morsoth/TFG-FIB/latex/anexo.tex

\appendix
\chapter{Anexo}
Aquí se recogen los documentos y evidencias complementarias que apoyan el contenido del informe.

\includepdf[pages=-,fitpaper=true]{pdfs/PCB Main - Schematic.pdf}

\includepdf[pages=-,fitpaper=true]{pdfs/PCB Main - Layout.pdf}

\includepdf[pages=-,fitpaper=true]{pdfs/Lanza 3D.pdf}
