morsoth/TFG-FIB/latex/references.tex

\begin{thebibliography}{99}

    \bibitem{fib} FIB.
    \textit{Facultad de Informática de Barcelona.} \\
    \url{https://www.fib.upc.edu/}

    \bibitem{upc} UPC.
    \textit{Portal de la Universitat Politécnica de Catalunya.} \\
    \url{https://www.upc.edu/}

    \bibitem{domo21} Domo21.
    \textit{} \\
    \url{https://www.sicma21.com/}
    
    \bibitem{kanban} Wikipedia Commons.
    \textit{Abstract Kanban Board.} \\
    \url{https://commons.wikimedia.org/wiki/File:Abstract_Kanban_Board.svg}

    \bibitem{github} GitHub.
    \textit{} \\
    \url{https://github.com/}

    \bibitem{trello} Trello.
    \textit{} \\
    \url{https://trello.com/}
    
    \bibitem{stm32wb55rg} STMicroelectronics.
    \textit{STM32WB55RG | Product.} \\
    \url{https://www.st.com/en/microcontrollers-microprocessors/stm32wb55rg.html}

    \bibitem{nucleo-wb55rg} STMicroelectronics.
    \textit{NUCLEO-WB55RG | Product.} \\
    \url{https://www.st.com/en/evaluation-tools/nucleo-wb55rg.html}
    
    \bibitem{lux-vs-wm2} EVOLUX.
    \textit{Lux vs W/m².} \\
    \url{https://evolux.cl/lux-vs-wm2}

    \bibitem{an2867} Application Note AN2867.
    \textit{Guidelines for oscillator design on STM8AF/AL/S and STM32 MCUs/MPUs.} \\
    \url{https://www.st.com/resource/en/application_note/an2867-guidelines-for-oscillator-design-on-stm8afals-and-stm32-mcusmpus-stmicroelectronics.pdf}

    \bibitem{an5042} Application Note AN5042.
    \textit{How to calibrate the HSE clock for RF applications on STM32 wireless MCUs.} \\
    \url{https://www.st.com/resource/en/application_note/an5042-how-to-calibrate-the-hse-clock-for-rf-applications-on-stm32-wireless-mcus-stmicroelectronics.pdf}
    
    \bibitem{an5129} Application Note AN5129.
    \textit{Guidelines for meander design using low-cost PCB antennae with 2.4 GHz radio for STM32WB/WB0 MCUs.} \\
    \url{https://www.st.com/resource/en/application_note/an5129-guidelines-for-meander-design-using-lowcost-pcb-antennae-with-24-ghz-radio-for-stm32wbwb0-mcus-stmicroelectron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}

    \bibitem{an6335} Application Note AN6335.
    \textit{MLPF-WB and MLPF-NRG PCB design guidelines and reference hardware.} \\
    \url{https://www.st.com/resource/en/application_note/an6335-mlpfwb-and-mlpfnrg-pcb-design-guidelines-and-reference-hardware-stmicroelectronics.pdf}
    
    \bibitem{an5165} Application Note AN5165.
    \textit{How to develop RF hardware using STM32WB microcontrollers.} \\
    \url{https://www.st.com/resource/en/application_note/an5165-how-to-develop-rf-hardware-using-stm32wb-microcontrollers-stmicroelectronics.pdf}

    \bibitem{spma056} Application Note SPMA056.
    \textit{System Design Guidelines for the TM4C129x Family of Tiva™ C Series Microcontrollers.} \\
    \url{https://www.ti.com/lit/an/spma056/spma056.pdf?ts=1767867045202}

    \bibitem{stm32_pinout} Arm Mbed.
    \textit{NUCLEO-WB55RG.} \\
    \url{https://os.mbed.com/platforms/ST-Nucleo-WB55RG/}
    
    \bibitem{impedance_calc} JLCPCB.
    \textit{Controlled Impedance Calculator.} \\
    \url{https://jlcpcb.com/pcb-impedance-calculator}
    
    \bibitem{jlcpcb_shop} JLCPCB.
    \textit{Assembly Parts Library.} \\
    \url{https://jlcpcb.com/parts/}

    \bibitem{ble_stack_github} GitHub.
    \textit{STMicroelectronics / STM32CubeWB.} \\
    \url{https://github.com/STMicroelectronics/STM32CubeWB/blob/master/Projects/STM32WB_Copro_Wireless_Binaries/STM32WB5x/stm32wb5x_BLE_Stack_full_fw.bin}
    
    \bibitem{stm32_sch} MB1355.
    \textit{NUCLEO-WB55RG schematic.} \\
    \url{https://www.st.com/resource/en/schematic_pack/mb1355-wb55rg-d01_schematic.pdf}

    \bibitem{stm32_datasheet} STM32WB55RG.
    \textit{Datasheet.} \\
    \url{https://www.st.com/resource/en/datasheet/stm32wb55cc.pdf}
    
    \bibitem{aem_datasheet} AEM10941.
    \textit{Datasheet.} \\
    \url{https://e-peas.com/documents/AEM10941/DS-AEM10941.pdf}

    \bibitem{ina_datasheet} INA3221.
    \textit{Datasheet.} \\
    \url{https://www.ti.com/lit/ds/symlink/ina3221.pdf}

    \bibitem{fram_datasheet} MB85RS256B.
    \textit{Datasheet.} \\
    \url{https://www.fujitsu.com/uk/Images/MB85RS256B.pdf}

    \bibitem{tsl_datasheet} TSL2591.
    \textit{Datasheet.} \\
    \url{https://cdn-shop.adafruit.com/datasheets/TSL25911_Datasheet_EN_v1.pdf}
    
    \bibitem{dfr_datasheet} DS18B20.
    \textit{Datasheet.} \\
    \url{https://www.analog.com/media/en/technical-documentation/data-sheets/ds18b20.pdf}
    
    \bibitem{sen_datasheet} SEN0308.
    \textit{Datasheet.} \\
    \url{https://www.farnell.com/datasheets/4376694.pdf}
    
\end{thebibliography}
