morsoth/TFG-FIB/latex/portada.tex

\begin{titlepage}
    \begin{center}
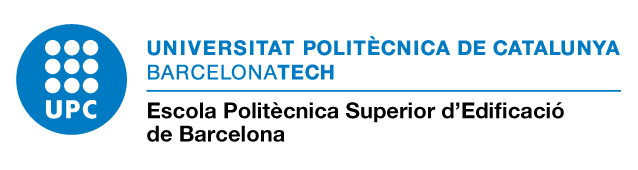
[picture p85: latex/imgs/logo_upc.png]
         
         \hspace{1cm}
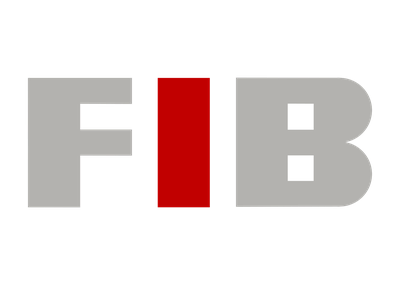
[picture p86: latex/imgs/logo_fib.png]
         
         
         \vspace{6cm}
        
         \large TFG - Memoria \numeroEntrega
        
         \vspace{0.4cm}
        
         \Large \textbf{\tituloTFG}
        
         \vspace{1cm}
        
         \large \autorTFG
        
         \vspace{0.4cm}
        
         \small \fechaEntrega
        
         \vfill
        
         \small Especialidad en Ingeniería de Computadores
        
         \vspace{1cm}
        
         \begin{tabular}{rl}
             \small \textbf{Director:}&\director
         \end{tabular}
    \end{center}
\end{titlepage}
