morsoth/TFG-FIB/multimedia/portada.pdf

id197984

# DISSENY, DESENVOLUPAMENT I PROGRAMACIÓ D'UNA LLANÇA METEOROLÓGICA

PAU ZARAGOZA GALLARDO

Director/a
ANTONIO BENITO MARTÍNEZ VELASCO (Departamento de Ingeniería de Sistemas, Automática e Informática Industrial)

Titulación
Grado en Ingeniería Informática (Ingeniería de Computadores)

Memoria del trabajo de fin de grado

Facultat d'Informàtica de Barcelona (FIB)

Universitat Politècnica de Catalunya (UPC) - BarcelonaTech

20/01/2026
