morsoth/TFG-FIB/latex/imgs/stm32_osc.png

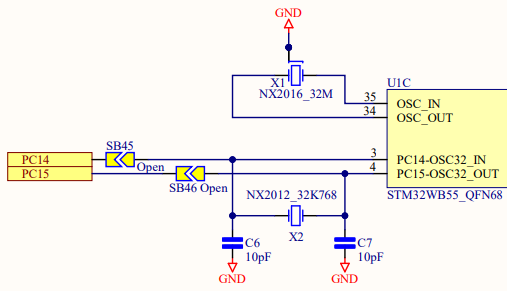
latex/imgs/stm32_osc.png
