morsoth/TFG-FIB/multimedia/photo/circuit_6.jpg

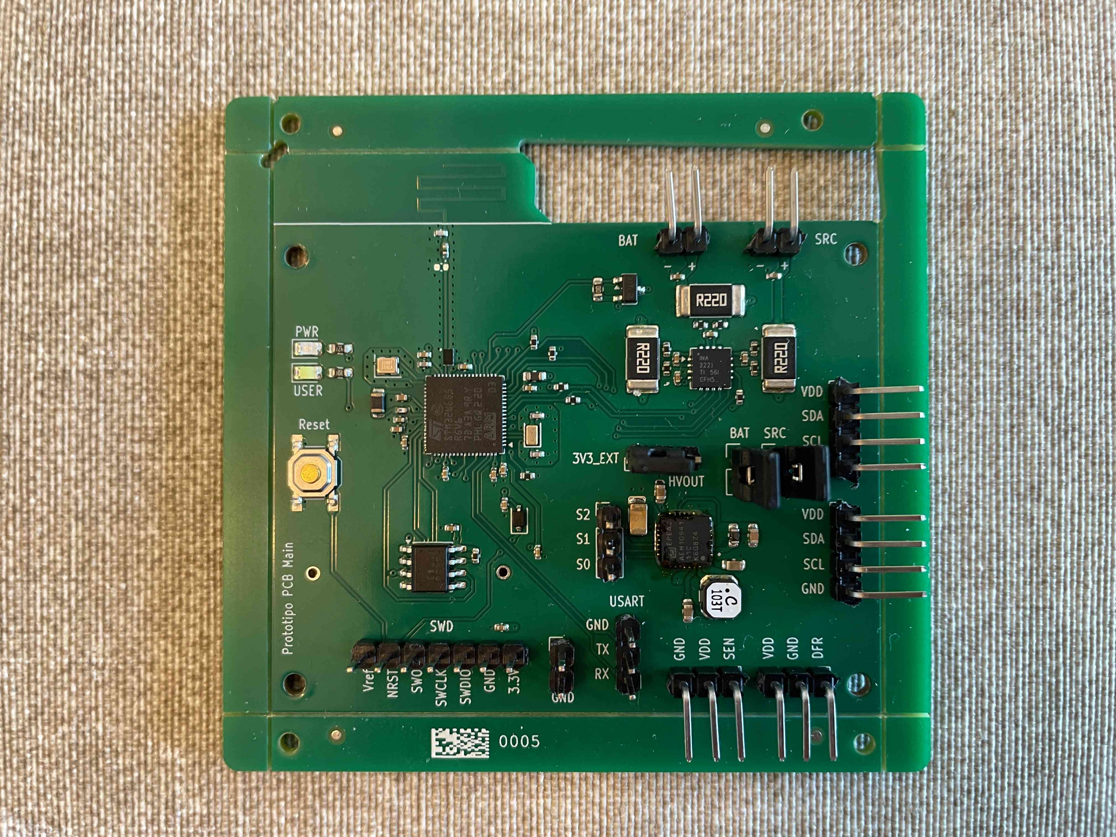
multimedia/photo/circuit_6.jpg
