morsoth/TFG-FIB/docs/Nucleo-WB55RG/Bill of Materials/MB1355-WB55RG-D01_BOM.xlsx

 |  |  |  | Bill of materials
 |  |  |  | Board reference: | MB1355
 |  |  |  | Variant: | WB55
 |  |  |  | PCB revision: | D
 |  |  |  | Assembly revision: | 01
 |  |  |  | Date: | 16-Nov-2020
Designator | Description | Value | Package | Manufacturer | Manufacturer_Part_Number | Fitted | Quantity
C1, C2, C34 | Capacitor, MLCC, 100pF, 50V, NPO, 5%, 0402, T=0,5mm | 100pF | C0402 | YAGEO | CC0402JRNPO9BN101 | Fitted | 3
C3, C12, C14, C16, C17, C18, C19, C20, C24, C25, C26, C27, C28, C31, C32, C33, C41, C42, C43, C46, C47, C48, C49, C50 | Capacitor_not polarized | 100nF | C0402 | YAGEO | 'CC0402KRX7R7BB104 | Fitted | 24
C6, C7 | Capacitor_not polarized | 10pF | C0402 | YAGEO | CC0402JRNPO9BN100 | Fitted | 2
C8 | Capacitor_not polarized | 100nF/25V | C0402 |  |  | Fitted | 1
C9, C10 | Condensateur_polarise | 10uF/25V | C1210 | TDK | C3225X7R1H106M250AC | Fitted | 2
C11 | Condensateur_polarise | 4.7uF/10V | C1210 | AVX | 12101Z475MAT2A | Fitted | 1
C13, C15, C21, C22 | Capacitor_not polarized | 1uF/X5R | C0603 | YAGEO | CC0603KRX5R7BB105 | Fitted | 4
C23, C29 | Capacitor_not polarized | 4.7uF | C0402 | MURATA | GRM155R60J475ME87 | Fitted | 2
C37 | Capacitor_not polarized | 1.2pF | C0402 | MURATA | GJM1555C1H1R2WB01D | Fitted | 1
C44, C45 | Capacitor_not polarized | 20pF | C0402 | YAGEO | CC0402JRNPO9BN200 | Fitted | 2
CN1, CN15 | USB-MICRO-B, 1050170001, SMT, MOLEX | 1050170001 | USBMICROB | MOLEX | 1050170001 | Fitted | 2
CN5 | Header F 1x10x2.54 TH V | HEADER_1X10 | Header F 1x10x2.54 TH V | SAMTEC | SSW-110-01-F-S SSW-110-01-L-S SSW-110-01-G-S | Fitted | 1
CN6, CN9 |  | HEADER_1X8_F | Header F 1x8x2.54 TH V | SAMTEC | SSW-108-01-F-S SSW-108-01-L-S SSW-108-01-G-S | Fitted | 2
CN7, CN10 |  | HEADER_2X19_M | Header M 2x19x2.54 TH M_top + M_bottom | SAMTEC | TSW-119-09-F-D TSW-119-09-L-D TSW-119-09-G-D | Fitted | 2
CN8 |  | HEADER_1X6 | Header F 1x6x2.54 TH V | SAMTEC | SSW-106-01-F-S SSW-106-01-L-S SSW-106-01-G-S | Fitted | 1
CN11, CN12, JP2, JP3, JP4, JP6 |  | HEADER_1X2 | Header M 1x2x2.54 TH V | SAMTEC | TSW-102-07-F-S TSW-102-07-L-S TSW-102-07-G-S | Fitted | 6
D1 | Schottky Diode | BAT54KFILM | SOD523 | ST | BAT54KFILM | Fitted | 1
D2 | Default Diode | BAT60JFILM | SOD-323 | ST | BAT60JFILM | Fitted | 1
JMP1, JMP2, JMP3, JMP4, JMP5, JMP6, JMP7, JMP8, JMP9, JMP10, JMP11, JMP12 | Jumper 2.54mm | SNT-100-BK-G | Jumper 2.54mm BLACK | SAMTEC | SNT-100-BK-G | Fitted | 12
JP1 |  | HEADER_2X4 | Header M 2x4x2.54 TH V | SAMTEC | TSW-104-07-F-D TSW-104-07-L-D TSW-104-07-G-D | Fitted | 1
JP5 |  | HEADER_2X8 | Header M 2x8x2.54 TH V | SAMTEC | TSW-108-07-F-D TSW-108-07-L-D TSW-108-07-G-D | Fitted | 1
L1 | Coil Wurtz 10uH ref: 74479777310A | 10uH | 2x1.25x1.2 mm | WURTH | 74479777310A | Fitted | 1
L2 | SMD Chip ferrite bead, 600R@100MHz +/-25%, 350mA, 500mohm DC, 0603, T=0.8mm | 600R@100MHz | 0603 | TAI-TECH | FCM1608KF-601T03 | Fitted | 1
L3 | Inductor, LQG15H, 3.6nH, +-0.3nH 0402 | 3.6nH | L0402 | MURATA | LQG15HS3N6S02 | Fitted | 1
L4 | Resistor, 0R, 0402 | 0R | 0402 | YAGEO | RC0402JR-070RL | Fitted | 1
L5 | inductor, 10nH +-2%, 100mA max,1.3 ohm DC max, Q min = 13,0402 | 10nH | L0402 | MURATA | LQP15MN10NG02 | Fitted | 1
LED1 | LED Blue, 0603 SMD, 3.3 V Forward Voltage | BLUE | LED 0603 | VISHAY | VLMB1300-GS08 | Fitted | 1
LED2 | LED Green, 0603 SMD, Fw Voltage = 2.8V - 3.6V | TRUE GREEN | LED 0603 | VISHAY | VLMTG1300-GS08 | Fitted | 1
LED3, LED4, LED5 | LED Red, 0603 SMD, 2V Forward Voltage | RED | LED 0603 | VISHAY | VLMS1300-GS08 | Fitted | 3
LED6 | LED Bicolor | LD_BICOLOR_CMS |  | AVAGO | HSMF-A201-A00J1 | Fitted | 1
Q1 | NPN Bipolar Transistor | NPN SOT23 | SOT23 | ON SEMI | BSR14 | Fitted | 1
R1, R19, R23, R24, R32 | Resistor,100K,0402,1%,1/16W | 100K | R0402 | YAGEO | RC0402FR-07100KL | Fitted | 5
R2, R3, R4 | Resistor,680R,0402,1%,1/16W | 680R | R0402 | YAGEO | RC0402FR-07680RL | Fitted | 3
R5 | Resistor, 0R, 0402 | 0R | R0402 | YAGEO | RC0402JR-070RL | Fitted | 1
R6, R11, R16, R18, R22 | Resistor,10K,0402,1%,1/16W | 10K | R0402 | YAGEO | RC0402FR-0710KL | Fitted | 5
R7, R8, R9, R10, R12, R33 | Resistor,1K,0402,1%,1/16W | 1K | R0402 | YAGEO | RC0402FR-071KL | Fitted | 6
R14 | Resistor,2K7,0402,1%,1/16W | 2K7 | R0402 | YAGEO | RC0402FR-072K7L | Fitted | 1
R15, R26, R28 | Resistor,4K7,0402,1%,1/16W | 4K7 | R0402 | YAGEO | RC0402FR-074K7L | Fitted | 3
R17, R25, R27, R29 | Resistor,100R,0402,1%,1/16W | 100R | R0402 | YAGEO | RC0402FR-07100RL | Fitted | 4
R20 | Resistor,36K,0402,1%,1/16W | 36K | R0402 | YAGEO | RC0402FR-0736KL | Fitted | 1
R21 | Resistor,1K5,0402,1%,1/16W | 1K5 | R0402 | YAGEO | RC0402FR-071K5L | Fitted | 1
R31 | Resistor,10R,0402,1%,1/16W | 10R | R0402 | YAGEO | RC0402FR-0710RL | Fitted | 1
SB1, SB5, SB8, SB9, SB11, SB12, SB14, SB15, SB17, SB26, SB32, SB33, SB35, SB36, SB38, SB39, SB41, SB47, SB50 | Resistor, 0R, 0402 | 0R | R0402 | YAGEO | RC0402JR-070RL | Fitted | 19
SC1, SC2, SC3, SC4 | shield clip Harwin S0951-46R to fix RF shielded cavity | S0951-46R |  | HARWIN | S0951-46R | Fitted | 4
SH1 | Shield | RF shield (17,2x17,2x3mm), Brass with Sn finishing, Sheet tickness : 0,2mm | RF shield (17,2x17,2x3mm) | "CUSTOM" | RF shield (17,2x17,2x3x0,2mm) See Description on PBS | Fitted | 1
STICKER_1 | Sticker for FCC_ID 16x5mm | FCC_ID_Sticker_16x5 | Sticker_FCC_ID 16x5mm |  | See Description on PBS | Fitted | 1
STICKER_2 | Sticker_BrdRef 21x5mm | Sticker_BrdRef_21x5 | Sticker_BrdRef_21x5mm |  | See Description on PBS | Fitted | 1
STICKER_3 | Sticker for CPN_FG 16x5mm | Sticker_CPN_FG 16x5 | Sticker_CPN_FG 16x5mm |  | See Description on PBS | Fitted | 1
SW1, SW2, SW3, SW4 | Push-button SMD | KMR231GLFS | SW-PB SMD KMR2 | C&K | KMR231GLFS | Fitted | 4
SW5 | SPDT RA SMT SLIDE SWITCH | SPDT RA SMT SLIDE SWITCH | MLL1200S | TE_Connectivity | MLL1200S | Fitted | 1
U1 | STM32WB55RGV6U | STM32WB55RGV6U | VFQFPN68_8x8x0.1_p0.4 | ST | STM32WB55RGV6U | Fitted | 1
U2 | IC REG LDO 5V 0.8A SOT223 | IC REG LDO 5V 0.8A SOT223 | SOT-223 | ST | LD1117S50TR | Fitted | 1
U3 | 3.3V voltage regulator 500mA | Low quiescent current and low noise voltage regulators | DFN6 3x3mm | ST | LD39050PU33R | Fitted | 1
U4 | Enhanced single channel power switches | 5V Power Switch, 0.85A, RDSon 130mOhm max, with active low enable pin | SOT23_5p | TI | TPS2041CDBVT | Fitted | 1
U5 | 3.3V low drop voltage regulator | Ultra low drop-low noise BiCMOS voltage, regulators low ESR capacitors compatible | LD3985M33R | ST | LD3985M33R | Fitted | 1
U6, U9 | Common mode filter with ESD protection for USB 2.0 interface | Common mode filter with ESD protection for USB 2.0 interface | ECMF02-2AMX6 | ST | ECMF02-2AMX6 | Fitted | 2
U7 | TXS0108E Bi-directional Level Shifter TSSOP20 | 8bits_bidirectionnal level shifter, Delay 312ns/1V8 | TXS0108EPWR | TEXAS INSTRUMENTS | TXS0108EPWR | Fitted | 1
U8 | Medium-density performance line ARM-based 32-bit MCU with 128KB Flash | Medium-density performance line ARM-based 32-bit MCU with 128KB Flash | STM32F103CBT6 | ST | STM32F103CBT6 | Fitted | 1
U10 | Buffer/Driver 1-CH Non-Inverting Open Drain CMOS Automotive 5-Pin TSSOP T/R | Buffer/Driver 1-CH Non-Inverting Open Drain CMOS Automotive 5-Pin TSSOP T/R | TSSOP5 | NEXPERIA | 74LVC1G07GW-Q100 | Fitted | 1
U11, U13 | High power transient voltage suppressor, 7V breakdown | High power transient voltage suppressor, 7V breakdown | D1610 | ST | ESDA7P60-1U1M | Fitted | 2
U12 | 2.4 GHz low pass filter matched to STM32WBx5Cx/Rx | 2.4 GHz low pass filter matched to STM32WBx5Cx/Rx | Bumpless CSP | ST | MLPF-WB55-01E3 | Fitted | 1
X1 | Crystal NDK 2.0x1.6mm 32 MHz | Crystal 32MHz, 8pF, +-10ppm, 60ohms max, SMD | NX2016SA | NDK | NX2016SA 32MHz EXS00A-CS06654 | Fitted | 1
X2 | Crystal NDK 2.0x1.2mm 32.768 KHz | Crystal 32.768kHz, 7pF, +-20ppm, 80Kohms max, SMD | NX2012SA | NDK | NX2012SA 32.768kHz EXS00A-MU00389 | Fitted | 1
X3 | Crystal 8MHz, 8pF, +-20ppm, 500ohms max, SMD | Crystal 8MHz, 8pF, +-20ppm, 500ohms max, SMD | NX3225GD | NDK | NX3225GD 8MHz EXS00A-CG04874 | Fitted | 1
HW1 | PCB MB1355D 4 Layers See Stacking description Solder Mask = White Silkscreen= Blue | MB1355D | N/A |  |  | Fitted | 1
C36, C39, C40 | Capacitor_not polarized |  | C0402 |  |  | Not Fitted | 3
CN3 | Header NF 1x5x2.54 TH | HEADER_1X5 | SIP 1x5x2.54 TH |  |  | Not Fitted | 1
CN4, CN14 | Header NF 1x2x2.54 TH | HEADER_1X2 | SIP 1x2x2.54 TH |  |  | Not Fitted | 2
CN13 |  | HEADER_1X6 | Header NF 1x6x2.54 TH |  |  | Not Fitted | 1
J2 |  | SMA | SMA_T_9.52_NF |  |  | Not Fitted | 1
R13 | Resistor | nc | R0402 |  |  | Not Fitted | 1
R30 | Resistor |  | 0402_RES |  |  | Not Fitted | 1
SB2, SB3, SB4, SB6, SB7, SB10, SB13, SB16, SB18, SB22, SB23, SB24, SB25, SB27, SB28, SB30, SB31, SB34, SB37, SB40, SB42, SB45, SB46, SB48, SB49, SB51 | Resistor, 0R, 0402 | 0R | R0402 | YAGEO | RC0402JR-070RL | Not Fitted | 26
SK_BT1 | Socket for CR2032 Battery | Battery Coin Cell holder, CR2032_20mm, Height 5.4mm | CR2032 holder | RENATA | SMTU2032-LF | Not Fitted | 0
