morsoth/TFG-FIB/docs/Nucleo-WB55RG/Board Manufacturing/MB1355D/MB1355.PcbDoc.htm

Reporting Options

# File in Previous Format

Date | : | 04/12/2025
Time | : | 10:30:36
Filename | : | C:\Users\pzaragoza\Documents\GitHub\TFG-FIB\docs\Nucleo-WB55RG\Board Manufacturing\MB1355D\MB1355.PcbDoc

Version | Warning

This file was generated by an earlier version of the software
