morsoth/TFG-FIB/pcb/Harvest Testing/Harvest Testing PCB Bottom.png

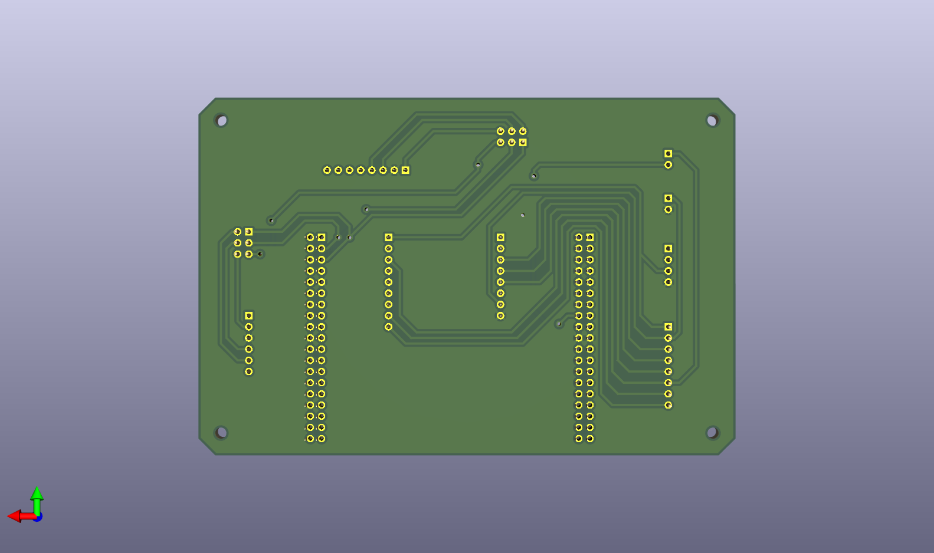
pcb/Harvest Testing/Harvest Testing PCB Bottom.png
