morsoth/TFG-FIB/pcb/Harvest Testing/Harvest Testing PCB Top.png

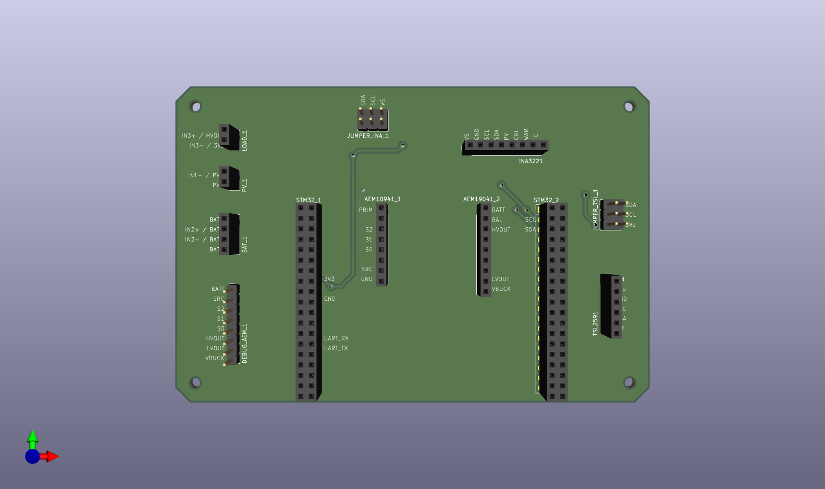
pcb/Harvest Testing/Harvest Testing PCB Top.png
