morsoth/TFG-FIB/latex/pdfs/PCB Main - Schematic.pdf

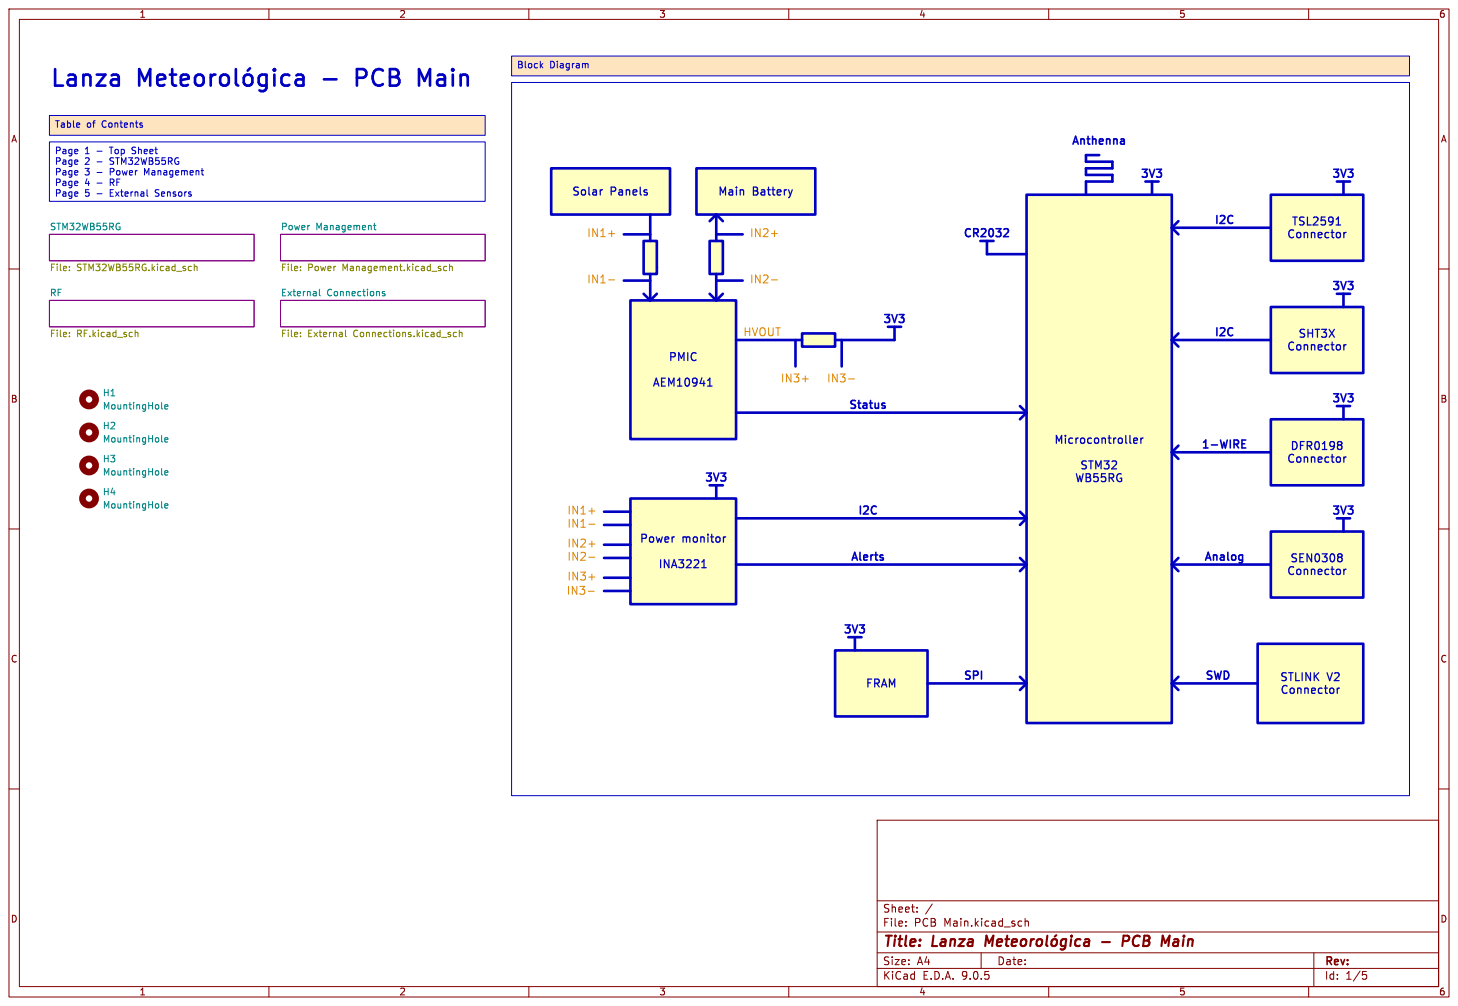
[picture p93: page 1]

Lanza þÿMeteorológica - PCB Main

Page 1 - Top Sheet Page 2 - STM32WB55RG

External Connections File: External Connections.kicad_sch Power Management File: Power Management.kicad_sch RF

File: STM32WB55RG.kicad_sch H1 MountingHole H2 MountingHole H3 MountingHole H4 MountingHole

Id: 1/5 Title: Lanza þÿMeteorológica - PCB Main

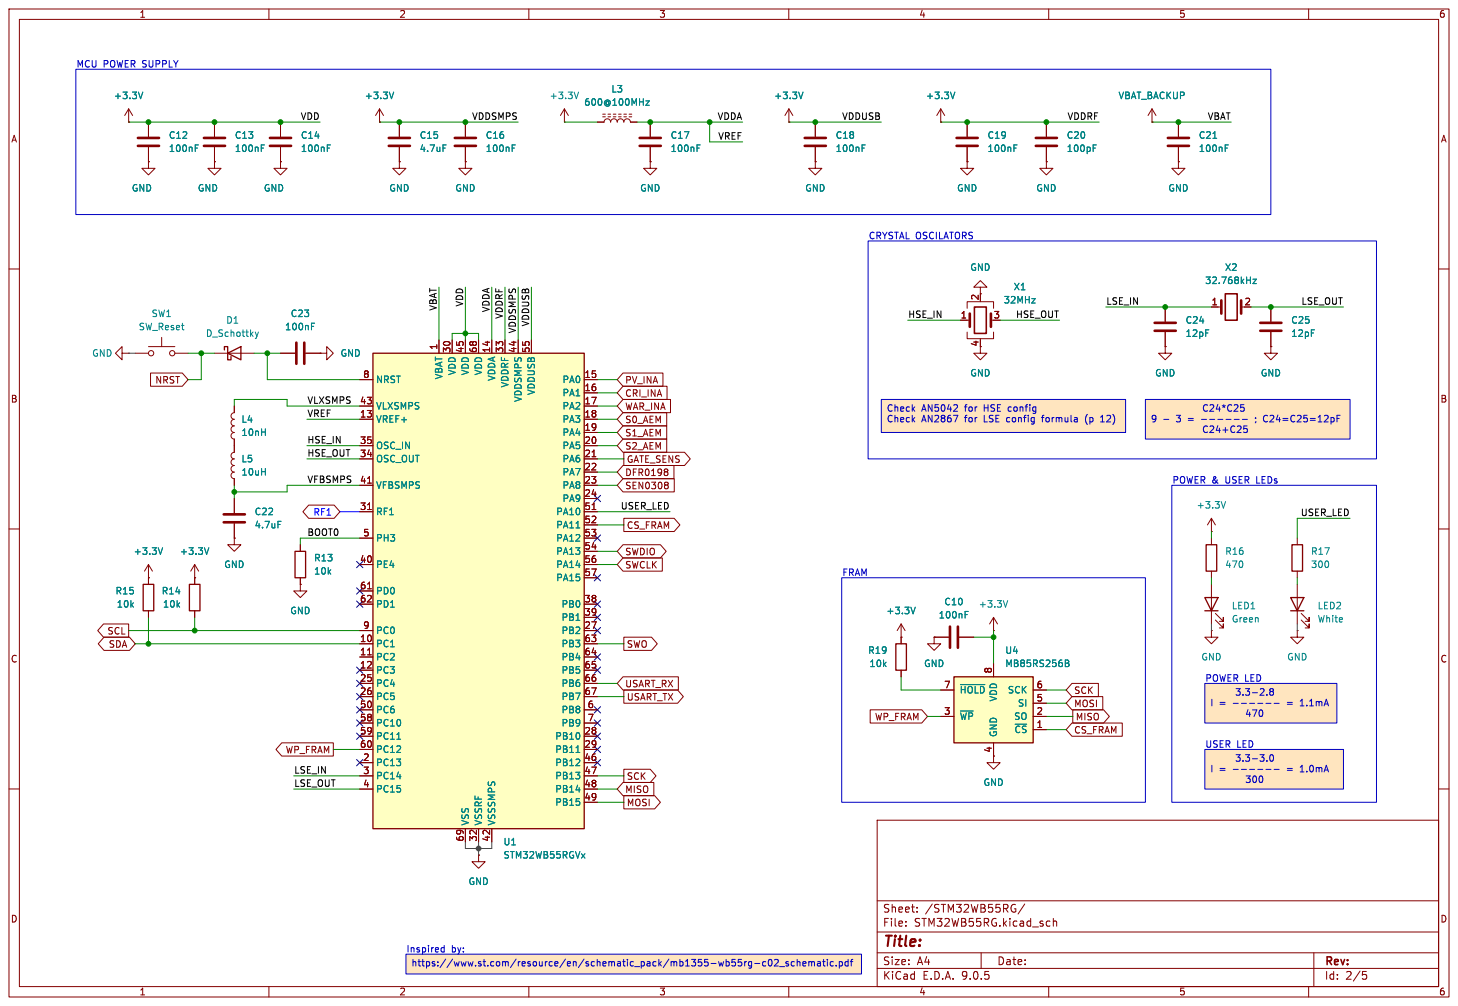
[picture p94: page 2]

POWER & USER LEDs POWER LED GND

1 VDD 30 VDD 45 VSS 69 VDD 68 VSSRF 32 VDDA 14 VSSSMPS 42 VDDRF 33 VDDSMPS 44 VDDUSB 55 PA0 15 PA1 16 PA2 17 PA3 18 PA4 19 PA5 20 PA6 21 PA7 22 PA8 23 PA9 24 PA10 51 PA11 52 PA12 53 PA13 54 PA14 56 PA15 57 PB0 38 PB1 39 PB2 27 PB3 63 PB4 64 PB5 65 PB6 66 PB7 67 PB8 6 PB9 7 PB10 28 PB11 29 PB12 46 PB13 47 PB14 48 PB15 49 U1STM32WB55RGVx

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

4 SCK 6 SI 5 SO 2 ~{CS}1 U4 MB85RS256B C10

4 SCK 6 SI 5 SO 2 ~{CS}1 C10

Id: 2/5 Title: File: STM32WB55RG.kicad_sch Sheet: /STM32WB55RG/ GND

Inspired by:
https://www.st.com/resource/en/schematic_pack/mb1355-wb55rg-c02_schematic.pdf

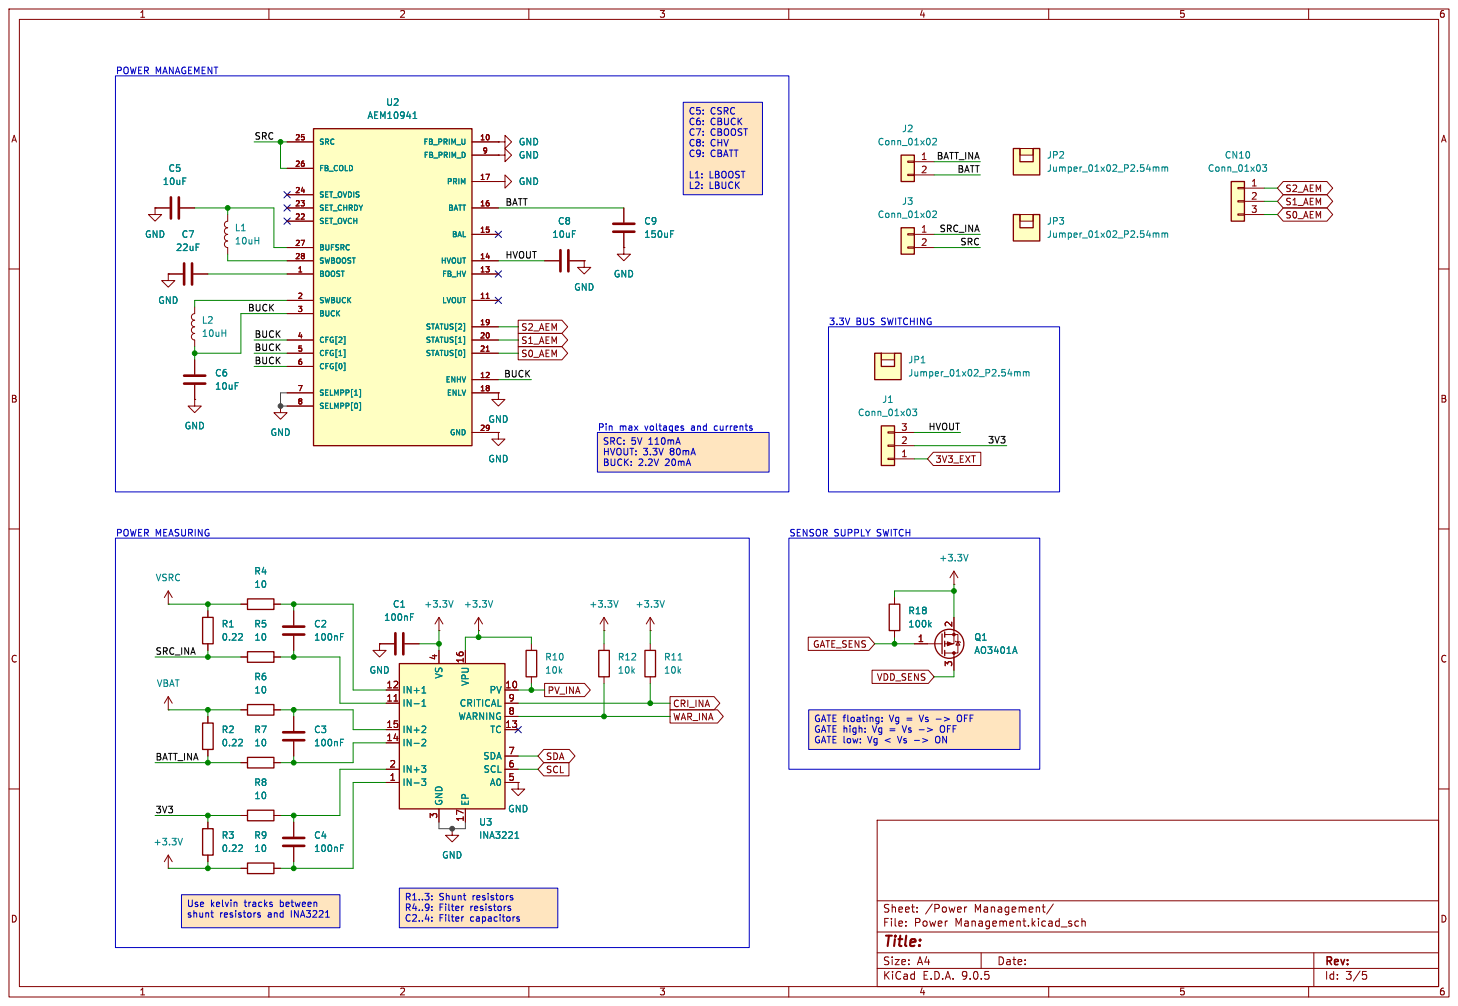
[picture p95: page 3]

BATT_INA C5: CSRC
C6: CBUCK C7: CBOOST C8: CHV C9: CBATT

BUCK: 2.2V 20mA R1..3: Shunt resistors R4..9: Filter resistors C2..4: Filter capacitors Use kelvin tracks between

3 VPU 16 EP 17 PV 10 CRITICAL 9 WARNING 8 TC 13 SDA 7 SCL 6 A0 5 U3

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

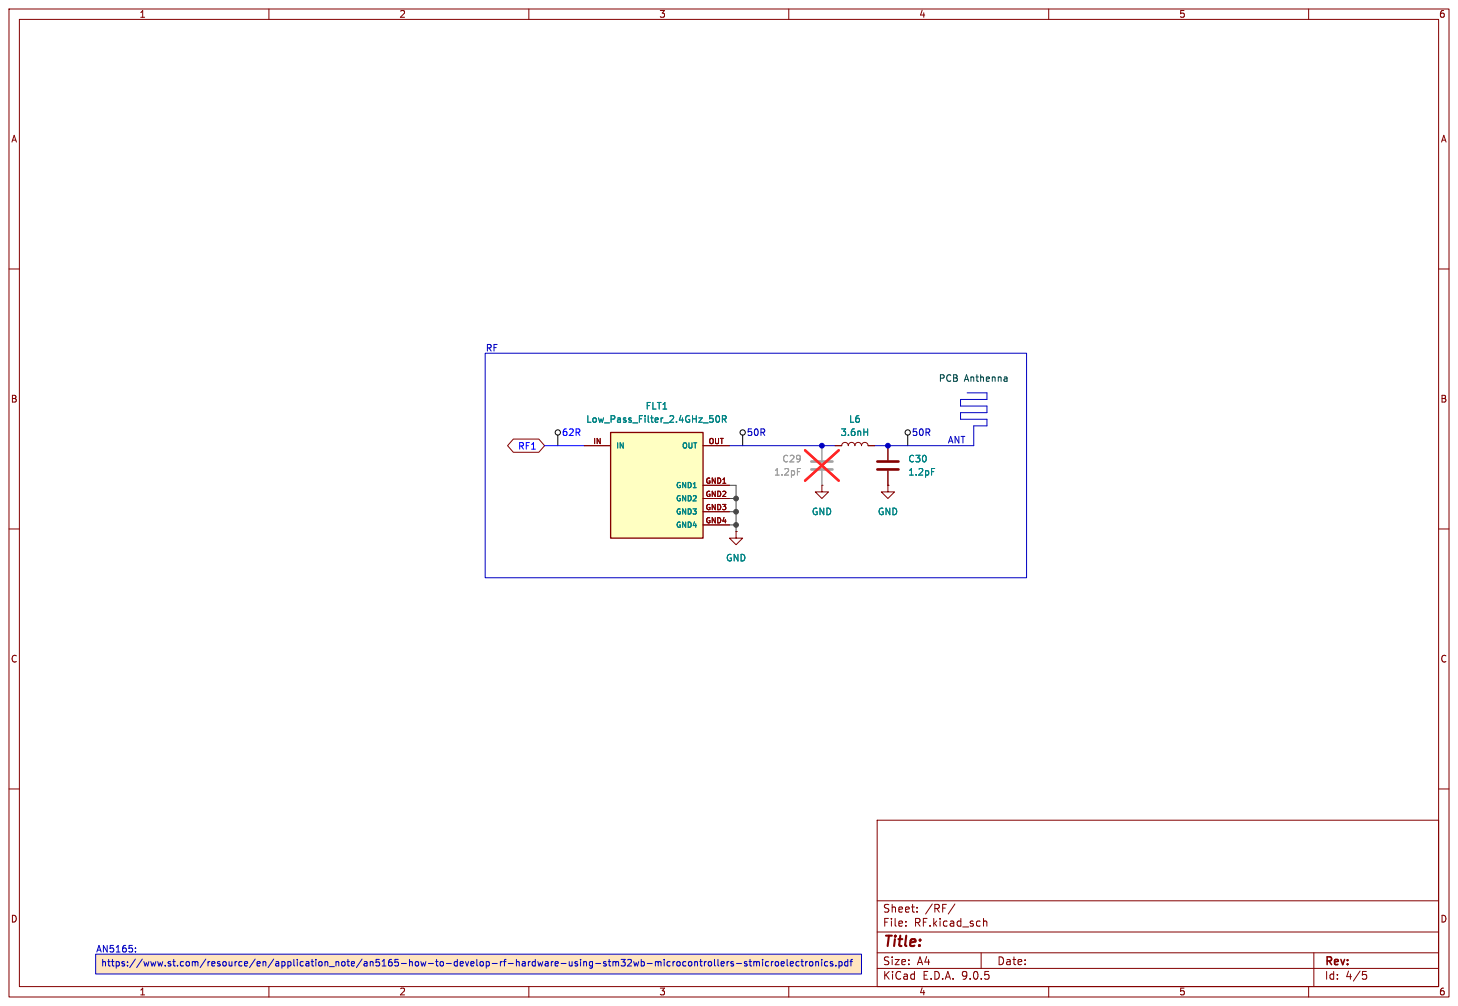
[picture p96: page 4]

Id: 4/5 Title: File: RF.kicad_sch Sheet: /RF/ C29

https://www.st.com/resource/en/application_note/an5165-how-to-develop-rf-hardware-using-stm32wb-microcontrollers-stmicroelectronics.pdf

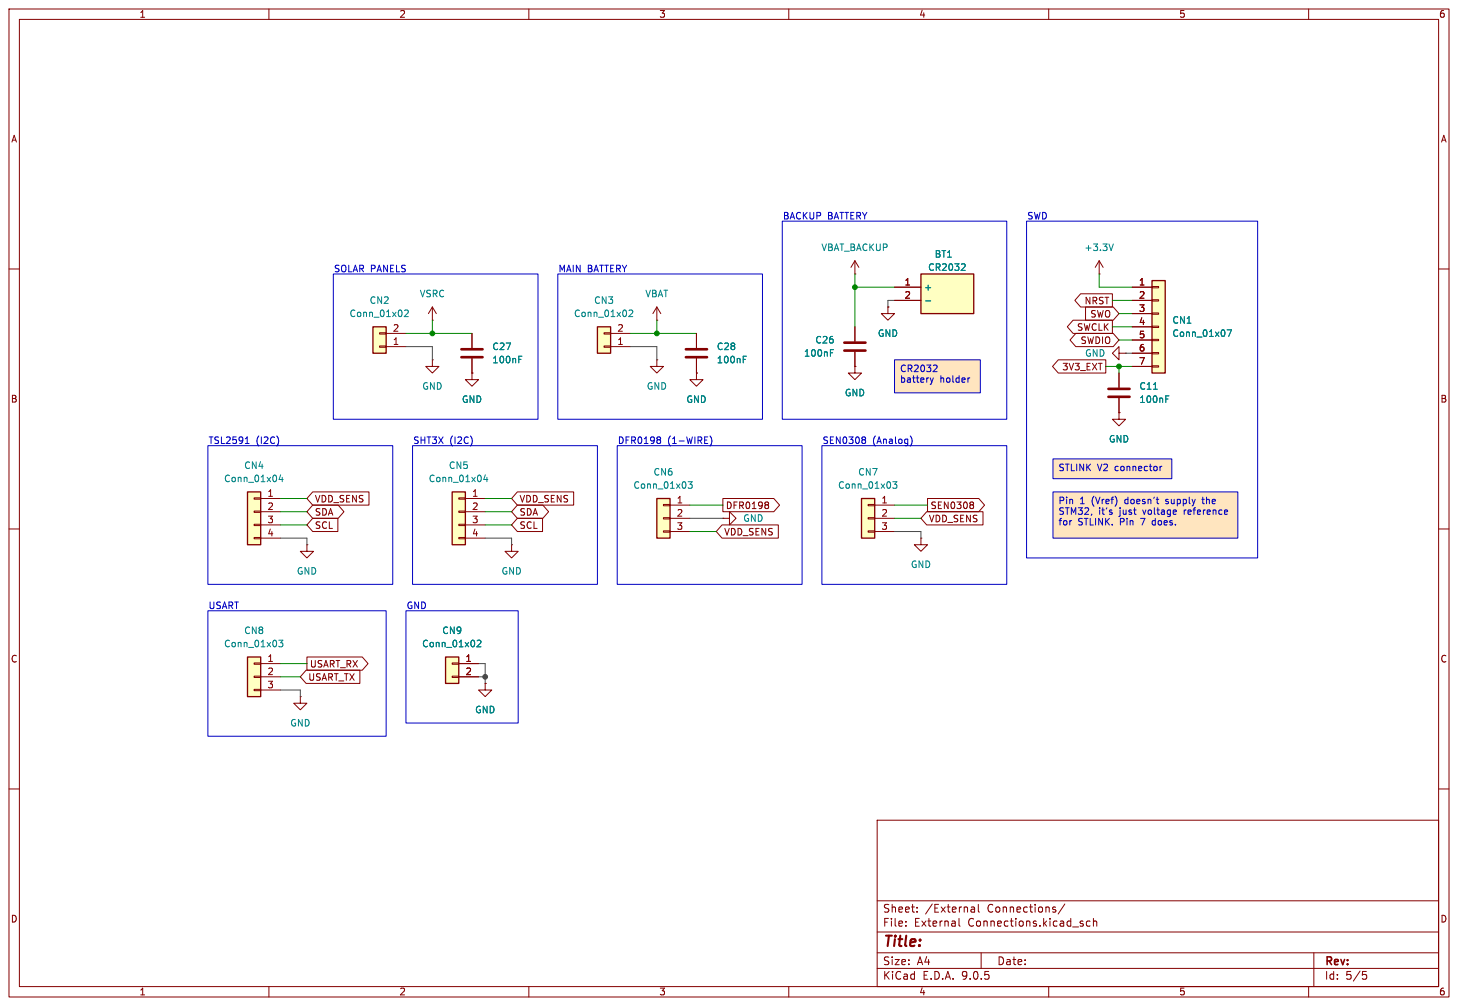
[picture p97: page 5]

for STLINK. Pin 7 does. GND
