morsoth/TFG-FIB/pcb/Harvest Testing/Harvest Testing.pdf

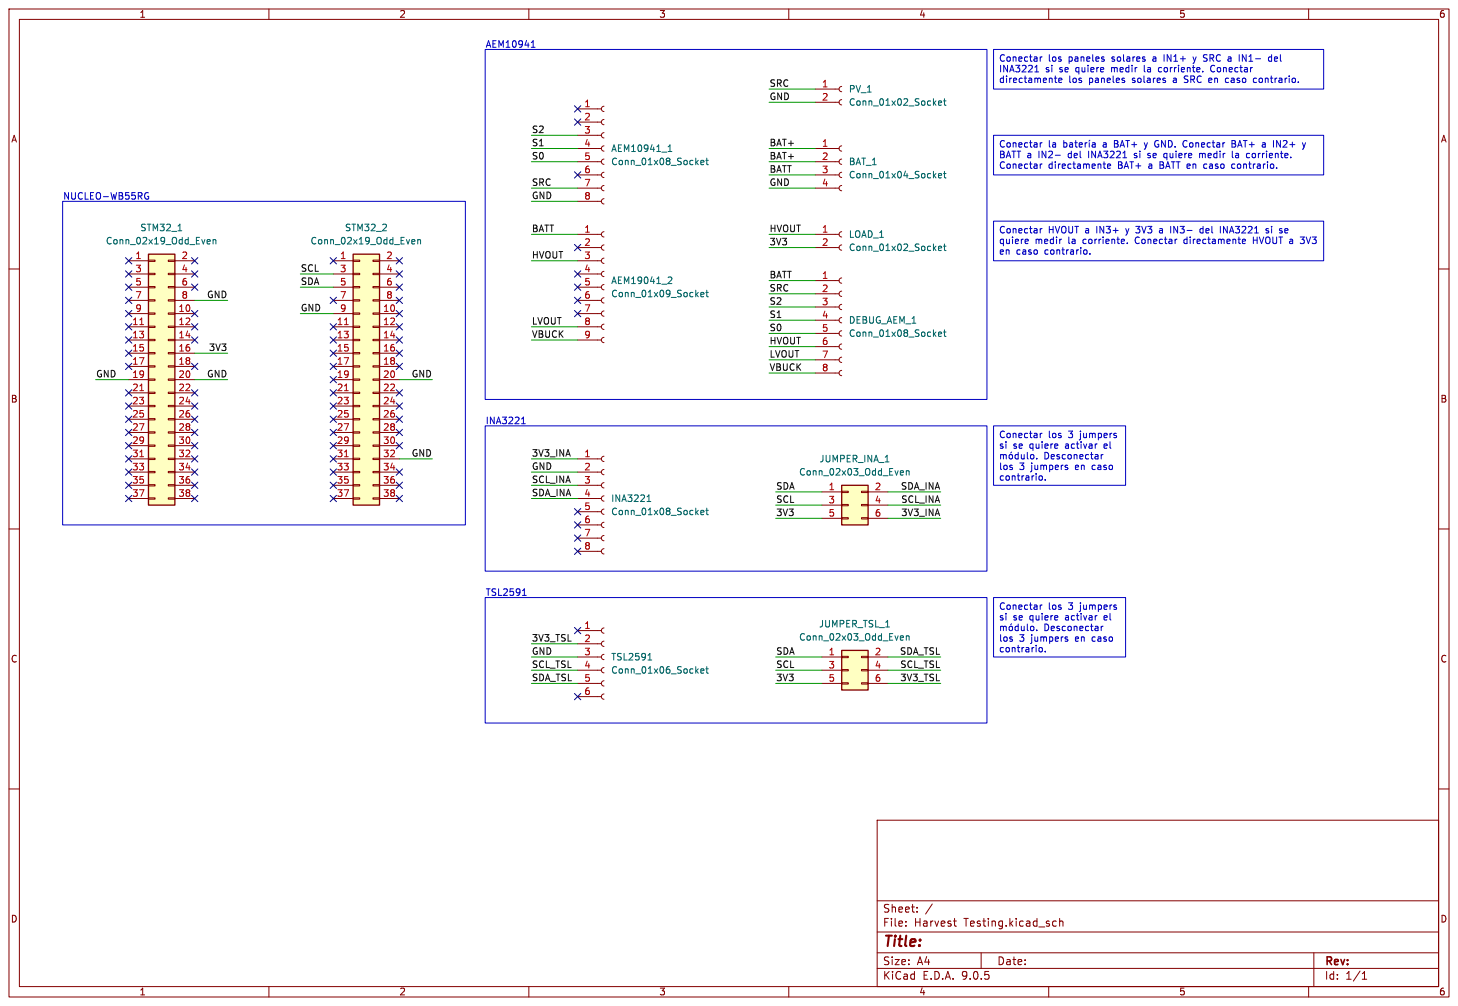
[picture p98: page 1]

SCL_TSL HVOUT GND GND GND

en caso contrario. Conectar los 3 jumpers

si se quiere activar el þÿmódulo. Desconectar

los 3 jumpers en caso

contrario.
