morsoth/TFG-FIB/pcb/Harvest Testing/Gerbers/Harvest Testing-B_Cu.pdf

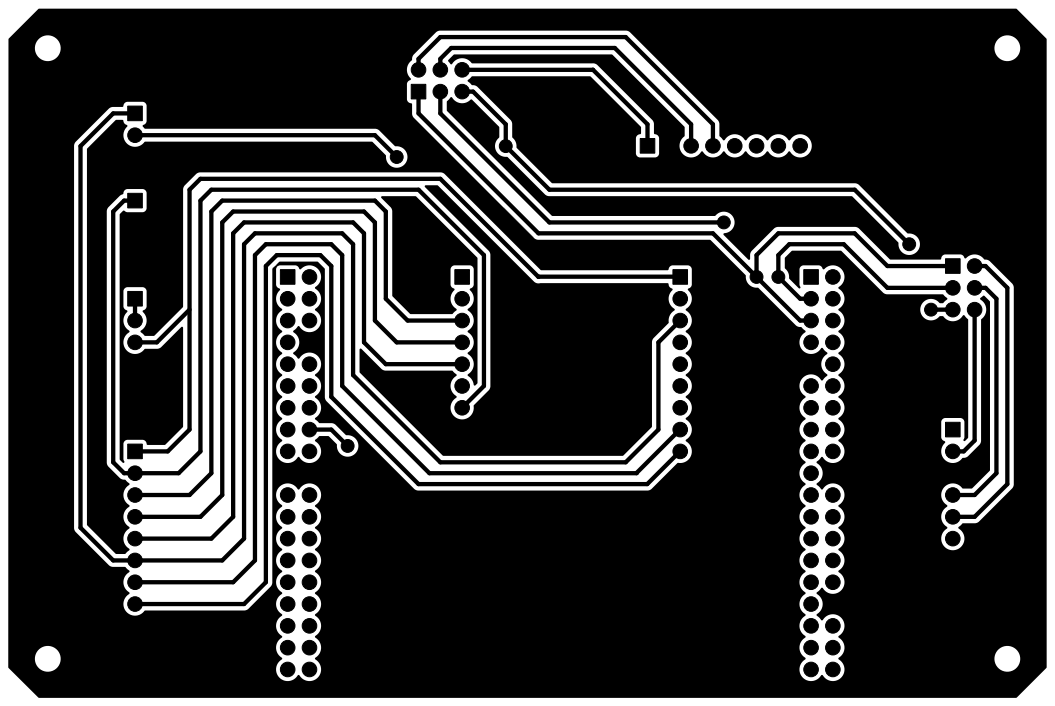
[picture p99: page 1]
