morsoth/TFG-FIB/pcb/Harvest Testing/Gerbers/Harvest Testing-Edge_Cuts.pdf

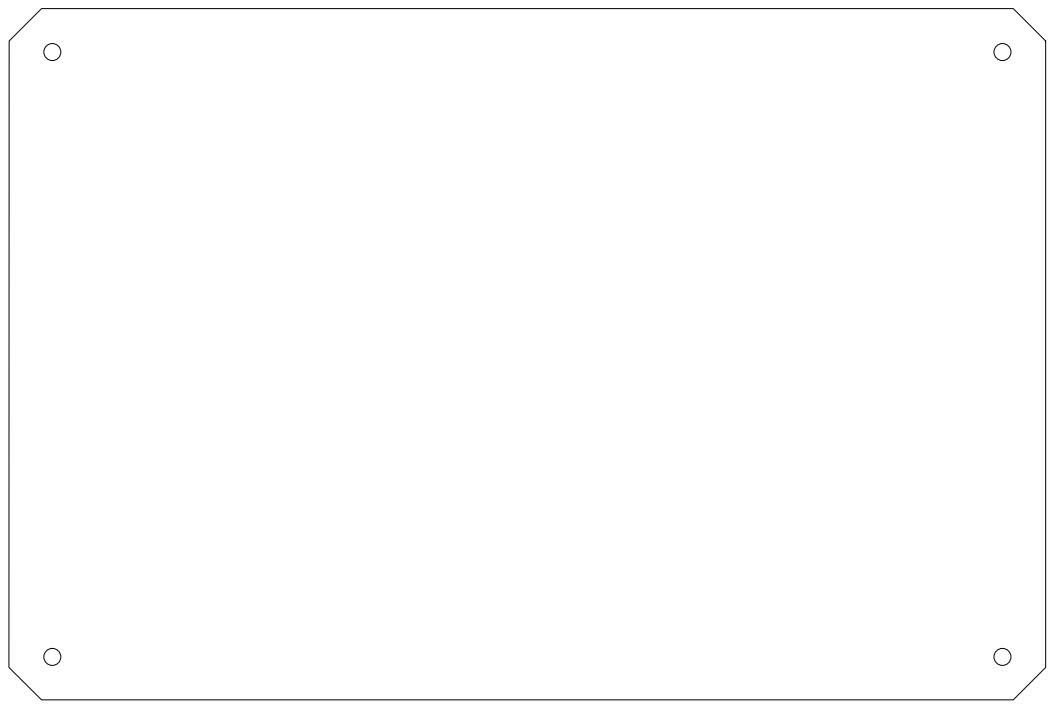
[picture p100: page 1]
