morsoth/TFG-FIB/pcb/Harvest Testing/Gerbers/Harvest Testing-F_Cu.pdf

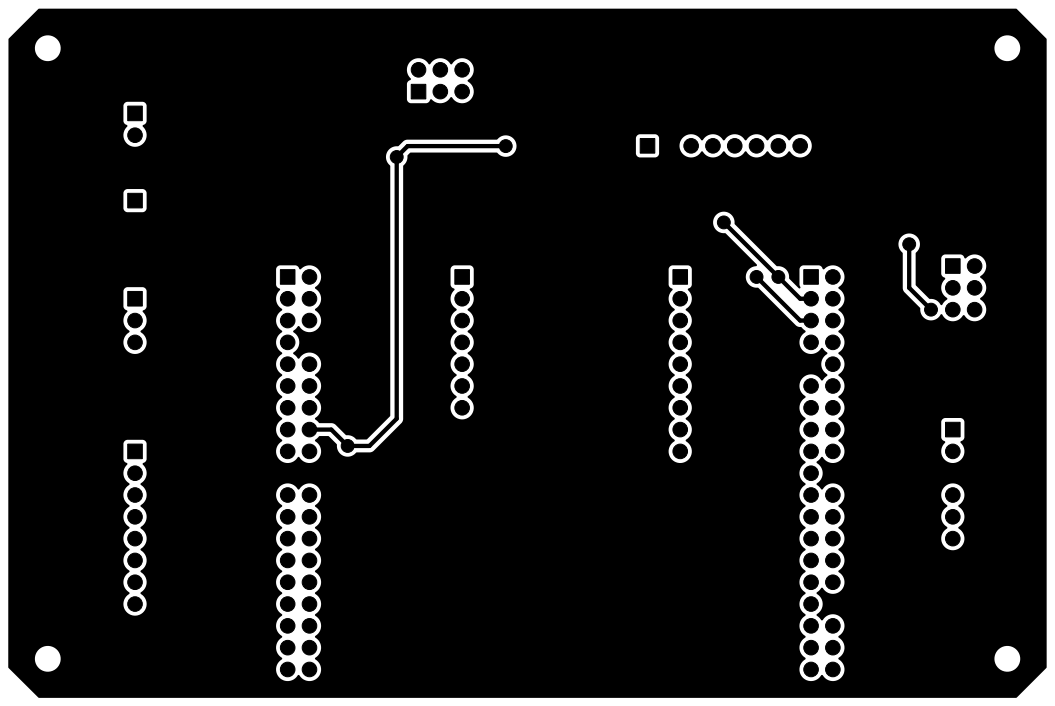
[picture p101: page 1]
