morsoth/TFG-FIB/pcb/Harvest Testing/Gerbers/Harvest Testing-F_Silkscreen.pdf

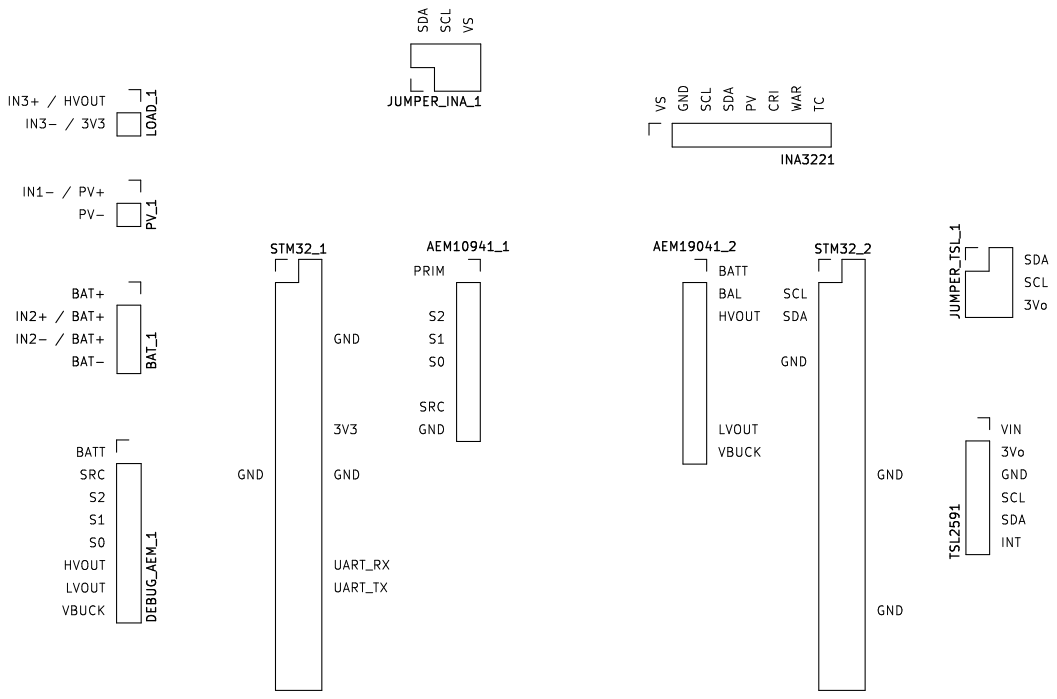
[picture p102: page 1]
