morsoth/TFG-FIB/docs/Nucleo-WB55RG/STM32WB55_QFN68_IPD_REF_BOARD/04-Plan d'équipement-pdf/Assembly_Top_STM32WB55_DB_QFN68_IPD.PDF

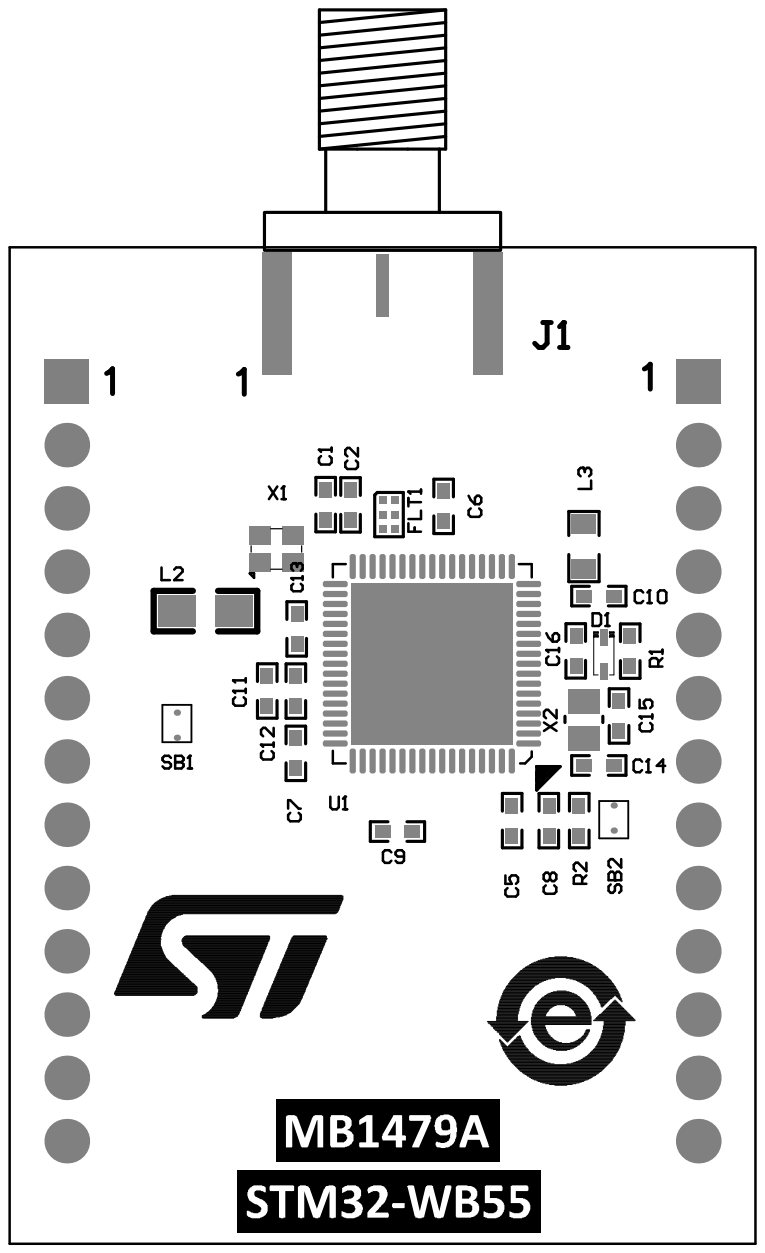
[picture p104: page 1]
