morsoth/TFG-FIB/latex/pdfs/Lanza 3D.pdf

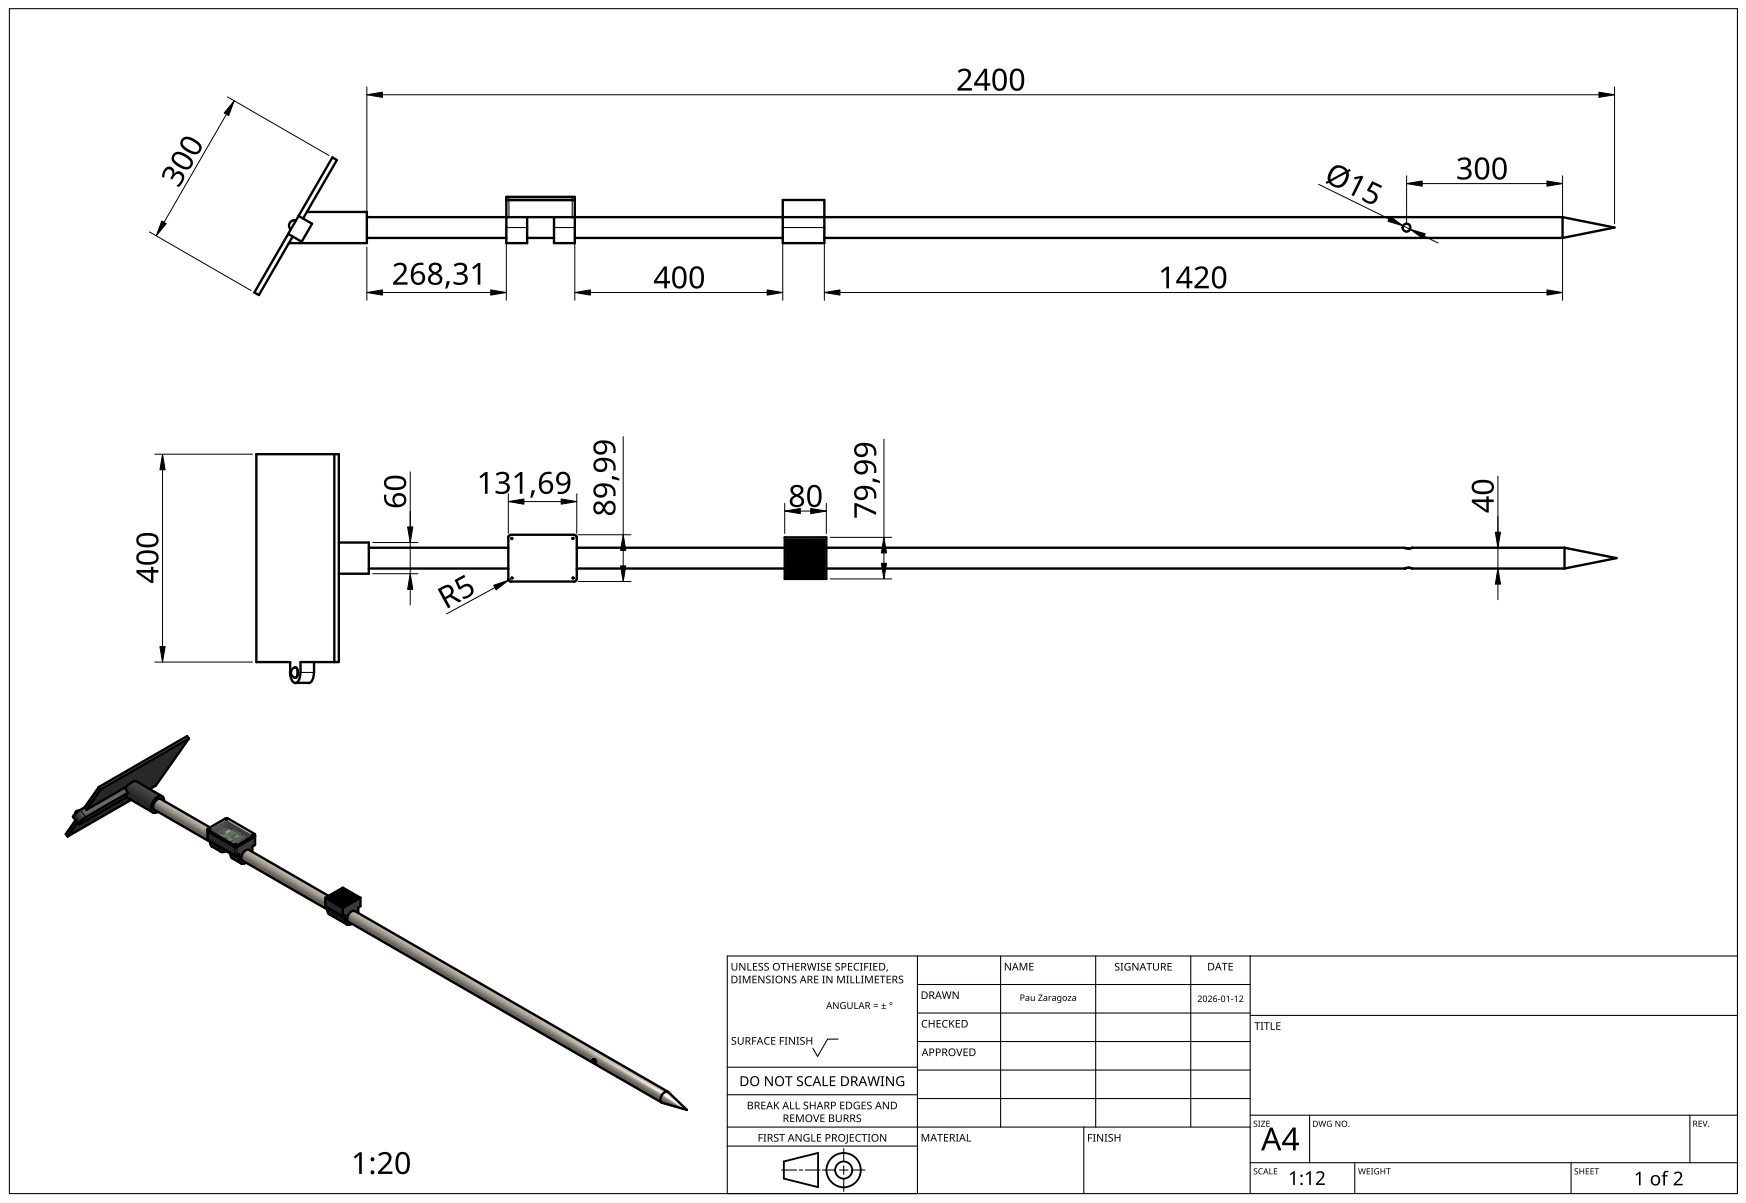
[picture p105: page 1]

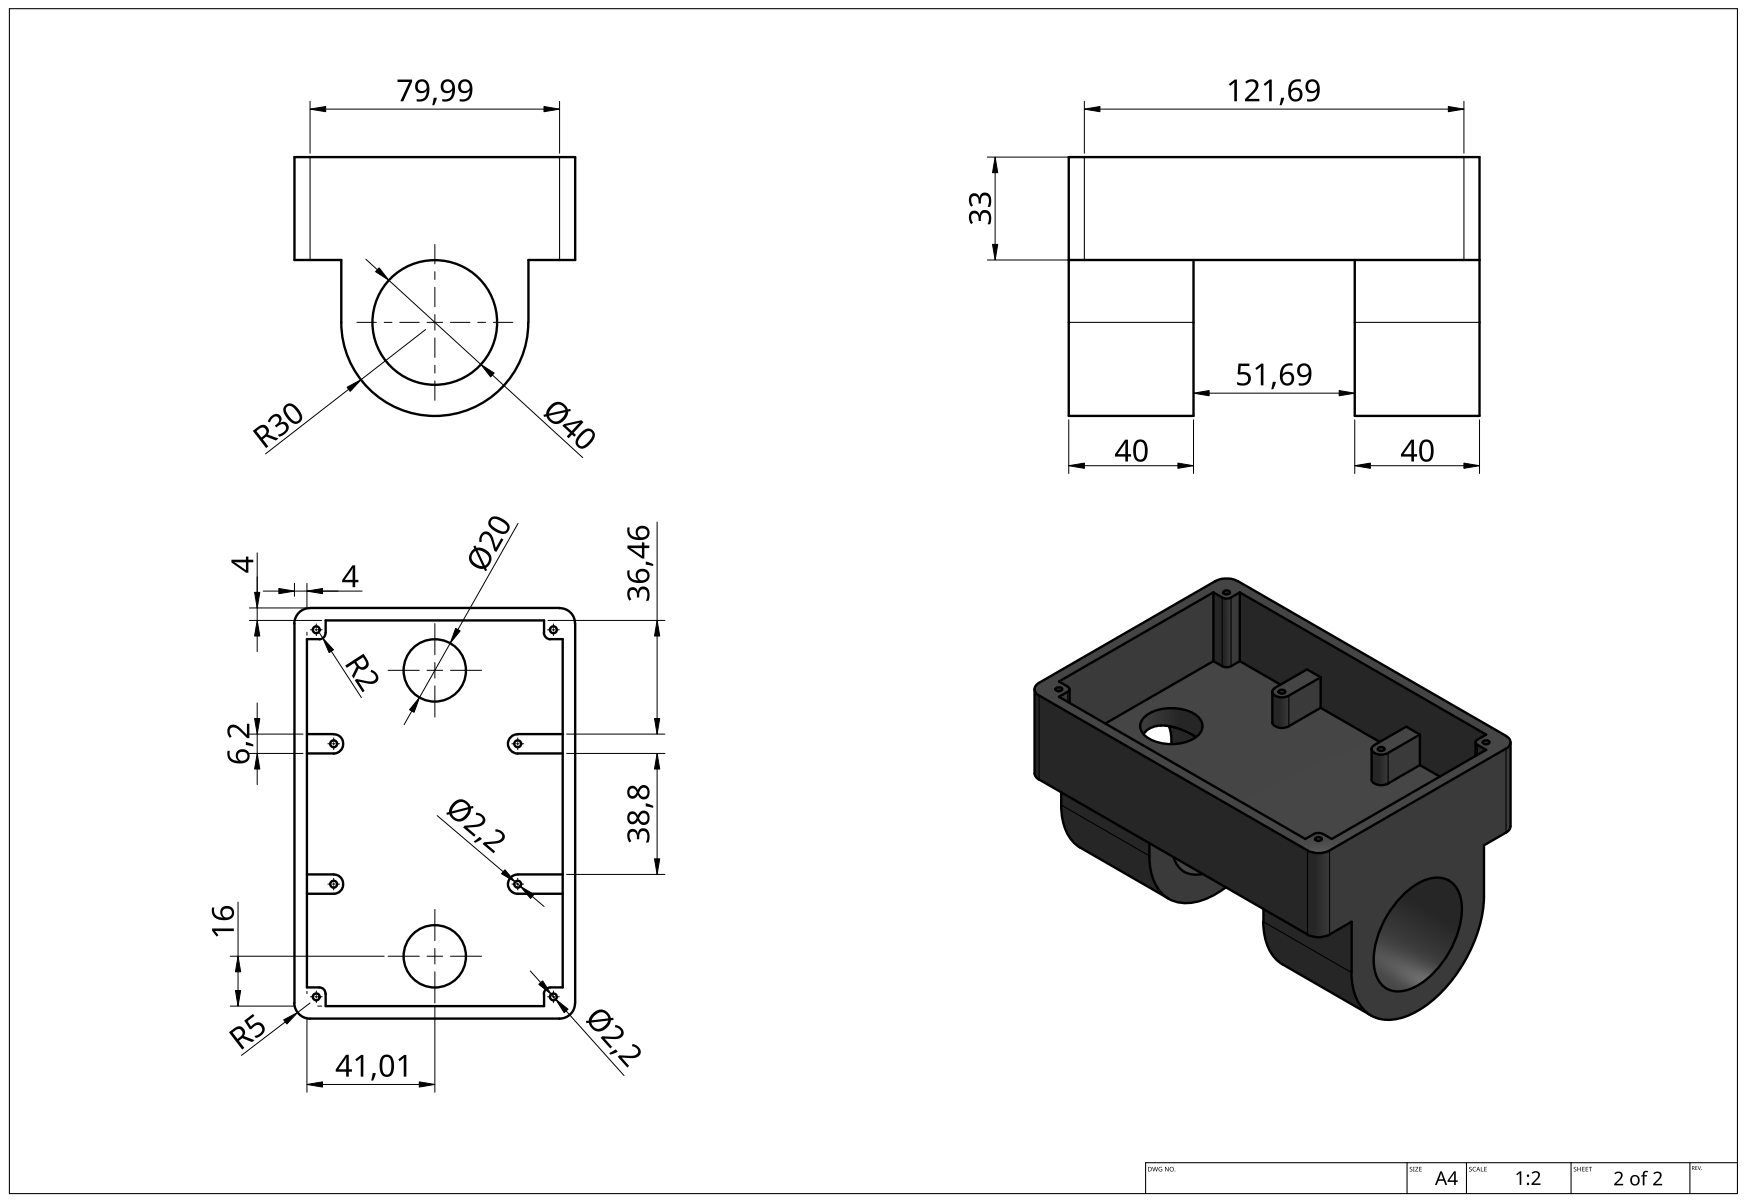
[picture p106: page 2]
