morsoth/TFG-FIB/latex/pdfs/PCB Main - Layout.pdf

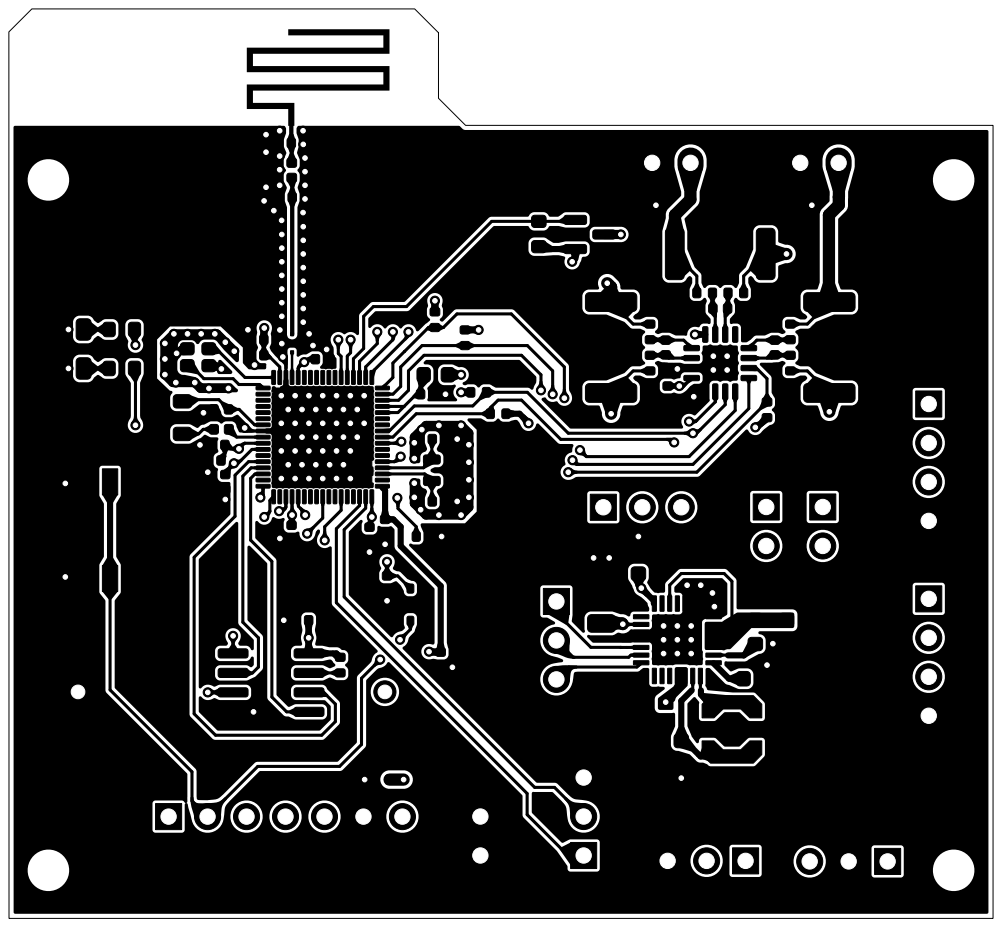
[picture p107: page 1]

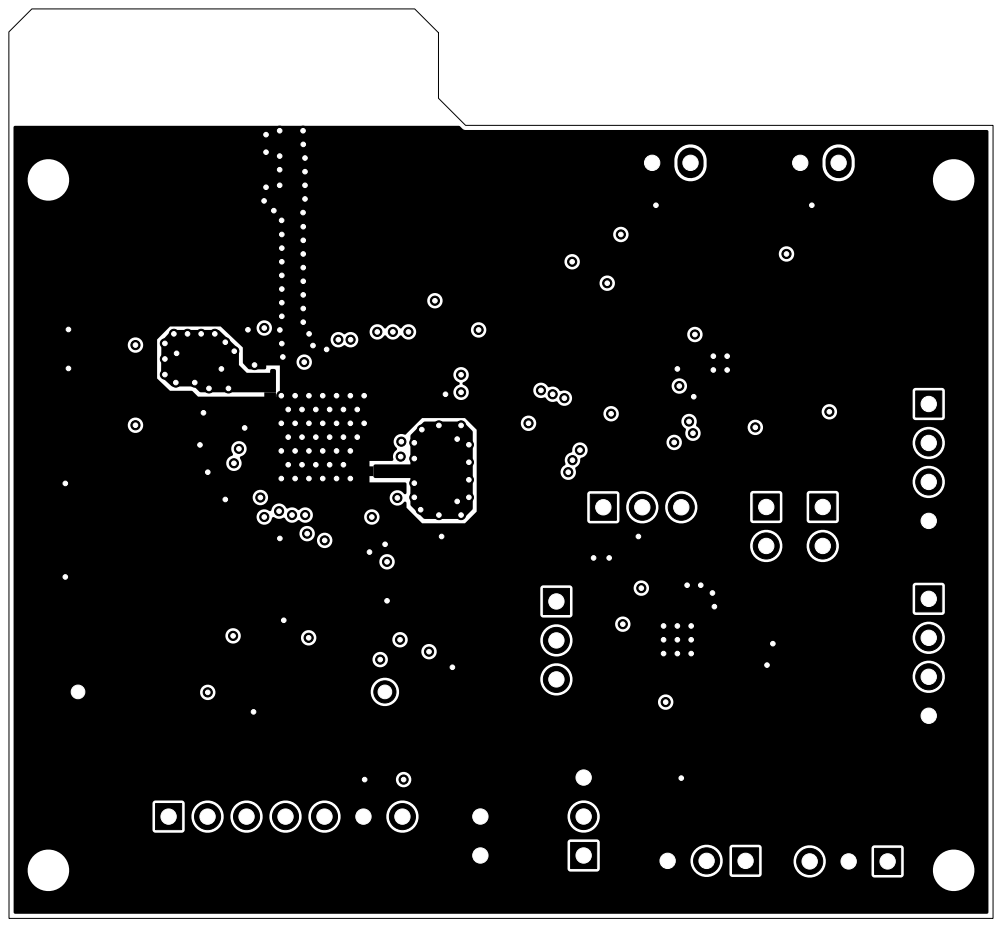
[picture p108: page 2]

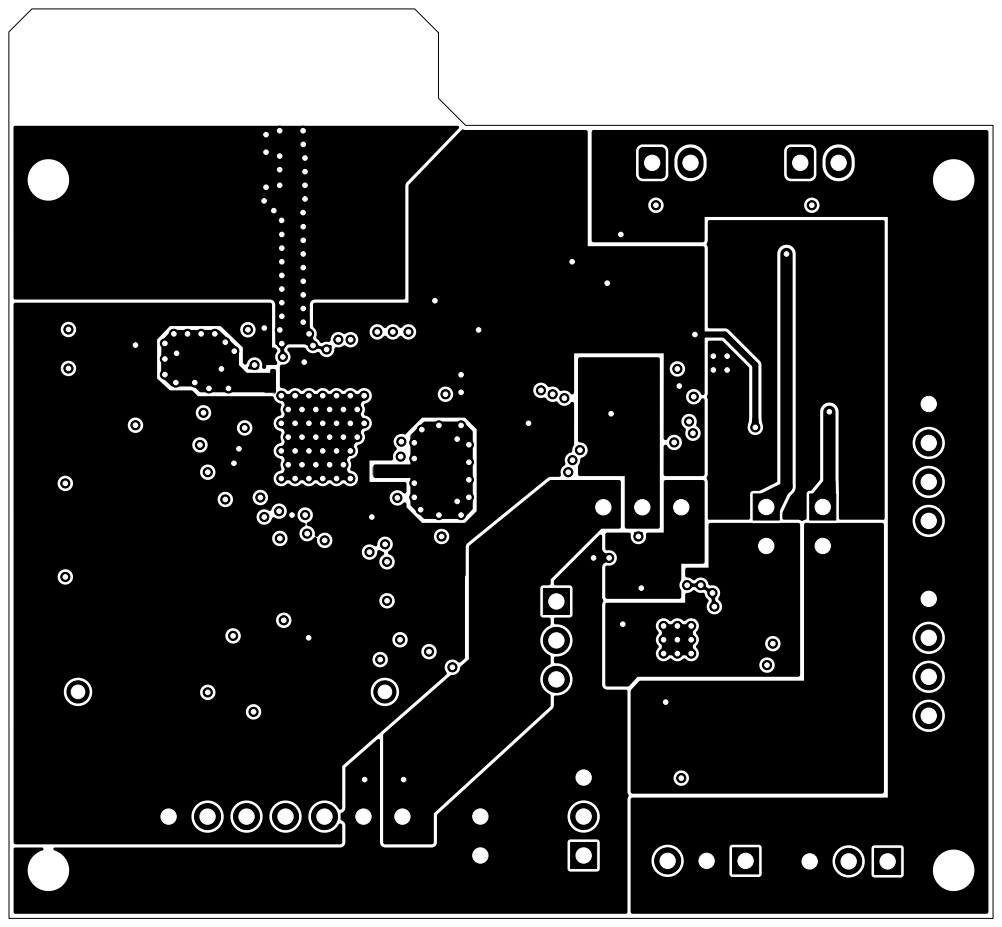
[picture p109: page 3]

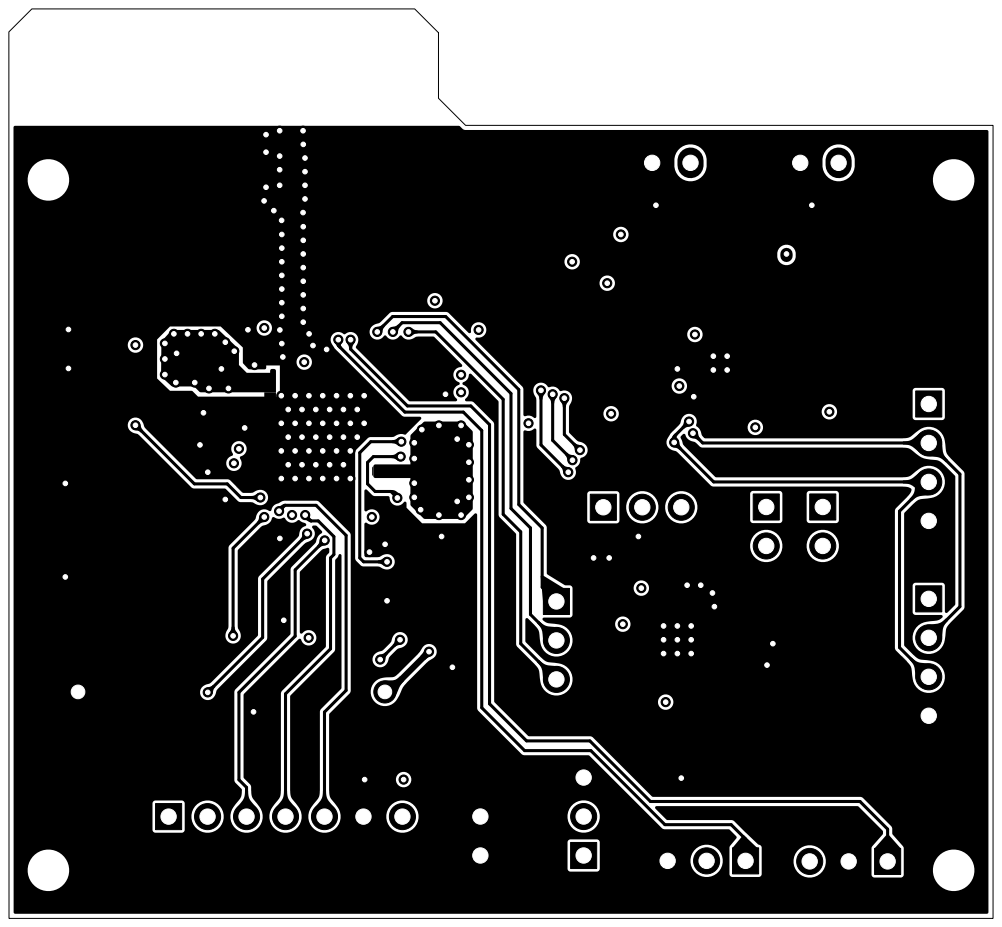
[picture p110: page 4]

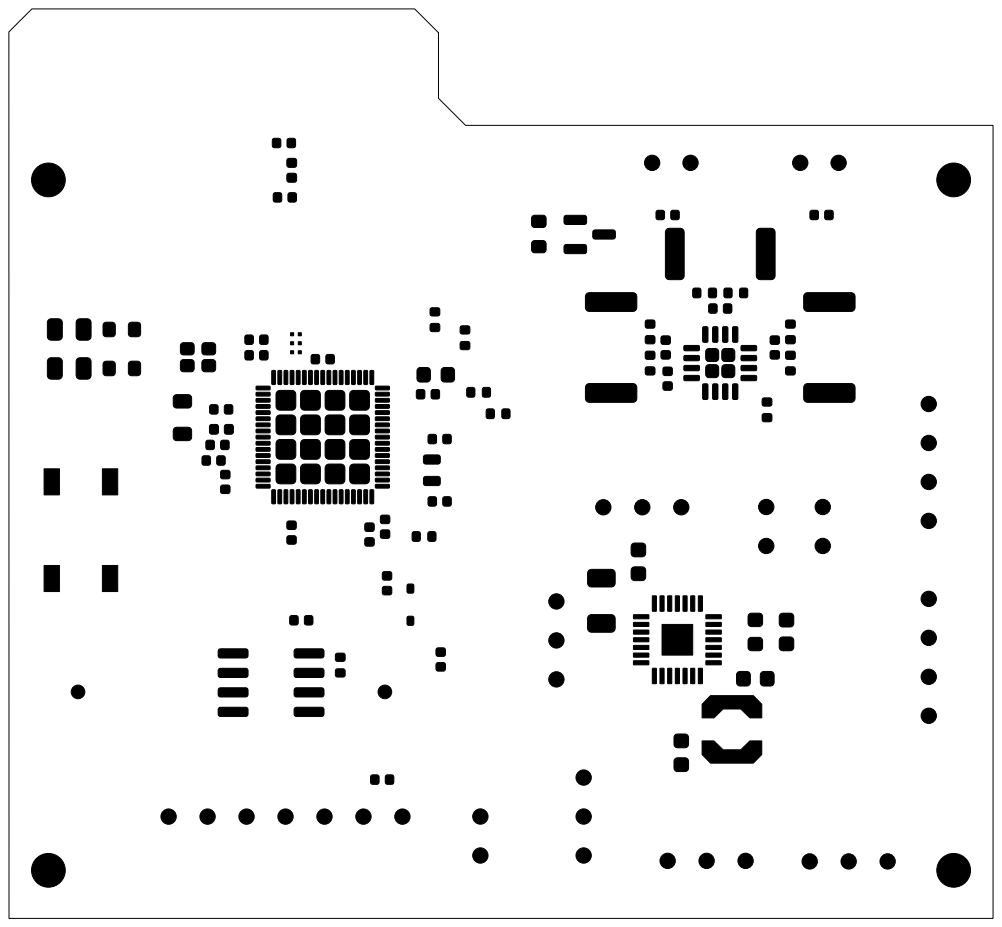
[picture p111: page 5]

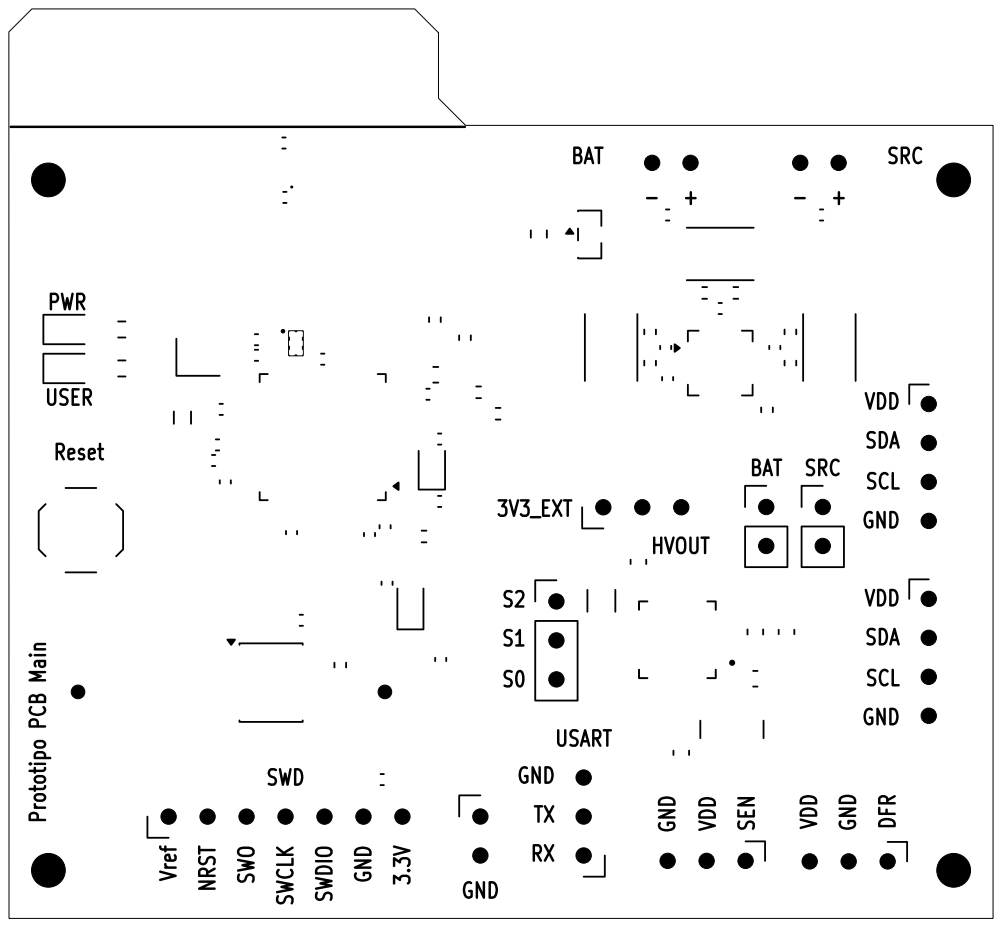
[picture p112: page 6]

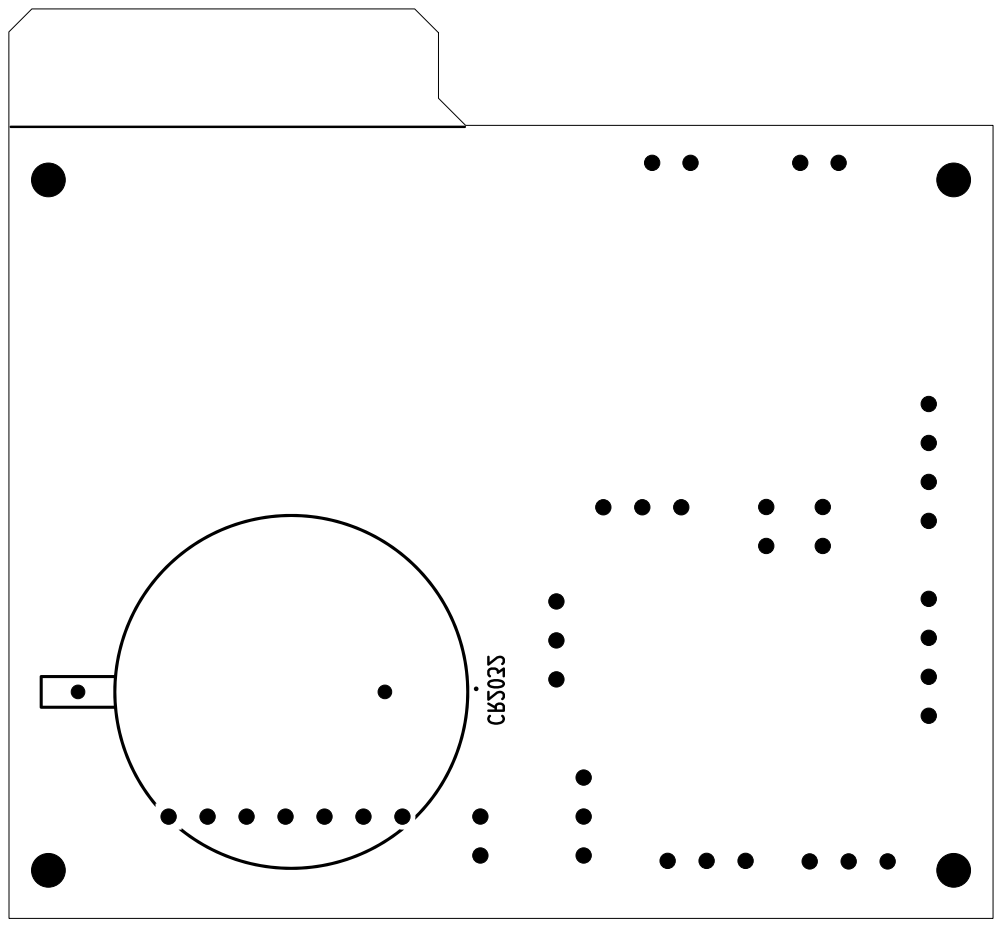
[picture p113: page 7]
