morsoth/TFG-FIB/docs/Nucleo-WB55RG/STM32WB55_QFN68_IPD_REF_BOARD/07-Drill-Drawing/Drill_Drawing_STM32WB55_DB_QFN68_IPD.PDF

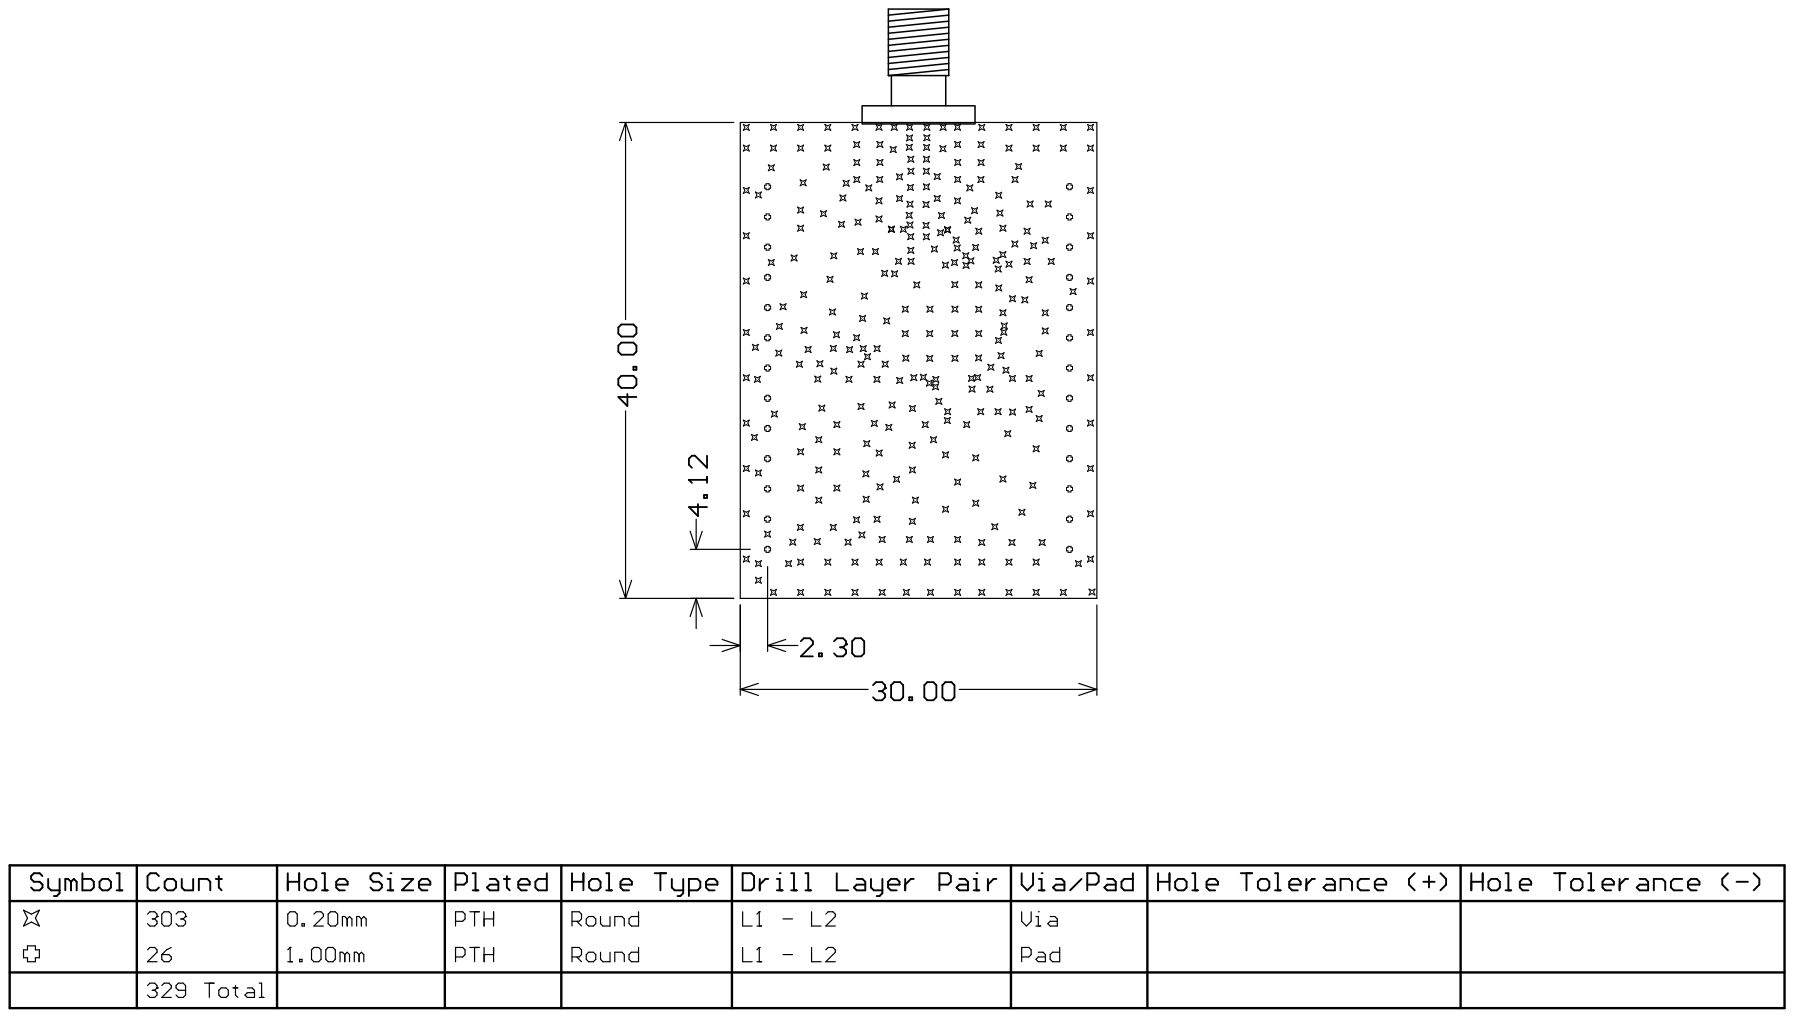
[picture p114: page 1]
