morsoth/TFG-FIB/docs/Nucleo-WB55RG/STM32WB55_QFN68_IPD_REF_BOARD/05-Gerber files/Gerber Pdf/Gerber_STM32WB55_DB_QFN68_IPD.PDF

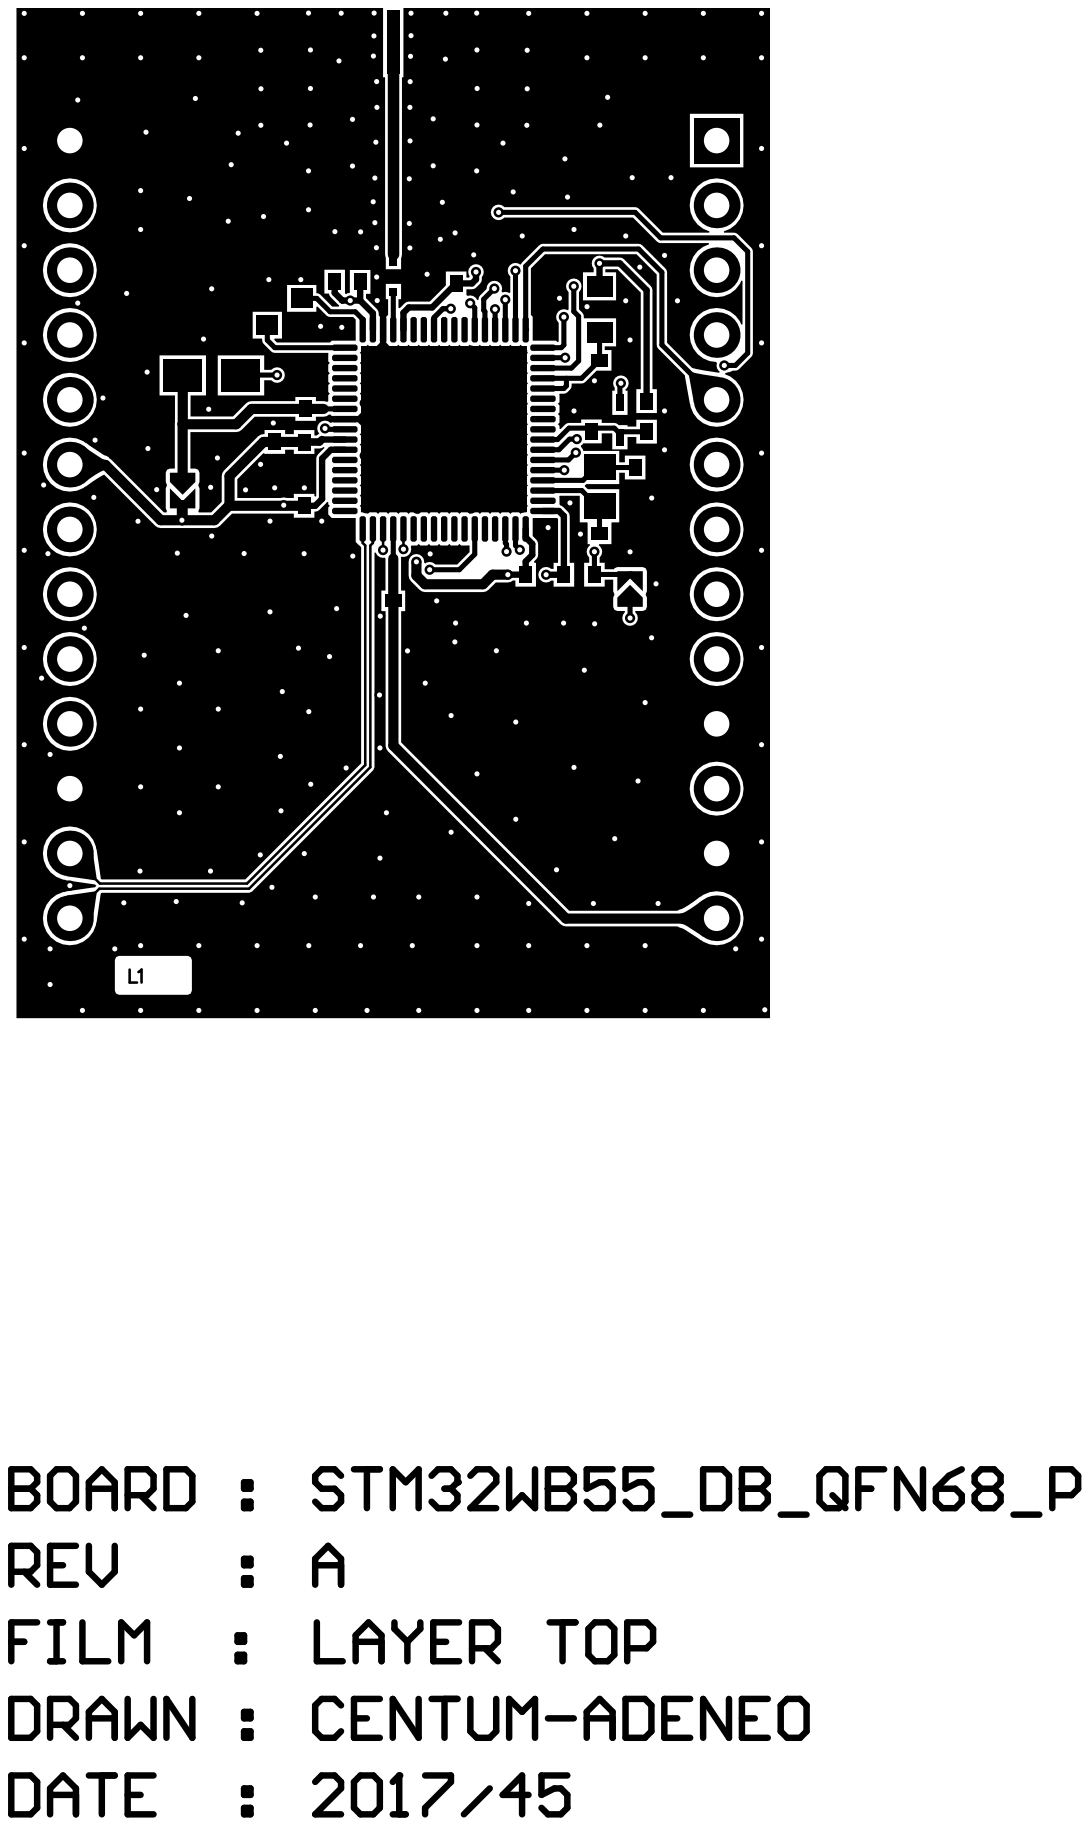
[picture p115: page 1]

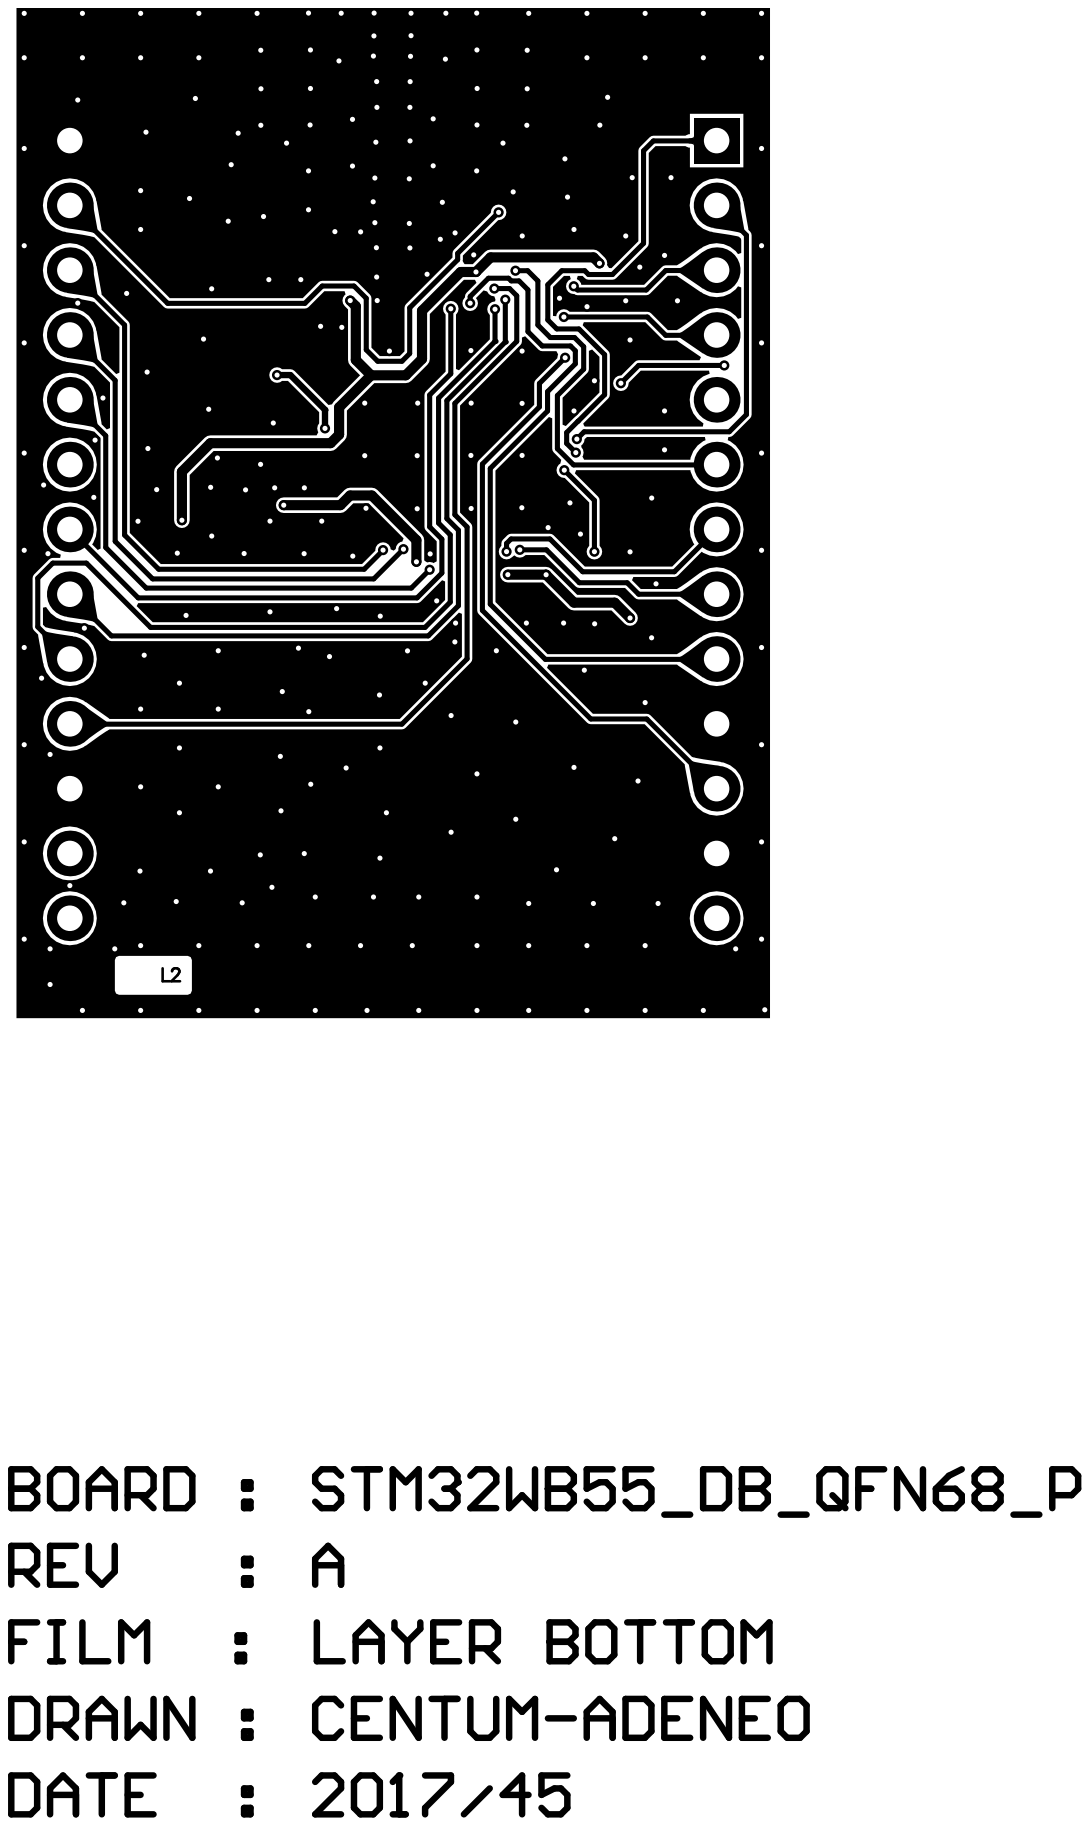
[picture p116: page 2]

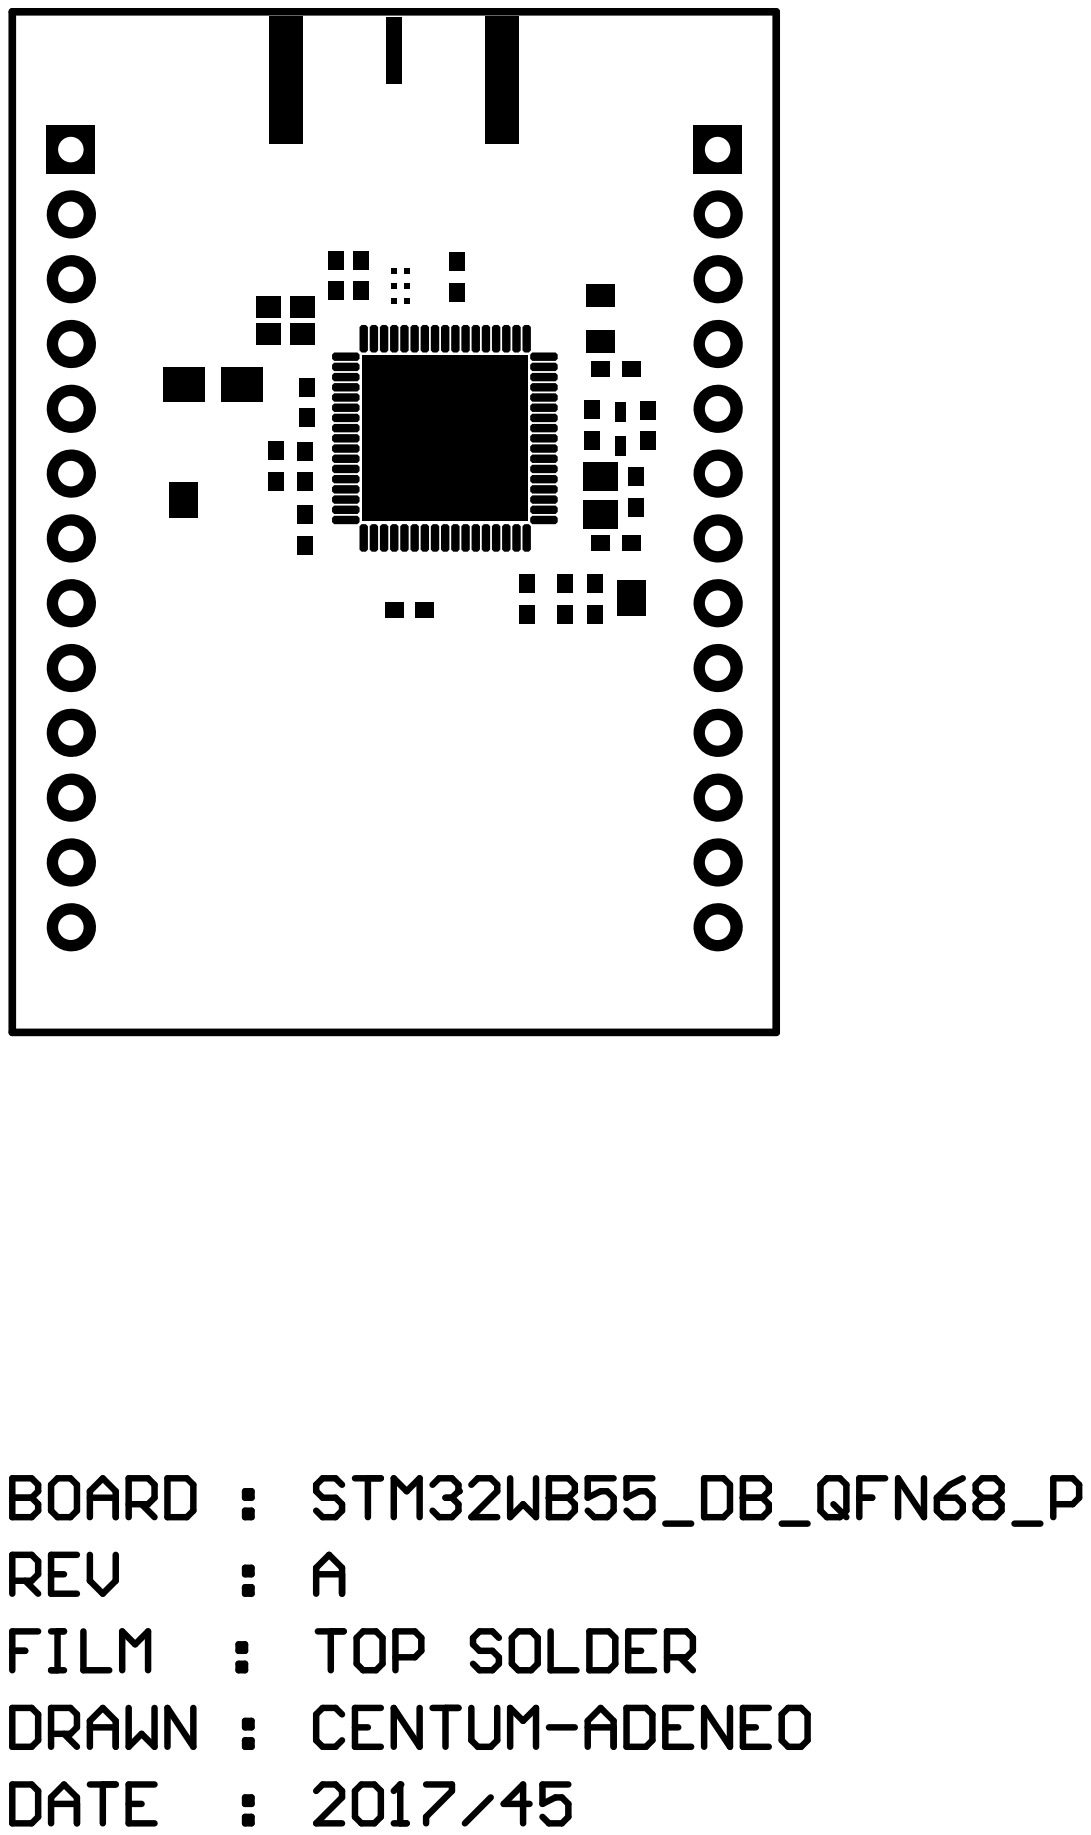
[picture p117: page 3]

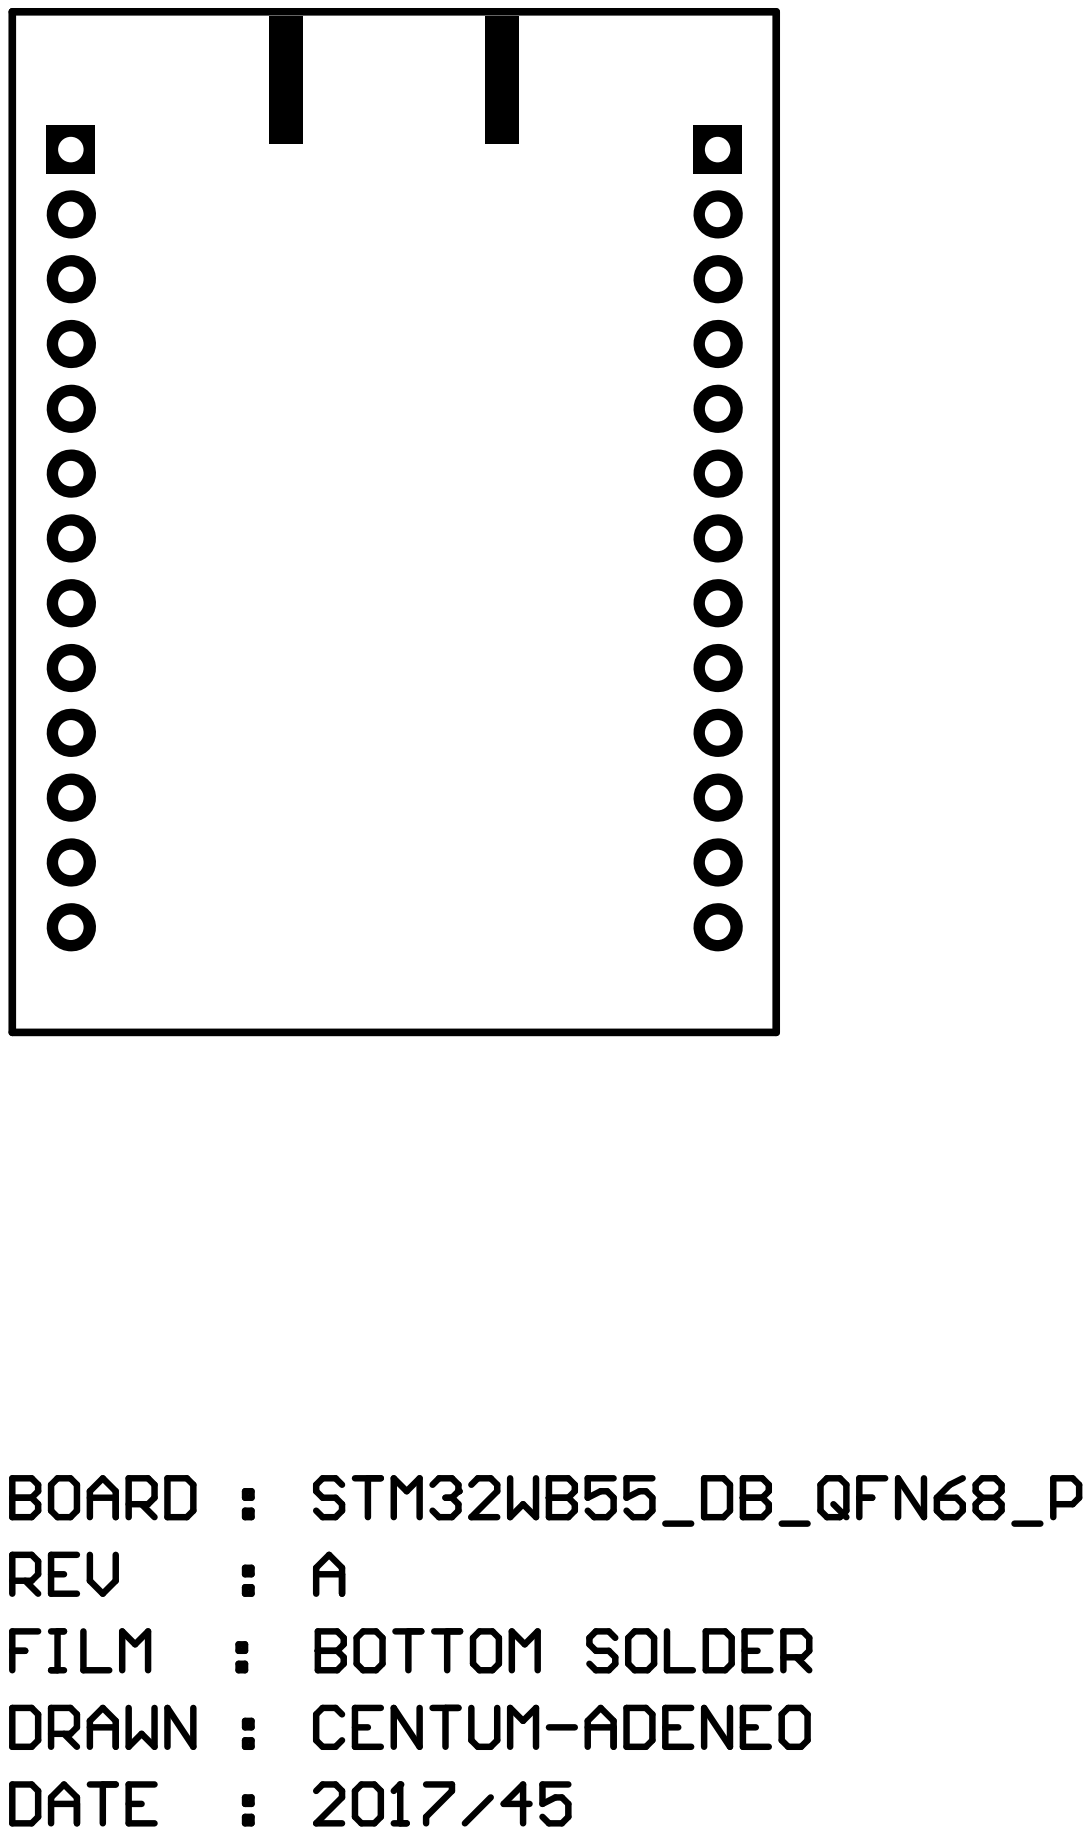
[picture p118: page 4]

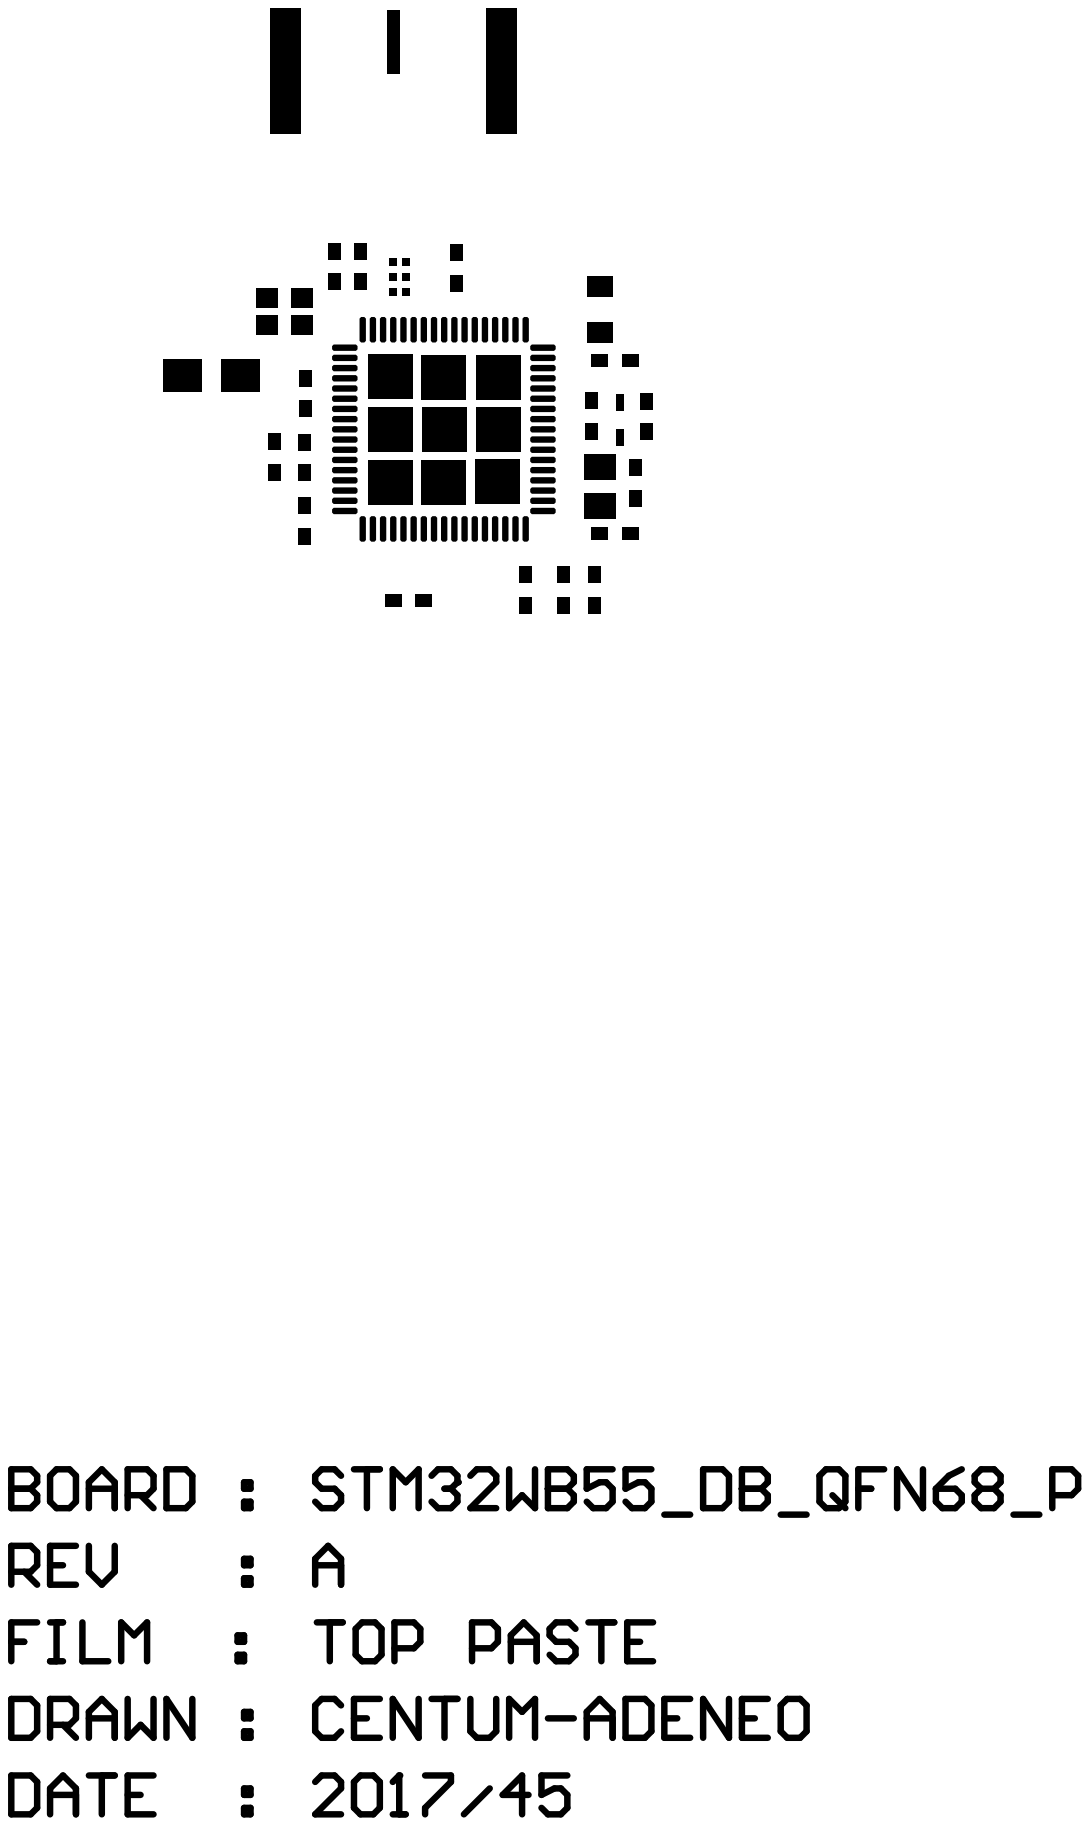
[picture p119: page 5]

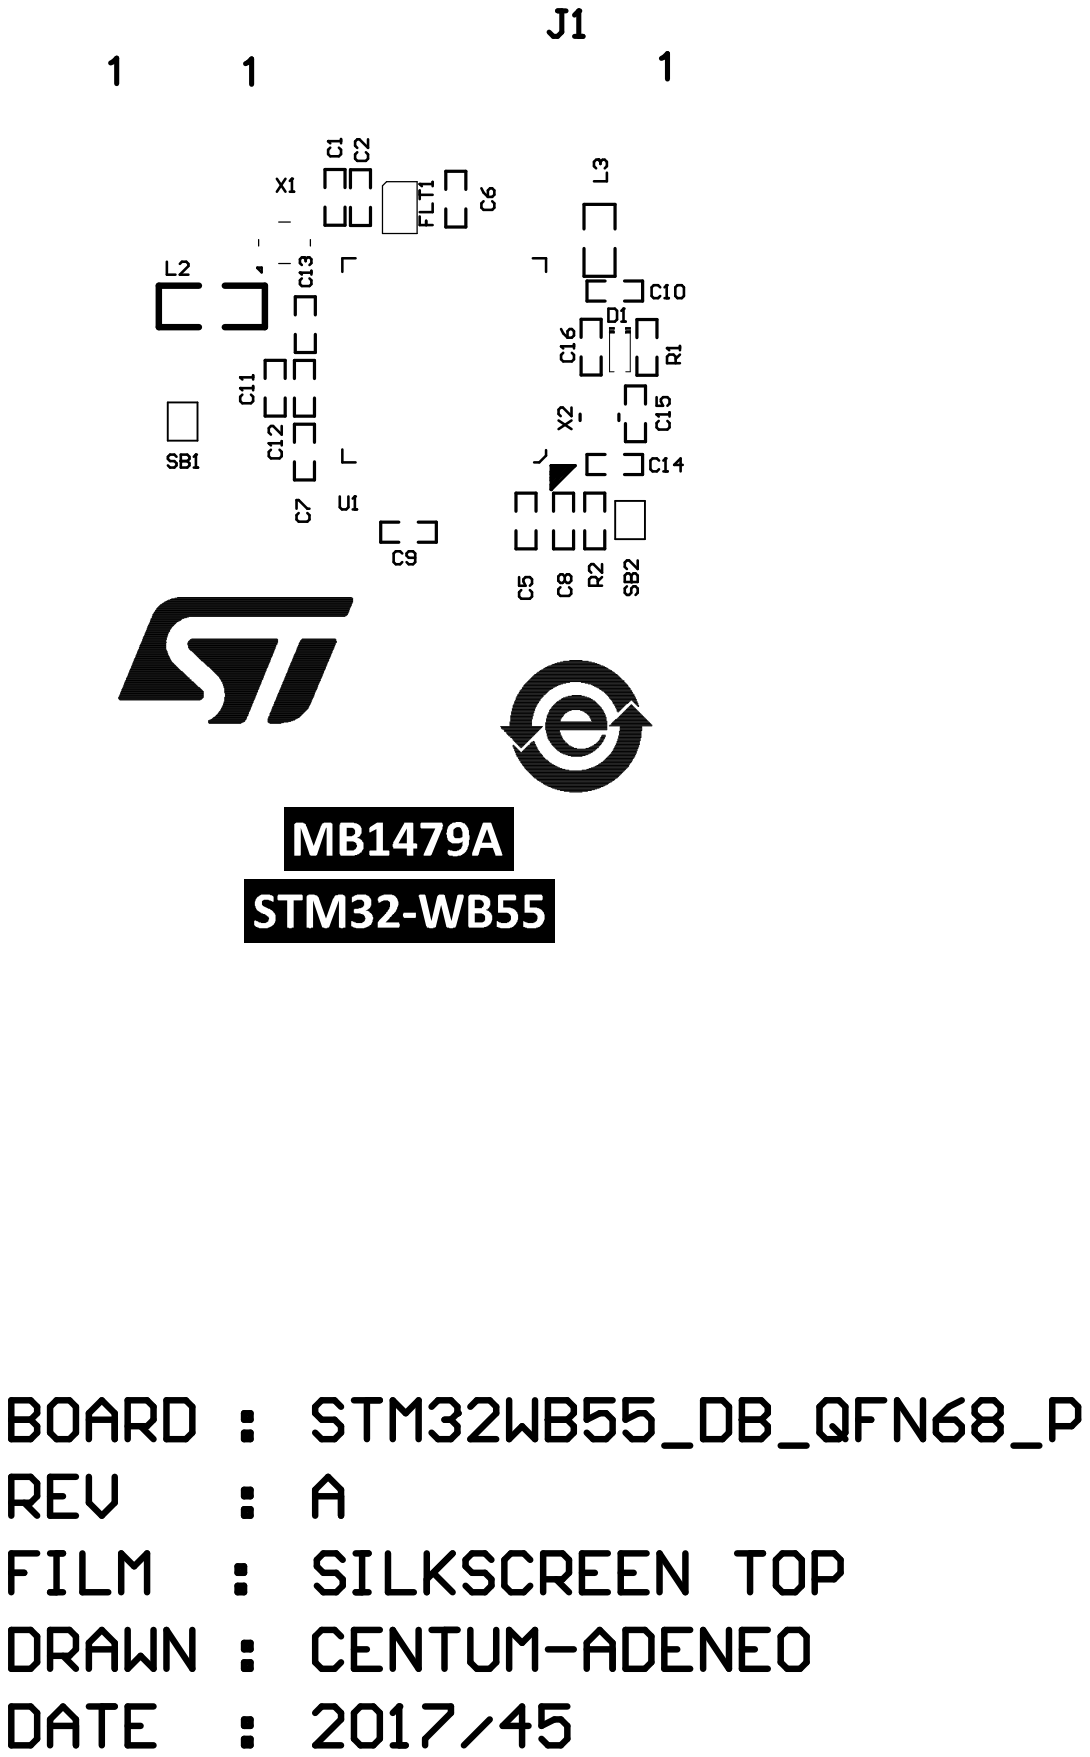
[picture p120: page 6]

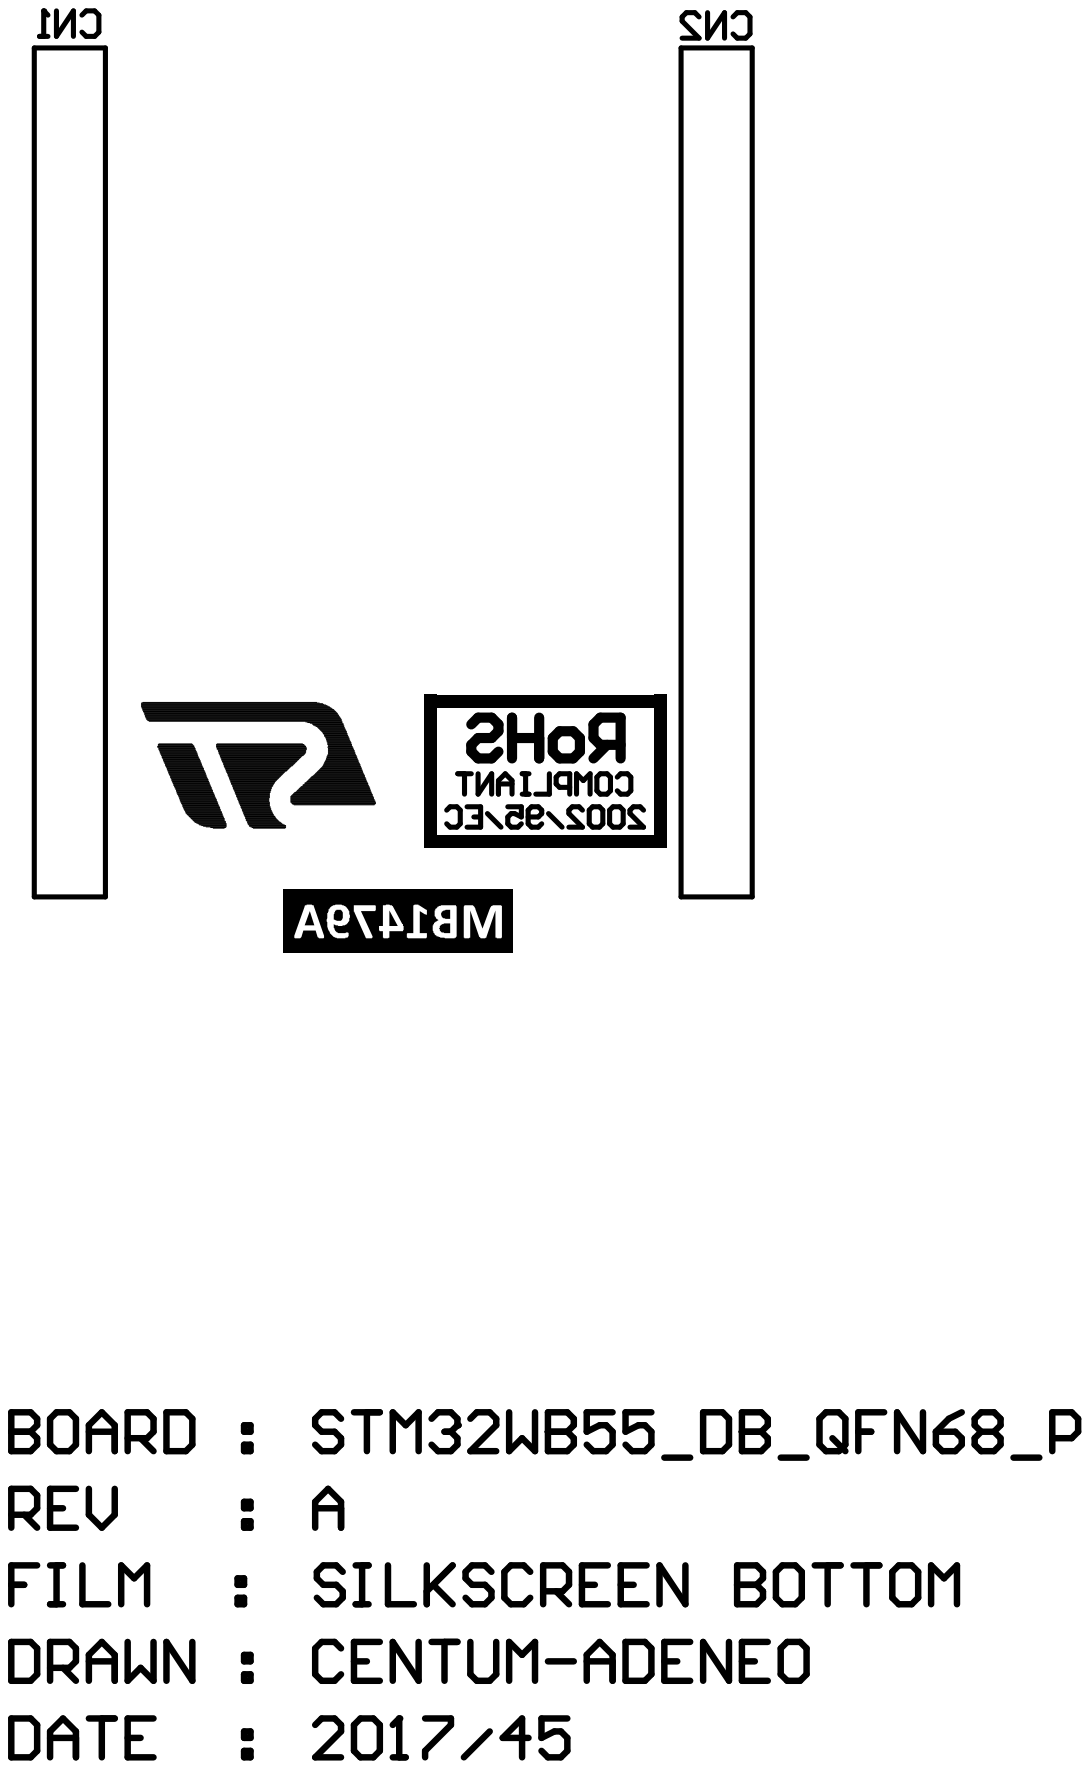
[picture p121: page 7]
