morsoth/TFG-FIB/(list of files, drawings)

Other design files:
docs/Nucleo-WB55RG/Board Manufacturing/MB1355D/Extension_CN.SchDoc
docs/Nucleo-WB55RG/Board Manufacturing/MB1355D/MB1355.PrjPcb
docs/Nucleo-WB55RG/Board Manufacturing/MB1355D/MCU.SchDoc
docs/Nucleo-WB55RG/Board Manufacturing/MB1355D/Power_Management.SchDoc
docs/Nucleo-WB55RG/Board Manufacturing/MB1355D/Project_Overview.SchDoc
docs/Nucleo-WB55RG/Board Manufacturing/MB1355D/RF.SchDoc
docs/Nucleo-WB55RG/Board Manufacturing/MB1355D/ST_LINK_V2-1.SCHDOC
docs/Nucleo-WB55RG/STM32WB55_QFN68_IPD_REF_BOARD/03-Placement routage-PcbDoc/STM32WB55_DB_QFN68_IPD.PcbDoc
