morsoth/TFG-FIB/pcb/PCB Main/PCB Main.kicad_pcb

## KiCad design pcb/PCB Main/PCB Main.kicad_pcb (2026-01-12)

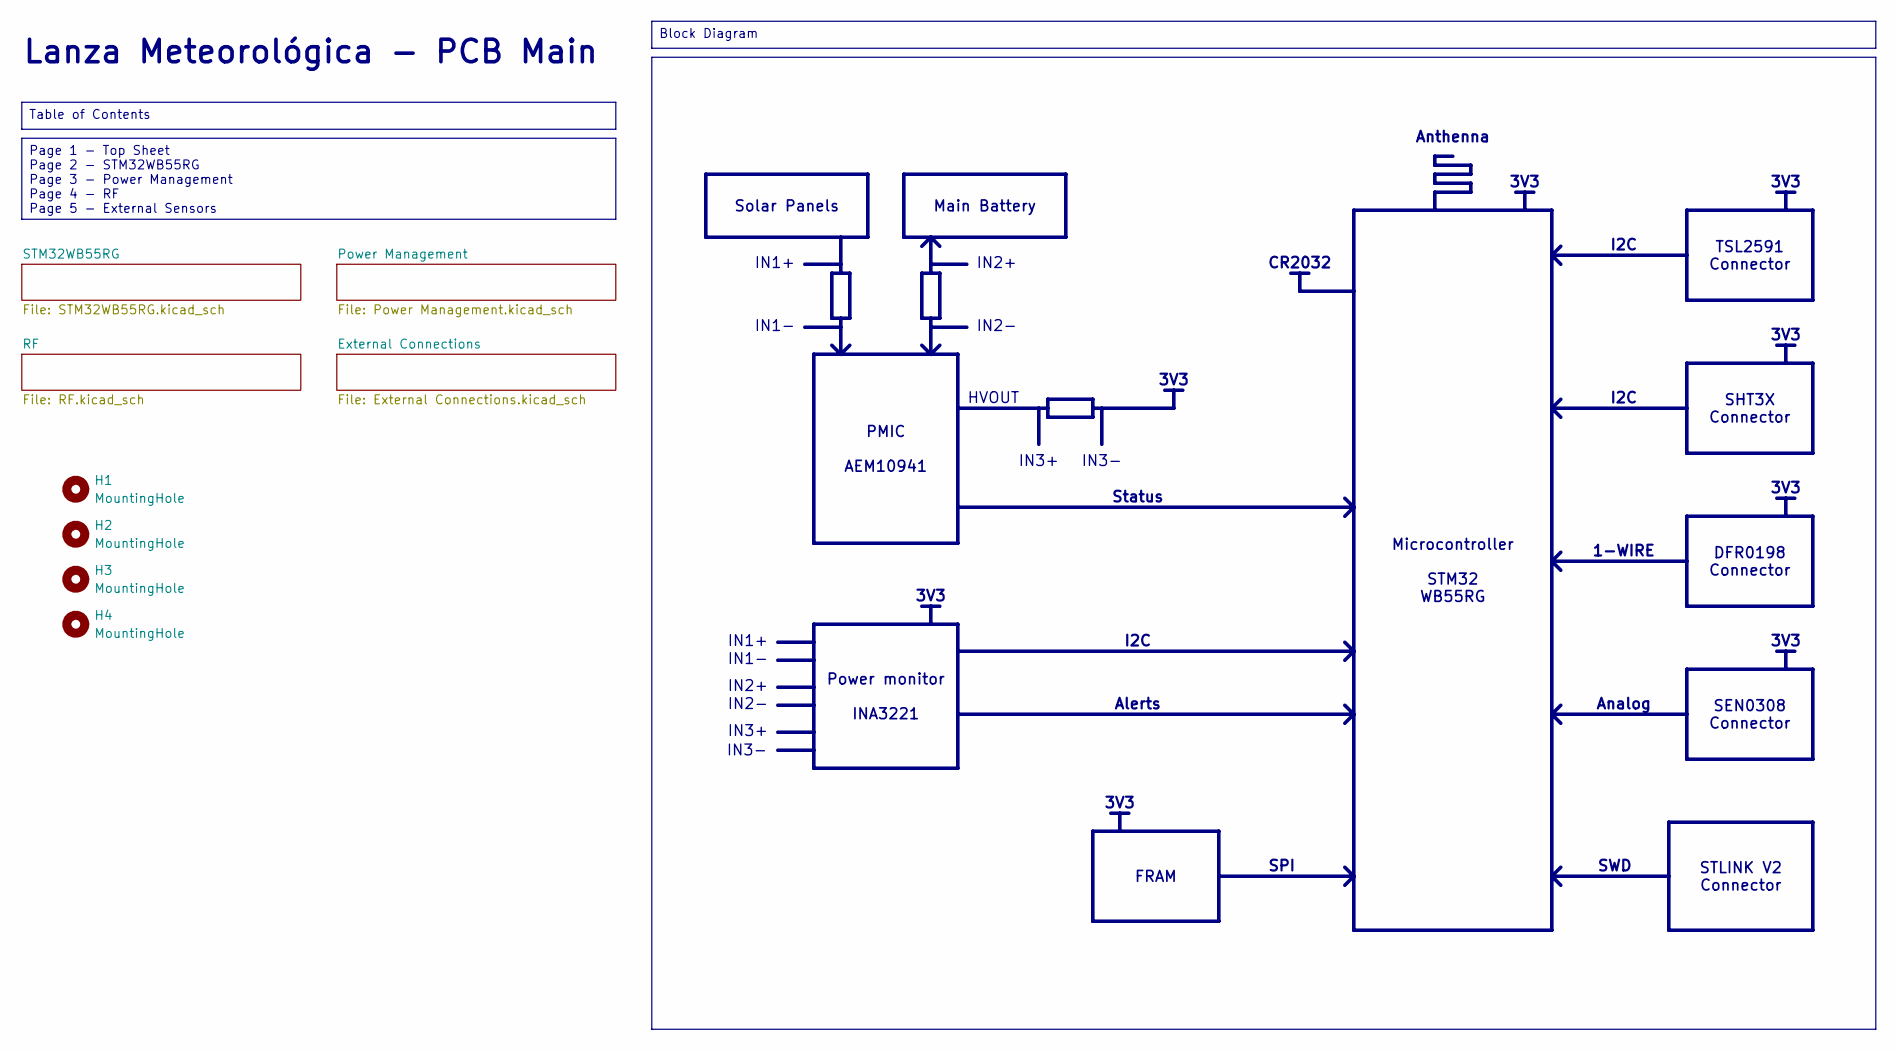
[picture p122: schematic PCB Main.kicad_sch, Lanza Meteorológica - PCB Main]

Parts:
H1, H2, H3, H4: MountingHole; MountingHole_2.2mm_M2

Notes on the sheet:
3V3
IN3+
IN2-
SPI
IN1-
Analog
I2C
Anthenna
IN1+
IN3-
Status
Lanza Meteorológica - PCB Main
HVOUT
SWD
IN2+
1-WIRE
Alerts
CR2032
PMIC AEM10941
Page 1 - Top Sheet Page 2 - STM32WB55RG Page 3 - Power Management Page 4 - RF Page 5 - External Sensors
SHT3X Connector
Solar Panels
STLINK V2 Connector
Table of Contents
FRAM
Main Battery
Block Diagram
DFR0198 Connector
Microcontroller STM32 WB55RG
SEN0308 Connector
TSL2591 Connector
Power monitor INA3221

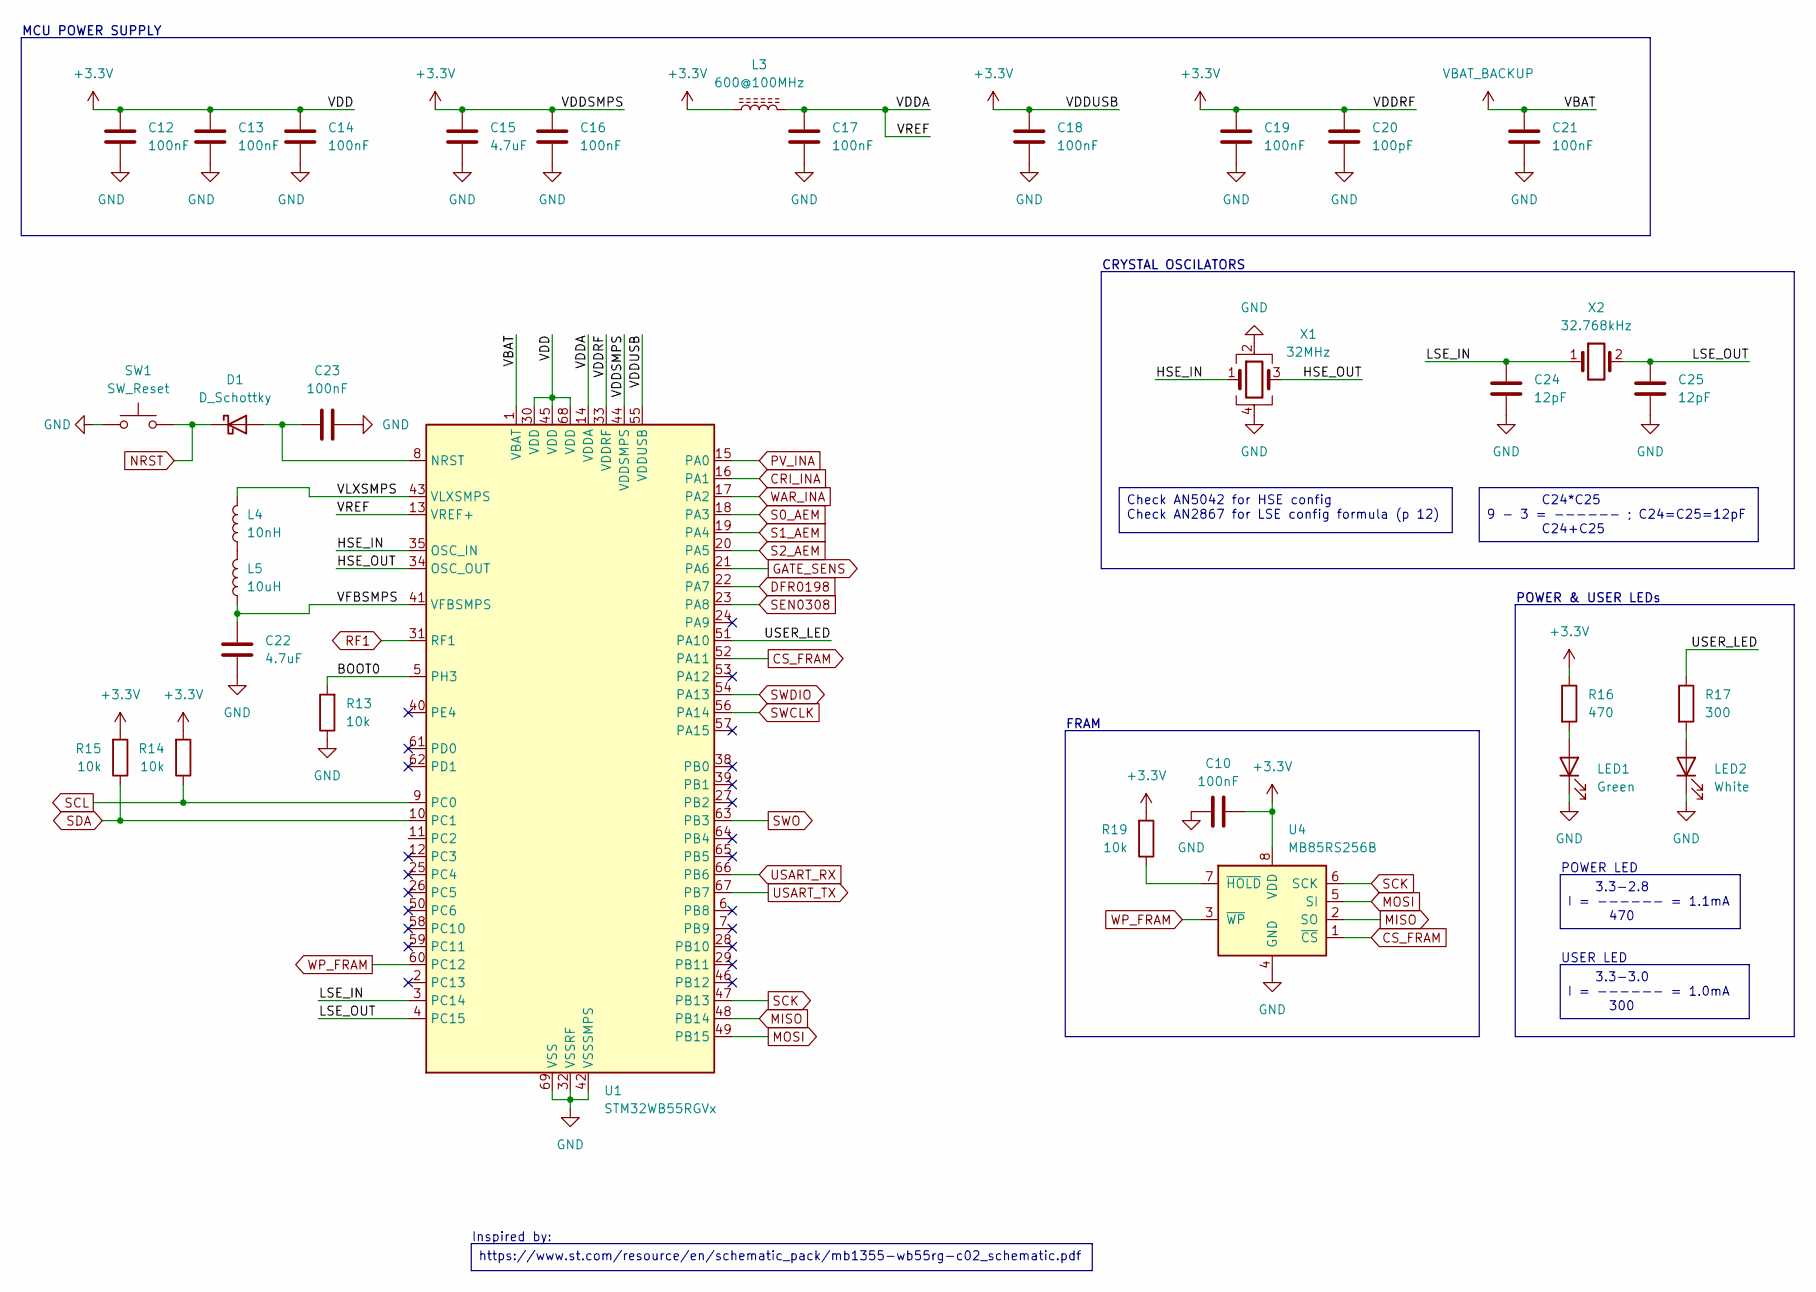
[picture p123: schematic STM32WB55RG.kicad_sch]

Parts:
C10, C12, C13, C14, C16, C17, C18, C19, C21, C23: 100nF; C_0402_1005Metric
C15, C22: 4.7uF; C_0402_1005Metric
C20: 100pF; C_0402_1005Metric
C24, C25: 12pF; C_0402_1005Metric
D1: D_Schottky; D_SOD-323
L3: 600@100MHz; L_0603_1608Metric
L4: 10nH; L_0402_1005Metric
L5: 10uH; L_0805_2012Metric
LED1: Green; LED_0805_2012Metric
LED2: White; LED_0805_2012Metric
R13, R14, R15, R19: 10k; R_0402_1005Metric
R16: 470; R_0603_1608Metric
R17: 300; R_0603_1608Metric
SW1: SW_Reset; SW_SPST_TL3342
U1: STM32WB55RGVx; QFN-68-1EP_8x8mm_P0.4mm_EP6.4x6.4mm
U4: MB85RS256B; SOIC-8_3.9x4.9mm_P1.27mm
X1: 32MHz; Crystal_SMD_2016-4Pin_2.0x1.6mm
X2: 32.768kHz; Crystal_SMD_2012-2Pin_2.0x1.2mm

Connections:
+3.3V: C10.1, C12.2, C13.2, C14.2, C15.2, C16.2, C18.2, C19.2, C20.2, L3.1, R14.2, R15.2, R16.1, R19.2, U1.30 (VDD), U1.33 (VDDRF), U1.44 (VDDSMPS), U1.45 (VDD), U1.55 (VDDUSB), U1.68 (VDD), U4.8 (VDD); also elsewhere on the board
/STM32WB55RG/BOOT0: R13.2, U1.5 (PH3)
/STM32WB55RG/HSE_IN: U1.35 (OSC_IN), X1.1
/STM32WB55RG/HSE_OUT: U1.34 (OSC_OUT), X1.3
/STM32WB55RG/LSE_IN: C24.2, U1.3 (PC14), X2.1
/STM32WB55RG/LSE_OUT: C25.2, U1.4 (PC15), X2.2
/STM32WB55RG/USER_LED: R17.1, U1.51 (PA10)
/STM32WB55RG/VDDA: C17.2, L3.2, U1.13 (VREF+), U1.14 (VDDA)
/STM32WB55RG/VFBSMPS: C22.2, L5.1, U1.41 (VFBSMPS)
/STM32WB55RG/VLXSMPS: L4.2, U1.43 (VLXSMPS)
CRI_INA: U1.16 (PA1); also elsewhere on the board
CS_FRAM: U1.52 (PA11), U4.1 (~CS)
DFR0198: U1.22 (PA7); also elsewhere on the board
GATE_SENS: U1.21 (PA6); also elsewhere on the board
GND: C10.2, C12.1, C13.1, C14.1, C15.1, C16.1, C17.1, C18.1, C19.1, C20.1, C21.1, C22.1, C23.1, C24.1, C25.1, LED1.1 (K), LED2.1 (K), R13.1, SW1.1, U1.32 (VSSRF), U1.42 (VSSSMPS), U1.69 (VSS), U4.4 (GND), X1.2, X1.4; also elsewhere on the board
MISO: U1.48 (PB14), U4.2 (SO)
MOSI: U1.49 (PB15), U4.5 (SI)
NRST: D1.1 (K), SW1.2; also elsewhere on the board
unnamed: C23.2, D1.2 (A), U1.8 (NRST)
unnamed: L4.1, L5.2
unnamed: LED1.2 (A), R16.2
unnamed: LED2.2 (A), R17.2
unnamed: R19.1, U4.7 (~HOLD)
PV_INA: U1.15 (PA0); also elsewhere on the board
RF1: U1.31 (RF1); also elsewhere on the board
S0_AEM: U1.18 (PA3); also elsewhere on the board
S1_AEM: U1.19 (PA4); also elsewhere on the board
S2_AEM: U1.20 (PA5); also elsewhere on the board
SCK: U1.47 (PB13), U4.6 (SCK)
SCL: R14.1, U1.9 (PC0); also elsewhere on the board
SDA: R15.1, U1.10 (PC1); also elsewhere on the board
SEN0308: U1.23 (PA8); also elsewhere on the board
SWCLK: U1.56 (PA14); also elsewhere on the board
SWDIO: U1.54 (PA13); also elsewhere on the board
SWO: U1.63 (PB3); also elsewhere on the board
USART_RX: U1.66 (PB6); also elsewhere on the board
USART_TX: U1.67 (PB7); also elsewhere on the board
VBAT_BACKUP: C21.2, U1.1 (VBAT); also elsewhere on the board
WAR_INA: U1.17 (PA2); also elsewhere on the board
WP_FRAM: U1.60 (PC12), U4.3 (~WP)

Notes on the sheet:
Inspired by:
CRYSTAL OSCILATORS
POWER & USER LEDs
FRAM
POWER LED
USER LED
MCU POWER SUPPLY
3.3-2.8 I = ------ = 1.1mA 470
https://www.st.com/resource/en/schematic_pack/mb1355-wb55rg-c02_schematic.pdf
Check AN5042 for HSE config Check AN2867 for LSE config formula (p 12)
3.3-3.0 I = ------ = 1.0mA 300
C24*C25 9 - 3 = ------ ; C24=C25=12pF C24+C25

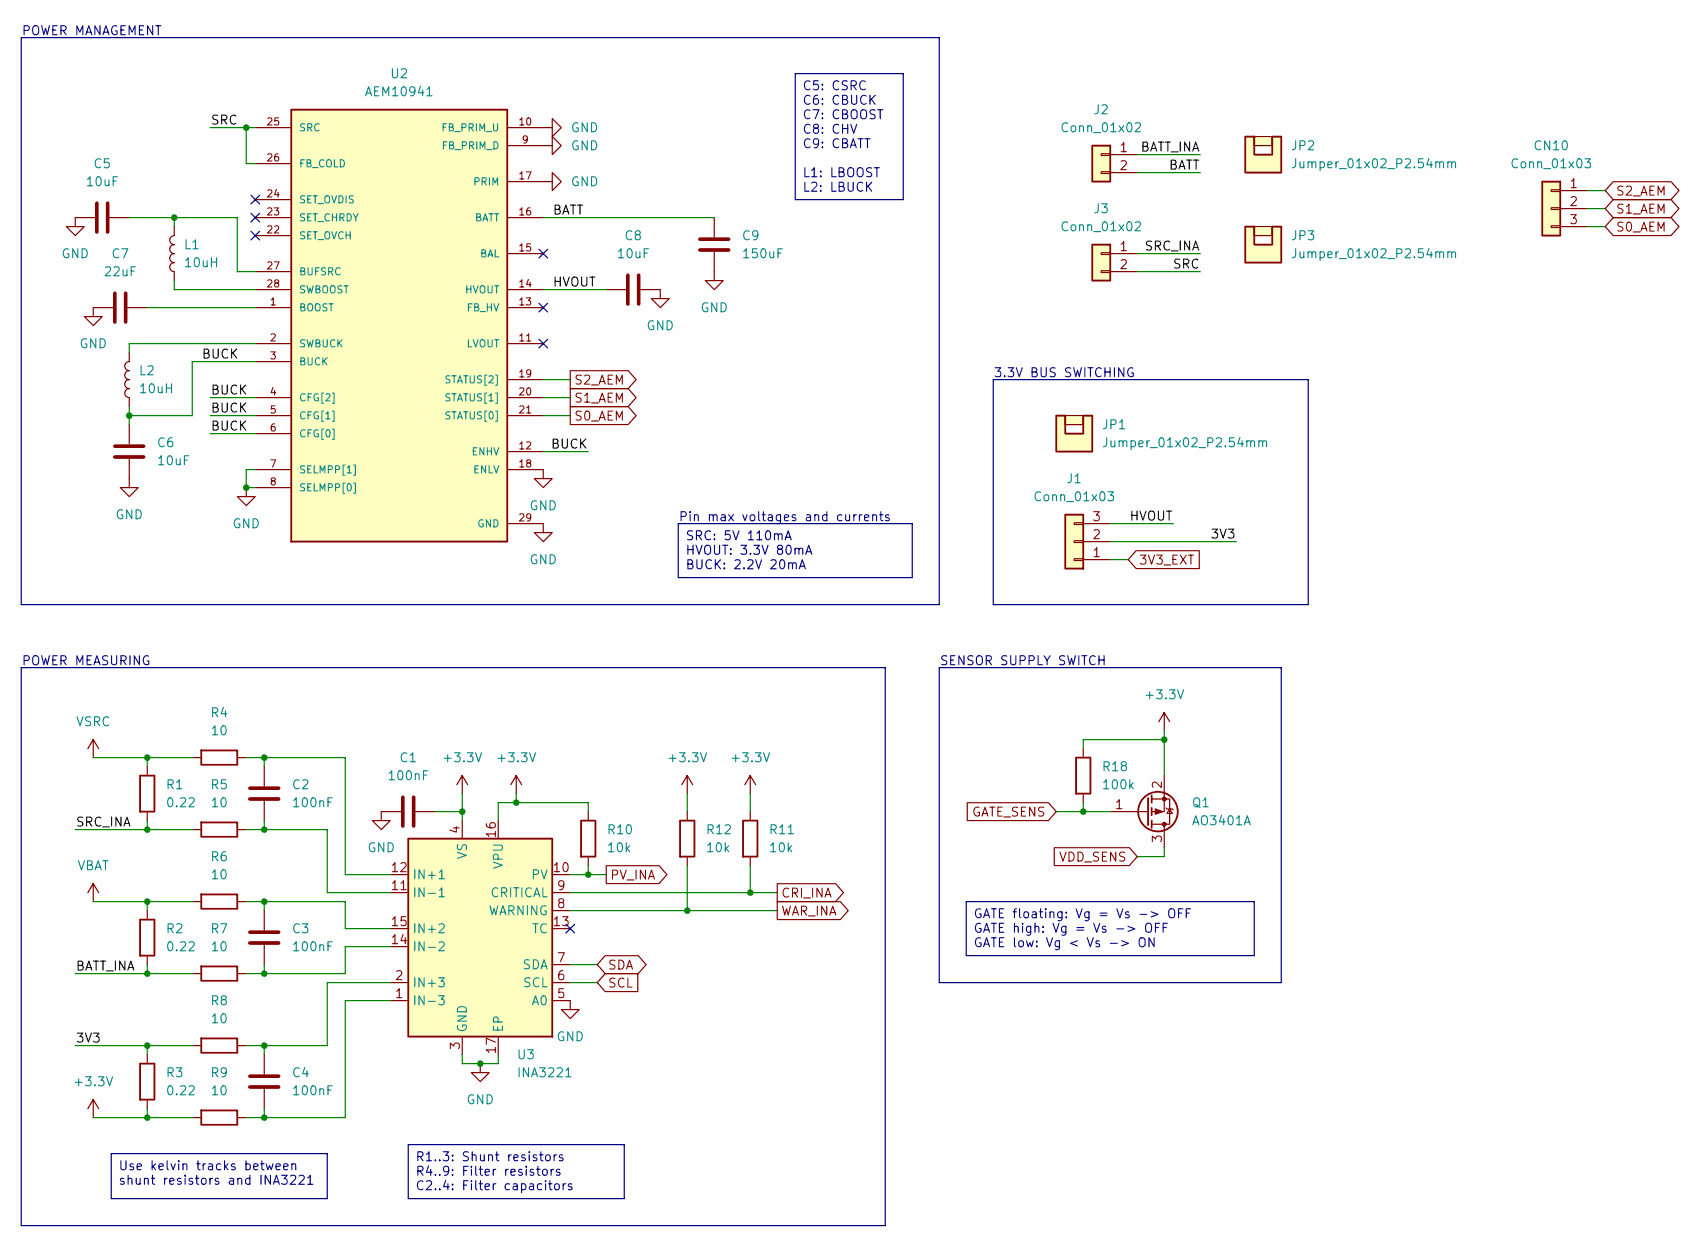
[picture p124: schematic Power Management.kicad_sch]

Parts:
C1, C2, C3, C4: 100nF; C_0402_1005Metric
C5, C6, C8: 10uF; C_0603_1608Metric
C7: 22uF; C_0603_1608Metric
C9: 150uF; C_1206_3216Metric
CN10: Conn_01x03; PinHeader_1x03_P2.54mm_Vertical
J1: Conn_01x03; PinHeader_1x03_P2.54mm_Vertical
J2, J3: Conn_01x02; PinHeader_1x02_P2.54mm_Vertical
JP1, JP2, JP3: Jumper_01x02_P2.54mm
L1: 10uH; L_Coilcraft_LPS4018
L2: 10uH; L_0603_1608Metric
Q1: AO3401A; SOT-23
R1, R2, R3: 0.22; R_2512_6332Metric
R4, R5, R6, R7, R8, R9: 10; R_0402_1005Metric
R10, R11, R12: 10k; R_0402_1005Metric
R18: 100k; R_0603_1608Metric
U2: AEM10941; QFN50P500X500X90-29N
U3: INA3221; Texas_RGV0016A_VQFN-16-1EP_4x4mm_P0.65mm_EP2.1x2.1mm

Connections:
3V3_EXT: J1.1; also elsewhere on the board
+3.3V: C1.2, Q1.2 (S), R3.2, R9.2, R10.1, R11.1, R12.1, R18.1, U3.4 (VS), U3.16 (VPU); also elsewhere on the board
/Power Management/3V3: J1.2, R3.1, R8.2
/Power Management/BATT: C9.1, J2.2, U2.16 (BATT)
/Power Management/BATT_INA: J2.1, R2.2, R7.2
/Power Management/BUCK: C6.1, L2.1, U2.3 (BUCK), U2.4 (CFG[2]), U2.5 (CFG[1]), U2.6 (CFG[0]), U2.12 (ENHV)
/Power Management/HVOUT: C8.2, J1.3, U2.14 (HVOUT)
/Power Management/SRC: J3.2, U2.25 (SRC), U2.26 (FB_COLD)
/Power Management/SRC_INA: J3.1, R1.2, R5.2
CRI_INA: R11.2, U3.9 (CRITICAL); also elsewhere on the board
GATE_SENS: Q1.1 (G), R18.2; also elsewhere on the board
GND: C1.1, C5.2, C6.2, C7.2, C8.1, C9.2, U2.7 (SELMPP[1]), U2.8 (SELMPP[0]), U2.9 (FB_PRIM_D), U2.10 (FB_PRIM_U), U2.17 (PRIM), U2.18 (ENLV), U2.29 (GND), U3.3 (GND), U3.5 (A0), U3.17 (EP); also elsewhere on the board
unnamed: C7.1, U2.1 (BOOST)
unnamed: C5.1, L1.2, U2.27 (BUFSRC)
unnamed: L1.1, U2.28 (SWBOOST)
unnamed: L2.2, U2.2 (SWBUCK)
unnamed: C2.2, R4.1, U3.12 (IN+1)
unnamed: C3.2, R6.1, U3.15 (IN+2)
unnamed: C4.2, R8.1, U3.2 (IN+3)
unnamed: C2.1, R5.1, U3.11 (IN-1)
unnamed: C3.1, R7.1, U3.14 (IN-2)
unnamed: C4.1, R9.1, U3.1 (IN-3)
PV_INA: R10.2, U3.10 (PV); also elsewhere on the board
S0_AEM: CN10.3, U2.21 (STATUS[0]); also elsewhere on the board
S1_AEM: CN10.2, U2.20 (STATUS[1]); also elsewhere on the board
S2_AEM: CN10.1, U2.19 (STATUS[2]); also elsewhere on the board
SCL: U3.6 (SCL); also elsewhere on the board
SDA: U3.7 (SDA); also elsewhere on the board
VBAT: R2.1, R6.2; also elsewhere on the board
VDD_SENS: Q1.3 (D); also elsewhere on the board
VSRC: R1.1, R4.2; also elsewhere on the board
WAR_INA: R12.2, U3.8 (WARNING); also elsewhere on the board

Notes on the sheet:
SENSOR SUPPLY SWITCH
3.3V BUS SWITCHING
POWER MANAGEMENT
Pin max voltages and currents
POWER MEASURING
SRC: 5V 110mA HVOUT: 3.3V 80mA BUCK: 2.2V 20mA
Use kelvin tracks between shunt resistors and INA3221
C5: CSRC C6: CBUCK C7: CBOOST C8: CHV C9: CBATT L1: LBOOST L2: LBUCK
R1..3: Shunt resistors R4..9: Filter resistors C2..4: Filter capacitors
GATE floating: Vg = Vs -> OFF GATE high: Vg = Vs -> OFF GATE low: Vg < Vs -> ON

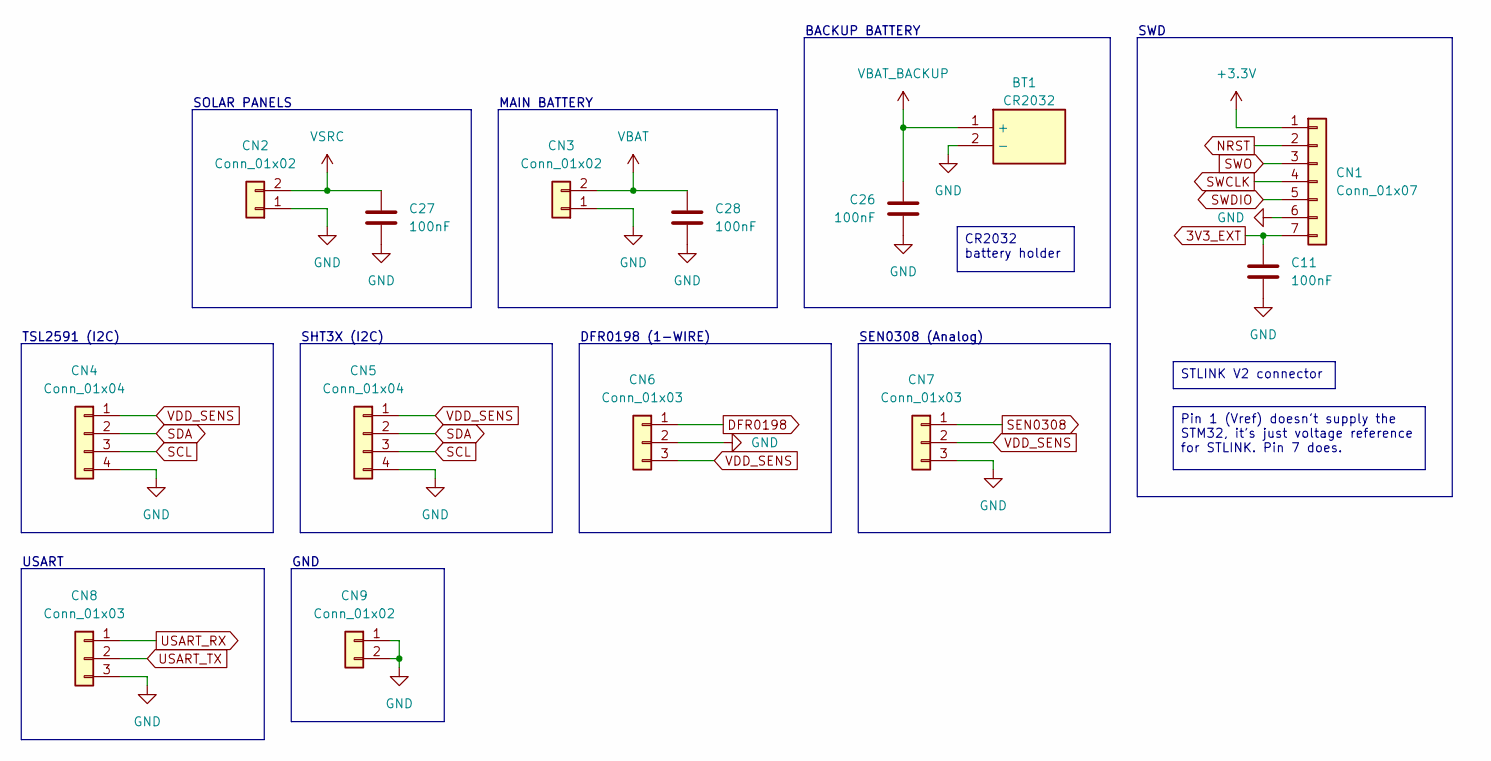
[picture p125: schematic External Connections.kicad_sch]

Parts:
BT1: CR2032; 1066
C11, C26, C27, C28: 100nF; C_0402_1005Metric
CN1: Conn_01x07; PinHeader_1x07_P2.54mm_Vertical
CN2, CN3: Conn_01x02; JST_EH_S2B-EH_1x02_P2.50mm_Horizontal
CN4, CN5: Conn_01x04; PinHeader_1x04_P2.54mm_Horizontal
CN6, CN7: Conn_01x03; PinHeader_1x03_P2.54mm_Horizontal
CN8: Conn_01x03; PinHeader_1x03_P2.54mm_Vertical
CN9: Conn_01x02; PinHeader_1x02_P2.54mm_Vertical

Connections:
3V3_EXT: C11.2, CN1.7; also elsewhere on the board
+3.3V: CN1.1; also elsewhere on the board
DFR0198: CN6.1; also elsewhere on the board
GND: BT1.2 (-), C11.1, C26.1, C27.1, C28.1, CN1.6, CN2.1, CN3.1, CN4.4, CN5.4, CN6.2, CN7.3, CN8.3, CN9.1, CN9.2; also elsewhere on the board
NRST: CN1.2; also elsewhere on the board
SCL: CN4.3, CN5.3; also elsewhere on the board
SDA: CN4.2, CN5.2; also elsewhere on the board
SEN0308: CN7.1; also elsewhere on the board
SWCLK: CN1.4; also elsewhere on the board
SWDIO: CN1.5; also elsewhere on the board
SWO: CN1.3; also elsewhere on the board
USART_RX: CN8.1; also elsewhere on the board
USART_TX: CN8.2; also elsewhere on the board
VBAT: C28.2, CN3.2; also elsewhere on the board
VBAT_BACKUP: BT1.1 (+), C26.2; also elsewhere on the board
VDD_SENS: CN4.1, CN5.1, CN6.3, CN7.2; also elsewhere on the board
VSRC: C27.2, CN2.2; also elsewhere on the board

Notes on the sheet:
MAIN BATTERY
SEN0308 (Analog)
SHT3X (I2C)
BACKUP BATTERY
DFR0198 (1-WIRE)
GND
SOLAR PANELS
SWD
TSL2591 (I2C)
USART
STLINK V2 connector
Pin 1 (Vref) doesn't supply the STM32, it's just voltage reference for STLINK. Pin 7 does.
CR2032 battery holder

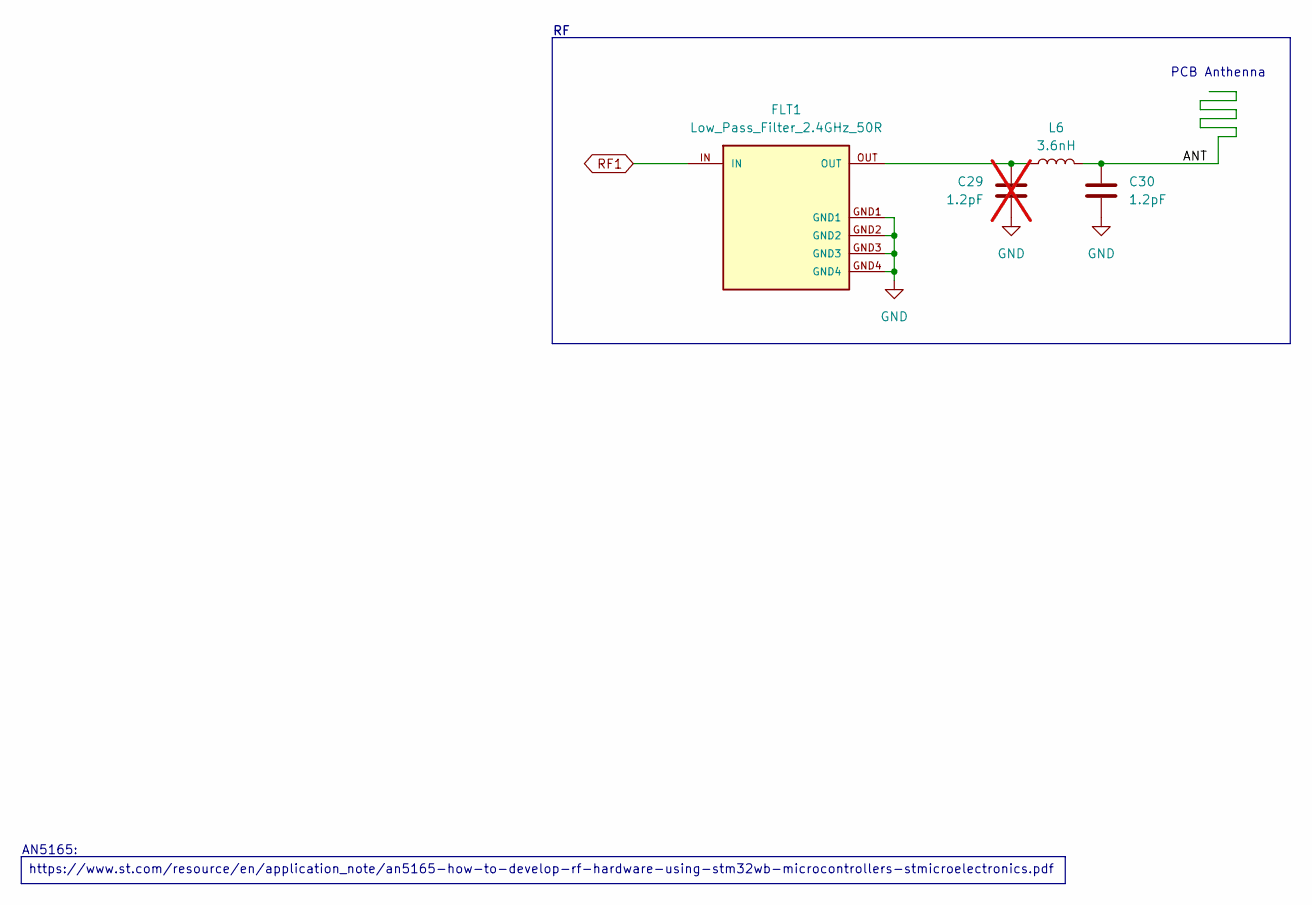
[picture p126: schematic RF.kicad_sch]

Parts:
C29: 1.2pF; C_0402_1005Metric; not fitted
C30: 1.2pF; C_0402_1005Metric
FLT1: Low_Pass_Filter_2.4GHz_50R; MLPF-WB55-01E3
L6: 3.6nH; LED_0402_1005Metric

Connections:
/RF/ANT: C30.2, L6.2
GND: C29.1, C30.1, FLT1.GND1, FLT1.GND2, FLT1.GND3, FLT1.GND4; also elsewhere on the board
unnamed: C29.2, FLT1.OUT, L6.1
RF1: FLT1.IN; also elsewhere on the board

Notes on the sheet:
PCB Anthenna
AN5165:
https://www.st.com/resource/en/application_note/an5165-how-to-develop-rf-hardware-using-stm32wb-microcontrollers-stmicroelectronics.pdf

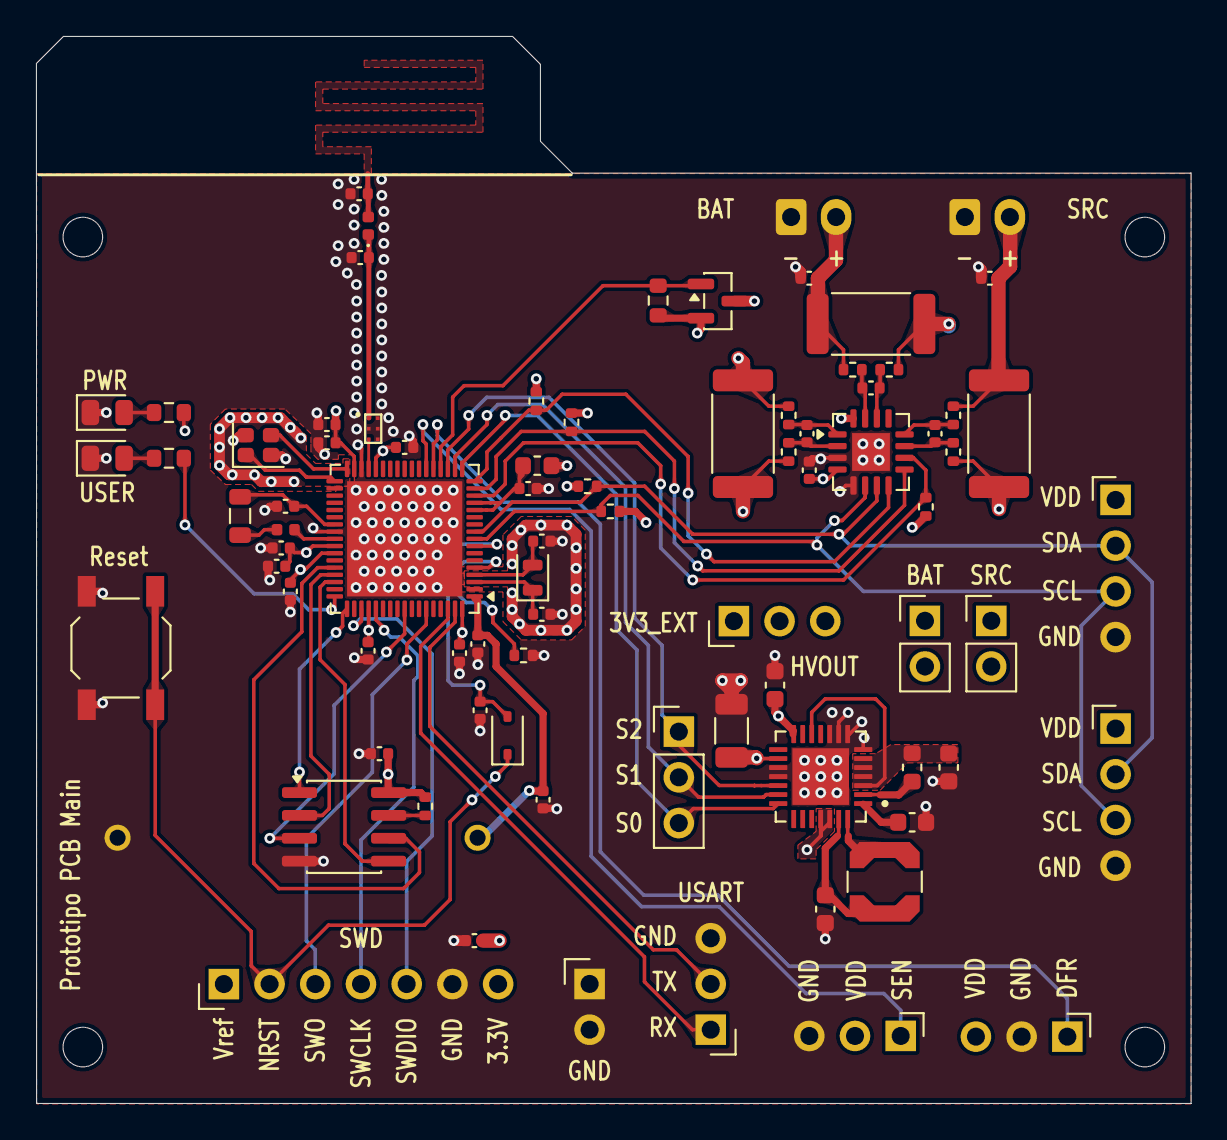
[picture p127: board PCB Main.kicad_pcb from above]

Board: 4 copper layers, 64.1 x 59.3 mm, 85 parts (1 on the bottom side), 63 nets.
