morsoth/TFG-FIB/pcb/Harvest Testing/Harvest Testing.kicad_pcb

## KiCad design pcb/Harvest Testing/Harvest Testing.kicad_pcb (2025-10-23)

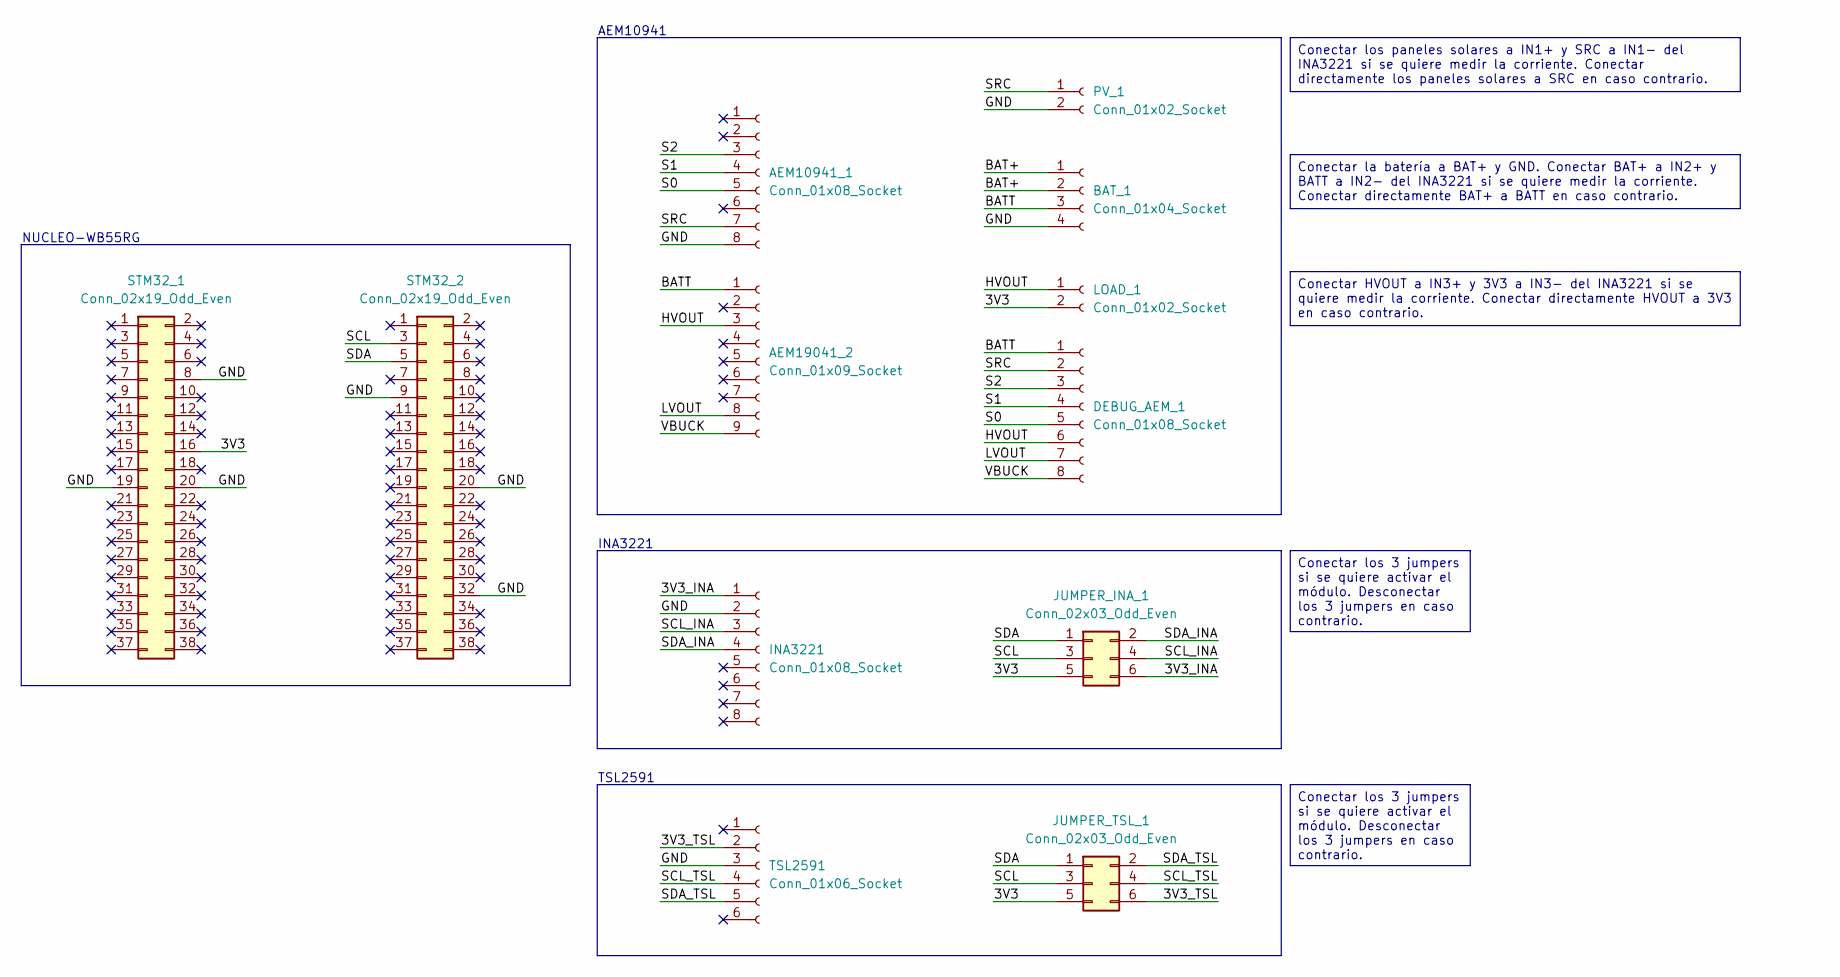
[picture p128: schematic Harvest Testing.kicad_sch]

Parts:
AEM10941_1: Conn_01x08_Socket; PinSocket_1x08_P2.54mm_Vertical
AEM19041_2: Conn_01x09_Socket; PinSocket_1x09_P2.54mm_Vertical
BAT_1: Conn_01x04_Socket; PinSocket_1x04_P2.54mm_Vertical
DEBUG_AEM_1: Conn_01x08_Socket; PinHeader_1x08_P2.54mm_Vertical
INA3221: Conn_01x08_Socket; PinSocket_1x08_P2.54mm_Vertical
JUMPER_INA_1: Conn_02x03_Odd_Even; PinHeader_2x03_P2.54mm_Vertical
JUMPER_TSL_1: Conn_02x03_Odd_Even; PinHeader_2x03_P2.54mm_Vertical
LOAD_1: Conn_01x02_Socket; PinSocket_1x02_P2.54mm_Vertical
PV_1: Conn_01x02_Socket; PinSocket_1x02_P2.54mm_Vertical
STM32_1, STM32_2: Conn_02x19_Odd_Even; PinSocket_2x19_P2.54mm_Vertical
TSL2591: Conn_01x06_Socket; PinSocket_1x06_P2.54mm_Vertical

Connections:
/3V3: JUMPER_INA_1.5, JUMPER_TSL_1.5, LOAD_1.2, STM32_1.16
/3V3_INA: INA3221.1, JUMPER_INA_1.6
/3V3_TSL: JUMPER_TSL_1.6, TSL2591.2
/BAT+: BAT_1.1, BAT_1.2
/BATT: AEM19041_2.1, BAT_1.3, DEBUG_AEM_1.1
/GND: AEM10941_1.8, BAT_1.4, INA3221.2, PV_1.2, STM32_1.8, STM32_1.19, STM32_1.20, STM32_2.9, STM32_2.20, STM32_2.32, TSL2591.3
/HVOUT: AEM19041_2.3, DEBUG_AEM_1.6, LOAD_1.1
/LVOUT: AEM19041_2.8, DEBUG_AEM_1.7
/S0: AEM10941_1.5, DEBUG_AEM_1.5
/S1: AEM10941_1.4, DEBUG_AEM_1.4
/S2: AEM10941_1.3, DEBUG_AEM_1.3
/SCL: JUMPER_INA_1.3, JUMPER_TSL_1.3, STM32_2.3
/SCL_INA: INA3221.3, JUMPER_INA_1.4
/SCL_TSL: JUMPER_TSL_1.4, TSL2591.4
/SDA: JUMPER_INA_1.1, JUMPER_TSL_1.1, STM32_2.5
/SDA_INA: INA3221.4, JUMPER_INA_1.2
/SDA_TSL: JUMPER_TSL_1.2, TSL2591.5
/SRC: AEM10941_1.7, DEBUG_AEM_1.2, PV_1.1
/VBUCK: AEM19041_2.9, DEBUG_AEM_1.8

Notes on the sheet:
TSL2591
AEM10941
NUCLEO-WB55RG
INA3221
Conectar la batería a BAT+ y GND. Conectar BAT+ a IN2+ y BATT a IN2- del INA3221 si se quiere medir la corriente. Conectar directamente BAT+ a BATT en caso contrario.
Conectar HVOUT a IN3+ y 3V3 a IN3- del INA3221 si se quiere medir la corriente. Conectar directamente HVOUT a 3V3 en caso contrario.
Conectar los 3 jumpers si se quiere activar el módulo. Desconectar los 3 jumpers en caso contrario.
Conectar los paneles solares a IN1+ y SRC a IN1- del INA3221 si se quiere medir la corriente. Conectar directamente los paneles solares a SRC en caso contrario.

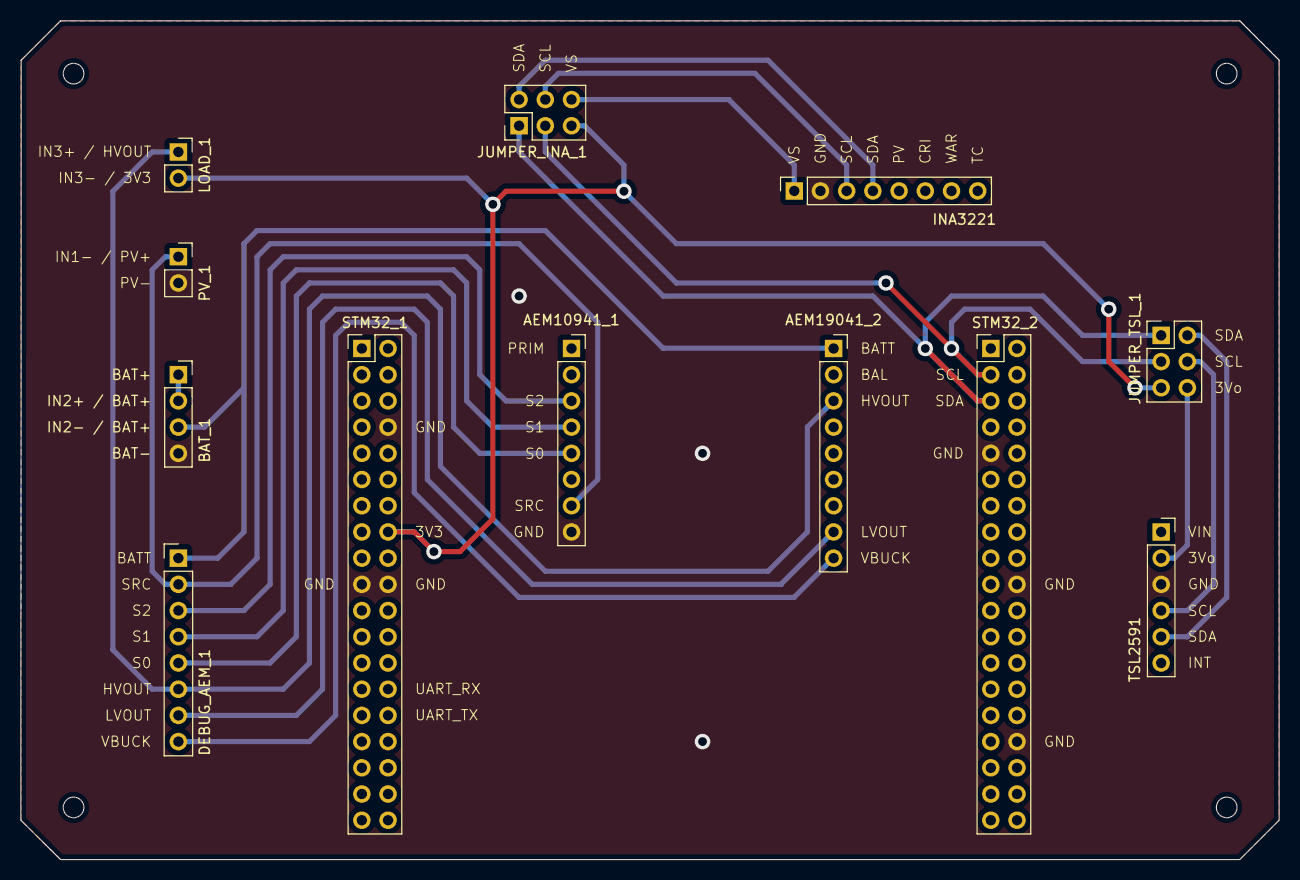
[picture p129: board Harvest Testing.kicad_pcb from above]

Board: 2 copper layers, 121.9 x 81.3 mm, 12 parts (0 on the bottom side), 19 nets.
