morsoth/TFG-FIB/firmware/stm32_lanza_firmware/Core/Src/main.c

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
/* Includes ------------------------------------------------------------------*/
#include "main.h"

/* USER CODE BEGIN Includes */
#include "app.h"
/* USER CODE END Includes */

ADC_HandleTypeDef hadc1;

I2C_HandleTypeDef hi2c3;

RTC_HandleTypeDef hrtc;

SPI_HandleTypeDef hspi2;

UART_HandleTypeDef huart1;

void SystemClock_Config(void);
void PeriphCommonClock_Config(void);
static void MX_GPIO_Init(void);
static void MX_USART1_UART_Init(void);
static void MX_RTC_Init(void);
static void MX_ADC1_Init(void);
static void MX_I2C3_Init(void);
static void MX_SPI2_Init(void);
/* USER CODE BEGIN PFP */
void ADC1_Init() {
	HAL_ADC_DeInit(&hadc1);
	HAL_ADC_Init(&hadc1);

	MX_ADC1_Init();
}
/* USER CODE END PFP */

/* USER CODE BEGIN 0 */

// Overwritten function to allow printf() via UART
int _write(int file, char *ptr, int len) {
    HAL_UART_Transmit(&huart1, (uint8_t*)ptr, len, HAL_MAX_DELAY);
    return len;
}
/* USER CODE END 0 */

/**
  * @brief  The application entry point.
  * @retval int
  */
int main(void)
{

  /* MCU Configuration--------------------------------------------------------*/

  /* Reset of all peripherals, Initializes the Flash interface and the Systick. */
  HAL_Init();

  /* Configure the system clock */
  SystemClock_Config();

  /* Configure the peripherals common clocks */
  PeriphCommonClock_Config();

  /* Initialize all configured peripherals */
  MX_GPIO_Init();
  MX_USART1_UART_Init();
  MX_RTC_Init();
  MX_ADC1_Init();
  MX_I2C3_Init();
  MX_SPI2_Init();
  /* USER CODE BEGIN 2 */
  setup();
  /* USER CODE END 2 */

  /* Infinite loop */
  /* USER CODE BEGIN WHILE */
  while (1)
  {
    /* USER CODE END WHILE */

    /* USER CODE BEGIN 3 */
	  loop();
  }
  /* USER CODE END 3 */
}

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
