morsoth/TFG-FIB/firmware/stm32_lanza_firmware/stm32_lanza_firmware.ioc

Mcu.UserName=STM32WB55RGVx
PA0.GPIO_Label=PV_INA
PA0.Signal=GPXTI0
PA1.GPIO_Label=CRI_INA
PA1.Signal=GPXTI1
PA10.GPIO_Label=USER_LED
PA10.Signal=GPIO_Output
PA11.GPIO_Label=CS_FRAM
PA11.Signal=GPIO_Output
PA13.Signal=SYS_JTMS-SWDIO
PA14.Signal=SYS_JTCK-SWCLK
PA2.GPIO_Label=WAR_INA
PA2.Signal=GPXTI2
PA3.GPIO_Label=S0_AEM
PA3.Signal=GPXTI3
PA4.GPIO_Label=S1_AEM
PA4.Signal=GPXTI4
PA5.GPIO_Label=S2_AEM
PA5.Signal=GPIO_Input
PA6.GPIO_Label=GATE_SENS
PA6.Signal=GPIO_Output
PA7.GPIO_Label=DFR0198
PA7.Signal=GPIO_Output
PA8.GPIO_Label=SEN0308
PA8.Signal=ADCx_IN15
PB13.Signal=SPI2_SCK
PB14.Signal=SPI2_MISO
PB15.Signal=SPI2_MOSI
PB6.GPIO_Label=USART_RX
PB6.Signal=USART1_TX
PB7.GPIO_Label=USART_TX
PB7.Signal=USART1_RX
PC0.Signal=I2C3_SCL
PC1.Signal=I2C3_SDA
PC12.GPIO_Label=WP_FRAM
PC12.Signal=GPIO_Output
PC14-OSC32_IN.Signal=RCC_OSC32_IN
PC15-OSC32_OUT.Signal=RCC_OSC32_OUT
