morsoth/TFG-FIB/firmware/stm32_lanza_firmware/DS18B20/DS18B20.h

/*
 * DFR0198.h
 *
 *  Created on: Nov 10, 2025
 *      Author: pzaragoza
 */

#ifndef DS18B20_H_
#define DS18B20_H_

#include "stm32wbxx_hal.h"

// ROM commands
#define DS18B20_CMD_SKIP_ROM      0xCC
#define DS18B20_CMD_READ_ROM      0x33
#define DS18B20_CMD_SEARCH_ROM    0xF0
#define DS18B20_CMD_MATCH_ROM     0x55

// Function commands
#define DS18B20_CMD_CONVERT_T	  0x44

#define DS18B20_CMD_READ_SCRATCH  0xBE
#define DS18B20_CMD_WRITE_SCRATCH 0x4E
#define DS18B20_CMD_COPY_SCRATCH  0x48

// Resolution
typedef enum {
    DS18B20_RES_9_BIT  = 0x1F,
    DS18B20_RES_10_BIT = 0x3F,
    DS18B20_RES_11_BIT = 0x5F,
    DS18B20_RES_12_BIT = 0x7F,
} DS18B20_Resolution_t;

// Struct
typedef struct {
    GPIO_TypeDef *port;
    uint16_t pin;
    DS18B20_Resolution_t resolution;
} DS18B20_t;

// Functions
HAL_StatusTypeDef DS18B20_Init(DS18B20_t *dev);

HAL_StatusTypeDef DS18B20_ReadTemperature(DS18B20_t *dev, float *temp_c);
HAL_StatusTypeDef DS18B20_ReadROM(DS18B20_t *dev, uint8_t rom[8]);

#endif /* DS18B20_H_ */
