morsoth/TFG-FIB/(commit log)

2025-10-23 Upload PCB - Haverst testing
    [Harvest Testing.kicad_pcb, Harvest Testing.kicad_sch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]
2025-11-12 all sensors working
2025-12-02 PCB casi lista
    [Extension_CN.SchDoc, External Connections.kicad_sch, MB1355-WB55RG-D01_BOM.xlsx, MB1355.PrjPcb, MCU.SchDoc, PCB Main.csv, PCB Main.kicad_pcb, PCB Main.kicad_sch]
2025-12-02 RF hecho
    [PCB Main.kicad_pcb, RF.kicad_sch]
2025-12-04 vias pad GND
    [PCB Main.kicad_pcb, RF.kicad_sch]
2025-12-04 islas cristales
    [PCB Main.kicad_pcb, STM32WB55RG.kicad_sch]
2025-12-10 pcb sent to jlcpcb
    [External Connections.kicad_sch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]
2026-01-09 cambios :)
    [PCB Main-B_Cu.gbl, PCB Main-B_Mask.gbs, PCB Main-B_Paste.gbp, PCB Main-B_Silkscreen.gbo, PCB Main-Edge_Cuts.gm1, PCB Main-F_Cu.gtl, PCB Main-F_Mask.gts, PCB Main-F_Paste.gtp]
2026-01-12 entrega final
    [PCB Main-B_Cu.gbl, PCB Main-B_Mask.gbs, PCB Main-B_Paste.gbp, PCB Main-B_Silkscreen.gbo, PCB Main-Edge_Cuts.gm1, PCB Main-F_Cu.gtl, PCB Main-F_Mask.gts, PCB Main-F_Paste.gtp]
